MuellerDaniel/SensGlove/SensGlove_noVideo/arduino/LSM303_collectALL/README.txt

Code for data acquisition and sending via BLE of 4 sensor units
