MuellerDaniel/SensGlove/SensGlove_noVideo/arduino/LSMmagMPUquat/README.txt

Trying to cancel the surrounding magnetic field dynamically with the additional MPU sensor
