MuellerDaniel/SensGlove/SensGlove_noVideo/arduino/MagAHRS_MUX_LSM303_Ser/README.txt

Trying to estimate the orientation of the sensor unit solely based on the LSM sensor
