MuellerDaniel/SensGlove/thesis/texfiles/systemDesign.tex

\lhead[\chaptername~\thechapter]{\rightmark}

\rhead[\leftmark]{}

\lfoot[\thepage]{}

\cfoot{}

\rfoot[]{\thepage}

\chapter{System Design and Implementation} \label{cha:sysDesign}

\section{System Design} \label{cha:design}

Ma et al. \cite{ma2010magnetic} describe in their work an approach for hand pose estimation, using permanent magnets and sensors. Since this group is the only one using static magnets for hand state estimation, the design developed in this thesis relies partly on theirs. However, until now the group only presented results for reconstructing the motion of a single finger with six sensors. An image of their setup is shown in \ref{fig:MaSystem}.
\begin{figure}[h]
\centering

\caption[Magnetic system, developed by Ma et al.]
{The System for estimating the movement of one finger with 6 sensors, used by Ma et al. \cite{ma2010magnetic}}
\label{fig:MaSystem}
\end{figure}
The presented system is constructed to estimate the pose of four human fingers, neglecting the thumb (for details about the underlying hand model, see \ref{sec:handModel}). For this, four cylindrical permanent magnets are used. Their dimensional and magnetic characteristics are shown in \ref{tab:magDimensions}.
\begin{table}[h]
\centering
\begin{tabular}{c|c}
%	\hline
	Length & \SI{15}{\mm} \\ \hline
	Radius & \SI{2.5}{\mm} \\ \hline
	Material & Neodymium \\ \hline
	Remanence & 1.26-\SI{1.29}{\tesla} \\ \hline
	Type & axial magnetised \\ %\hline
\end{tabular}
\caption[Magnetic properties]{Magnetic and dimensional characteristics of the used cylindrical magnets.}
\label{tab:magDimensions}
\end{table}
Those components have to be mounted onto the fingertips. With a 3D printer ring like supports are designed, to ease the donning and doffing of the magnets and to ensure a secure positioning on the fingers. The bottom of the ring is left open, to make the components flexible for various finger diameters. The socket on top of the ring is constructed to statically hold and align the magnet. The magnetic field is measured with four \acp{IMU} (see \ref{cha:sensors}), placed inside a self designed bracket. This bracket is constructed to be worn on the back of the hand. It ensures, that the alignment and positioning of the sensors relative to each other is held static, which is important for the pose estimation (see \ref{sec:estimation}). Pictures of the individual parts and the designed system are shown in \ref{fig:designParts}. Since four magnets are used, the sensor array consists also of four measurement units. For an easy and reproducible first evaluation of the system, a wooden hand is used (see \ref{fig:sysWood}). This static setup ensures one to measure the positions and dimensions of the sensors, the joints and the bone lengths relatively accurate. To read out the sensor data, a RFduino microcontroller \cite{rfduino2015data} is used. This device is a clone of the Arduino environment \cite{arduino}, which simplifies the programming of the system. Since this part of the setup is only used to acquire the sensor data and perform basic signal processing tasks, the computational requirements are not very high. A plus of the RFduino device is, that a \ac{BLE} module is already built in. So the data can be send to a host PC, where the main processing and estimation steps are realized. A summary of the individual parts and their purpose is given in \ref{tab:systemParts}.
\begin{figure}[!h]
\centering
	\begin{tabular}{c c}
	\subfloat[Ring holders for magnets, worn on hand]
	{\label{fig:holderHand}}
	%\hfill
	&
	\subfloat[Sensor bracket and protoboard with RFduino.]
	{\label{fig:wearable}}\\
	%\hfill
	\subfloat[System attached to wooden hand.]
	{\label{fig:sysWood}}
	%\hfill
	&
	\subfloat[System attached to human hand.]
	{\label{fig:sysHuman}}
	\end{tabular}
\caption{Self designed system parts}
\label{fig:designParts}
\end{figure}
\begin{table}[h]
\centering
\begin{tabular}{l|l}
%\hline
\textbf{Component} & \textbf{Purpose} \\ \hline
4 Magnets & causing the magnetic field \\ \hline
4 \acp{IMU} & measuring the magnetic field \\ \hline
RFduino & data acquisition and forwarding \\ \hline
PC & sensor data interpretation and state estimation \\ %\hline
\end{tabular}
\caption[List of system parts]{Overview of the relevant system parts and their purpose}
\label{tab:systemParts}
\end{table}

\FloatBarrier

\section{Human Hand Model} \label{sec:handModel}

As already depicted in \ref{cha:relatedWork} and \ref{sec:anatomy}, the utilization of a proper kinematic model is a very important part, when it comes to  the interpretation and estimation of finger poses. In this section the kinematic model, used to reconstruct the finger positions is described. It relies on the presented observations from \ref{sec:anatomy}.

The underlying kinematic model tries to simplify the range of motion of the human hand, without loosing too much generality. Therefore the fingers are interpreted as ideal revolute joints. The complex movement of the thumb is totally neglected. The other four fingers naturally move mainly in one plane (by disregarding adduction-abduction), for the thumb however this does not hold. Trying to track the full five \ac{DOF} for this finger would make the model much more complex. Another point is, that the thumb moves mainly ``in front'' of the other fingers. This would cause remarkable influence on every sensor on the array, such that a distinction between the moving finger is more difficult. So for keeping the model and the pose estimation simple, the thumb will be neglected. As many other human hand models, the movement of the Metacarpal bones is neglected. Therefore the \ac{MCP} joints are assumed to be always at a static position. Since the presented approach focuses on finger pose estimation and the sensors are mounted on the back of the hand, the movement of the whole palm does not need to be taken into account. As already stated, the index, middle, ring and pinky finger show four \ac{DOF} each and can move in two planes by flexion-extension and adduction-abduction. For deriving a simpler hand model, the intra finger constraint for the joint angles of the \ac{DIP} and \ac{PIP} of one finger is used, being $ \theta_{DIP} = \frac{2}{3} \theta_{PIP} $. So in the end one finger has 3 \ac{DOF}. As a further step, this model can even be more simplified, by neglecting adduction-abduction and resulting in a system with 2 \ac{DOF} per finger. The range of movement of the joints is assumed to be as described in \cite{lin2000modeling}. This means for the flexion-extension angle for the \ac{MCP} being within $ \ang{0} \leq \theta_{MCP} \leq \ang{90} $ and the range of adduction/abduction $ \ang{-15} \leq \phi_{MCP} \leq \ang{+15} $. The flexion-extension range for the \ac{PIP} lies within $ \ang{0} \leq \theta_{PIP} \leq \ang{110} $\\
In the end every finger is modelled equally as a kinematic chain with 3 joints, having 3 \ac{DOF} in total. The position and orientation of the fingertip, and therefore of the magnet, is fully determined by the angles of the finger joints, using forward kinematics.\\
For a better visualization, the kinematic chain and the relevant parts are sketched in \ref{fig:handMod} for a single finger. The Cartesian coordinate system, used in this drawing is adapted to the sensor alignment. This system convention is used throughout the whole thesis.
\begin{figure}[!htb]
\centering
\subfloat[The lengths of the bones and the corresponding joint names are visualized. The positions of the magnet, the sensor and the direction vector $ \vec{r} $ is further drawn.]
{\input{pictures/handModelJoin.tex}}
\hfill
\subfloat[The joint angles, as they are described in the text. The direction vector $ \vec{h} $ is pointing in the same direction as the magnetic dipole moment.]
{\input{pictures/handModelAng.tex}}

\caption[The introduced hand model.]
{The introduced representation of the human hand as a kinematic chain. For clarity, only a single finger is drawn. Figure (a) shows the location of the sensor, magnet and the joints. Also the direction vector $ \vec{r} $ is drawn. In figure (b), the joint angles are visualized and the direction $ \vec{h} $ of the magnet is drawn. The Cartesian coordinate system is aligned according to the sensor frame. This coordinate system defines the orientation, used throughout the whole thesis. The \ac{MCP} joint lies on the y-Axis.}
\label{fig:handMod}
\FloatBarrier
\end{figure}
For the calculation of the magnetic flux density according to the models, introduced in \ref{sec:magneticFound}, the distance vector from sensor to magnet and the orientation of the latter one is needed. Those two components can be derived using forward kinematics and the positions of the sensors and the joints.\\
The orientation vector $ \vec{h} $ is derived in the following way:
\begin{equation}\label{eq:orienH}
\begin{aligned}
h_{x} =& \cos(-\theta_{\mathrm{MCP}}-\theta_{\mathrm{PIP}}-\theta_{\mathrm{DIP}})\\[3pt]
h_{y} =& \cos(-\theta_{\mathrm{MCP}}-\theta_{\mathrm{PIP}}-\theta_{\mathrm{DIP}})\sin(\phi)\\[3pt]
h_{z} =& \sin(-\theta_{\mathrm{MCP}}-\theta_{\mathrm{PIP}}-\theta_{\mathrm{DIP}})\cos(\phi)
\end{aligned}
\end{equation}

The position vector $ \vec{r} $ of the magnet is determined by
\begin{equation}\label{eq:posX}
\begin{aligned}
r_{x} =\,&  l_{Prox}\sin(\frac{\pi}{2}-\theta_{\mathrm{MCP}}) +\\
& l_{Mid}\sin(\frac{\pi}{2}-(\theta_{\mathrm{MCP}}+\theta_{\mathrm{PIP}})) +\\
& l_{Dist}\sin(\frac{\pi}{2}-(\theta_{\mathrm{MCP}}+\theta_{\mathrm{PIP}}+\theta_{\mathrm{DIP}})) + (P_{\mathrm{MCP}_{x}} - P_{Sensor_{x}}) \\[4pt]
r_{y} =\,&  l_{Prox}\cos(\frac{\pi}{2}-\theta_{\mathrm{MCP}}) +\\
& l_{Mid}\cos(\frac{\pi}{2}-(\theta_{\mathrm{MCP}}+\theta_{\mathrm{PIP}})) +\\
& l_{Dist}\cos(\frac{\pi}{2}-(\theta_{\mathrm{MCP}}+\theta_{\mathrm{PIP}}+\theta_{\mathrm{DIP}}))\sin(\phi) + (P_{\mathrm{MCP}_{y}} - P_{Sensor_{y}}) \\[4pt]
r_{z} =&  -l_{Prox}\cos(\frac{\pi}{2}-\theta_{\mathrm{MCP}}) +\\
& l_{Mid}\cos(\frac{\pi}{2}-(\theta_{\mathrm{MCP}}+\theta_{\mathrm{PIP}})) +\\
& l_{Dist}\cos(\frac{\pi}{2}-(\theta_{\mathrm{MCP}}+\theta_{\mathrm{PIP}}+\theta_{\mathrm{DIP}}))\cos(\phi) +(P_{\mathrm{MCP}_{z}} - P_{Sensor_{z}})
\end{aligned}
\end{equation}
with $ l_{Prox}, l_{Inter}, l_{Dist} $ being the bone lengths of the proximal, intermediate and distal phalanges. $ P_{MCP} $ the position of the \ac{MCP} joint and $ P_{Sensor} $ the position of the sensor. Those hand dimension parameters are very important, since they define the expectable distance vector $ \vec{r} $ and have therefore an influence for calculating the magnetic flux density. Remember, that $ \vec{r} $ contributes nonlinearly to the magnetic models and therefore to the expected flux density. The hand dimension parameters should be determined very exact, to get a right representation of the proband, wearing the system. However, they can only be measured up to a certain grade of accuracy, since the bones and joints lie underneath the skin. An x-ray could provide exact anatomic values, but this would seem to break the range of effort. Therefore in the end a calliper is used for identifying the anatomic bone lengths and the sensor and joint positions of the hand. As mentioned, this has to be done very accurate to get a detailed representation of the fingers. If the model should be further simplified, the lateral movement of adduction-abduction could be neglected. One just has to set the $ \phi $ value to 0. From that it directly follows, that the orientation and position vectors have only contributions on the $ x $- and $ z $-axis. The $ y $-component stays 0.

Summarizing the derived hand model, one can define the state space of one finger pose to be completely described by 3 angular values (for the version neglecting adduction-abduction, the state space reduces to 2), being
\begin{equation*}
\begin{aligned}
x &= \begin{bmatrix}
				\theta_{\mathrm{MCP}}\\
				\theta_{\mathrm{PIP}}\\
				\phi_{\mathrm{MCP}}
\end{bmatrix}
\end{aligned}
\end{equation*}
This state vector is further also refereed as the finger state vector. Thus all four fingers together have a state space of size 12. The presented model shows a basic approach to model the index, middle, ring and pinky finger of the human hand as ideal revolute joints. The constraints and simplifications introduced are comparable to other groups \cite{lin2000modeling}. The biggest simplification however is the disregard of the thumb movement.

\FloatBarrier

\section{Sensor Design and Data Acquisition} \label{cha:sensors}

For measuring the magnetic field, four LSM303D sensors from ST are used \cite{STlsm2012}. This device comprises a 3 axis accelerometer and a 3 axis magnetometer in one module. It is chosen, because its magnetic full-scale range is selectable. It can be determined to $ \pm 0.2$, $ \pm 0.4 $, $ \pm 0.8 $ or $ \pm 1.2\si{\milli\tesla} $. The magnetic values are stored in 2 Bytes in 2's complement. The sensitivity per \ac{LSB} is specified like shown in \ref{tab:magSensitivity}.
\begin{table}[h]
\centering
\begin{tabular}{c|l}
%\hline
\textbf{Measurement Range [\SI{}{\milli\tesla}]} & \textbf{Sensitivity [\SI{}{\micro\tesla \per LSB}]} \\ \hline
$ \pm 0.2 $ & 0.080 \\ \hline
$ \pm 0.4 $ & 0.160 \\ \hline
$ \pm 0.8 $ & 0.320 \\ \hline
$ \pm 1.2 $ & 0.479 \\ %\hline
\end{tabular}
\caption[Magnetic sensitivity]{Magnetic sensitivity for the corresponding measurement range, according to the datasheet of the LSM303D sensor unit \cite{STlsm2012}.}
\label{tab:magSensitivity}
\end{table}
The data rate can be set to a maximium of \SI{100}{\Hz}. The communication is established via a standard I2C bus, which means that a clock frequency of \SI{100}{\kilo \Hz} is used. In the end a breakout version of this device, available from Pololu \cite{pol2016} is used. It is sold as a full 9 \ac{DOF} IMU, carrying the LSM303D and L3GD20H gyroscope. However, since the gyroscope and the accelerometer are not further used, they won't be explained here in detail. A picture of the breakout board is shown in \ref{fig:breakout}. The communication is realised with an RFduino microcontroller. This device can be programmed via the Arduino environment, which simplifies the process. It comes with a built in \ac{BLE} module. This is used to send the data to a host PC, where the state estimation process is programmed. Since the same sensor is used four times on a single I2C bus, a small work around is established, to enable an individual communication to each one of the four sensors. The clock signal is splitted via a multiplexer and only redirected to the device, from which the data is desired. This ensures, that each sensor can be read out individually. Combining the data lines of the sensors and multiplexing the clock signal to each device individually leads to a single data information on the bus. As multiplexer, a breakout of the CD74HC4067 from Texas Instruments is used \cite{TImux2003}.
\begin{figure}
\centering

\caption[Breakout board of sensor unit]
{The utilized MinIMU-9 v3 breakout board from Pololu \cite{pol2016}}
\label{fig:breakout}
\end{figure}

\FloatBarrier

\section{Calibration and Preprocessing of Sensor Data} \label{sec:caliPrepro}

\subsection{Calibration for Hard and Soft-Iron Coefficients} \label{subsec:hardSoft}

Magnetic sensors in general suffer from two main distortion effects, being the hard and soft-iron coefficients. Those parameters are caused by manufacturing processes, ferromagnetic materials on the \ac{PCB} and the immediate environment of the sensor \cite{ozyagcilar2012calibrating}. If the device is moved in a field, free of artificial magnetic distortion, it should only measure the influence due to the earth's magnetic field. An ideal device would measure a constant value for the field strength, no matter in which way it is oriented. In other words, holding the device, such that the full earth field has only influence on the $ z $-axis, should provide the same result on the other axes, when rotating it to the corresponding one. So in the end by measuring the earth magnetic field at various positions and plotting it, should result in a perfect sphere, centered at the origin. Due to the hard iron distortions the sphere is not perfectly located at the center. This effect is produced by materials, exhibiting a constant additive field, like wires or small ferromagnetic components, placed onto the \ac{PCB} \cite{konv2009}. Soft iron effects however, cause that the shape of the sphere is deformed to an ellipsoid. They are induced by materials, influencing the pervasion of magnetic field lines and causing different gains on the axes. An example would be metallic materials such as iron or nickel. So in the end the shape of the expected sphere is more like an ellipsoid, shifted from the origin. A visualization can be seen in \ref{fig:hardSoft}.\\
\begin{figure}
\centering

\caption[Calibrated and uncalibrated sensor data]
{The plot shows the obtained sensor values for the earth magnetic field, by moving the sensor in space. The ellipsoid on the right side shows the influence of hard and soft-iron distortion coefficient. The red dots represent the uncalibrated measurements. The sphere around the blue dots on the left displays the calibrated, perfect sensor values \cite{ozyagcilar2012calibrating}.}
\label{fig:hardSoft}
\end{figure}
The static hard-iron effects can be modelled as an offset $ H $, shifting the magnetic values. The soft-iron effects are represented by a $ 3\times3 $ matrix $ W $, transforming the sphere into an ellipsoid. So in order to describe the measurement of a sensor in absence of artificial magnets, one could utilize the following model for the observable distorted magnetic flux density of the earth:
\begin{equation} \label{eq:hardSoftModel}
\mathrm{B}_{earth} = W^{-1} (\mathrm{B}_{meas} - H)
\end{equation}
To determine and overcome these two distortion factors, several methods exist. For a naive approach, the offset parameters $ H $ can be determined like the following. One takes the average between the measured maximum and minimum along one axis. \ref{eq:simpleOffset} shows this exemplary for the $ x $-axis.
\begin{equation} \label{eq:simpleOffset}
\mathrm{off}_{x} = \frac{x_{max} + abs(x_{min})}{2}
\end{equation}
The six soft-iron parameters can be specified, by performing an ellipsoid fit. However, by using a more naive approach, one could perform a trivial compensation of those. The influence of the soft-iron distortion can be modelled as a one dimensional vector, increasing or decreasing the overall measured field along one axis. For this, the average amounts of the obtained magnetic field, representing the  ``radius'' of each axis are determined. Those three values are averaged, to return the overall radius $ rad_{avg} $. \ref{eq:simpleScale} show how to derive this scaling factor for the $ x $-axis.\\
\begin{equation} \label{eq:simpleScale}
\begin{aligned}
rad_{x} &= \frac{x_{max} - x_{min}}{2}\\
rad_{avg} &= \frac{rad_{x} + rad_{y} + rad_{z}}{3}\\
scale_{x} &= \frac{rad_{avg}}{rad_{x}}
\end{aligned}
\end{equation}
Kok et al. \cite{kok2012calibration} follow a more elaborated approach, by applying an elliptical fit in combination with measurements of inertial sensors. This approach also cares for the alignment of the magnetometer sensor axes  with the ones of the gyroscope and accelerometer. Since only the magnetic sensor is used for the further experiments, this can be neglected. The Application Note 4246 by Freescale \cite{ozyagcilar2012calibrating} presents a good and interesting calibration procedure. They reduce the determination of the three hard- and the nine soft-iron factors to four parameters. This is utilized, by assuming that the hard-iron offset dominates the soft-iron effects and one is trying to minimize the error between the measured field $ \mathrm{B}_{meas} $ and the real, surrounding field $ \mathrm{B}_{earth} $. For this, they take a whole series of measurements into account, and not just the minimum and maximum, like for the naive approach in \ref{eq:simpleOffset}. As a result, one gets a vector with the three offset values $ H $ and the flux density of $ \mathrm{B}_{earth} $. 

In the end, independent on how the sensors get calibrated, this routine has to be performed for each sensor to get the individual parameters. Due to the performed calibration procedure, the measurement range of the sensor is slightly varied. As an additional step, the sensors have to be scaled to the same measurement range. 

%\subsection{Fitting the Sensor Data to the Model Equations} \label{subsec:modelFit}
%\todo{Write it a bit different!\\}
%Another preprocessing step concerning the measurements, is an additional adaptation of the observed sensor values to the model equations. After the calibration phase, it can happen, that on the one hand the sensor readings are calibrated and show all the same measurement range, but on the other hand, those values have to be set in relation to the actual model equations, to represent the de-facto magnetic flux density. In other words, the calibration of the sensors is improved through this step. The difference between the model and the observable sensor values comes also from the scaling to a common value for the earth magnetic field. No normed sensor was at hand to determine the real earth magnetic field at the calibration position at the lab, therefore just one value was chosen, to fit all sensors to. Further on the presented calibration procedures are not totally fault-free. The scaling factors are expected to be small. For this step, a rigid, non metallic construction would be ideal. However this was not available. In return an almost accurate fitting procedure is evaluated.
%
%The calibrated sensors are placed inside the rack and attached onto a small box. A magnet with known characteristics is moved on a predefined path with fixed orientation in front of them. The set up and the movement should result into a three dimensional influence for all sensors. By holding and moving the magnet, the distance vector $ \vec{r} $ and the orientation is known. So the values for the magnetic field can be estimated for each sensor. Those serve as a ground truth for the scaling of the sensor data. In \ref{fig:caliFlat} a picture of the set up is shown. Since this procedure is performed on a normal table, with self determined position and orientation parameters and done \grqq by-hand \grqq, this process is fault prone. However it should still be possible to verify the calibration procedure and push the sensor data towards the predictions of the model equations.
%
%\todo{Describe it more!!! Say that the hand parameters cannot be determined good enough blablabla\\}
%Another calibration method would be the introduction of an initialization gesture on the hand. Beforehand the dimensions on the hand and the sensor and finger positions have to be measured. The gesture consists of bending all four \ac{MCP} joints simultaneously around \SI{90}{\degree}. To make this process reproducible, the gesture should be performed along a rectangular piece of cardboard (Pictures are provided at \todo{find/make pictures!} \ref{fig:caliHand}). Again this movement can easily be simulated by the model equations and the measurements can be fitted to them. For this approach, the exact determination of the hand dimensions is critical, since they play a fundamental role in the calculation of the position vector $ \vec{r} $ for the magnetic field models (see \ref{eq:posX}). Those values comprise the lengths of each bone, the sensor and joint positions. A fit to a wrong set of localizations and dimensions would lead to wrong predicted magnetic flux densities and could degrade the results of the pose estimation. Since it is not possible to determine those parameters exactly by hand, and since they vary slightly by movement, those scaling factors are expected to fluctuate within various measurement sets. However this method represents an application driven fitting procedure and will probably lead to better results for the pose estimation, what is the overall aim of the system. Since the scaling values slightly change with the movement and placement of the sensor rack on the hand and by the provided hand parameters, those values have to be defined each time.
%\begin{figure}[h]
%\centering
%\includegraphics[width=0.6\textwidth]{pictures/caliFlat1.JPG}
%\caption{Setup for easy calibration on table. The magnet is moved on a predefined path along the arrows. \todo{insert arrows and coordinate frame! Add a picture with straigth and 90 orientation of hand}}
%% for this look at http://tex.stackexchange.com/questions/198492/how-can-i-annotate-a-figure-with-lines-and-circled-numbers
%% or just google for "latex anotate figure"
%\label{fig:caliFlat}
%\end{figure}

\FloatBarrier

\subsection{Cancellation of the Surrounding Earth Magnetic Field} \label{subsec:earthEli}

The magnetic models, introduced in \ref{sec:magneticFound} describe the influence of the magnets at a certain position and orientation, relative to the sensor. Another observation proven in that chapter is that multiple magnetic fields sum up. On earth we focus a static surrounding magnetic field, going from the south pole to the north pole. Depending on the position at the planet, this value ranges from 25 - \SI{65}{\micro \tesla}. This field cannot easily be shut down and automatically contributes to the sensor measurements. However, for a proper interpretation of the surrounding field, solely determined by the permanent magnets, the earth field has to be eliminated. For a system with static geological sensor position and orientation, this would be trivial. One would just measure the field without any artificial magnets around and subtract this from every ongoing measurement. Obviously, the geological position and orientation of the human hand during normal tasks is naturally not static.\\
By knowing the orientation of the system and the corresponding earth magnetic field, it should be possible, to eliminate this offset. The following cancellation process is utilized, to get the earth magnetic field, relative to the sensor position:\\
\begin{enumerate}
\item Hold the hand with the sensors attached in a stable and calm position
\item The magnets for the fingertips are absent
\item Measure the orientation $ R_{I} $ of the sensors and the corresponding surrounding earth magnetic field $ \mathrm{B}_{earth} $
\item After this calibration phase, one tracks the orientation of the hand $ R_{h} $
\item Calculate the relative orientation $ R_{d} = R_{I} - R_{h} $
\item Convert $ R_{d} $ into a rotation matrix $ rot_{d} $ and apply this to $ \mathrm{B}_{earth} $
\item Subtract the rotated earth magnetic field from your actual measurement, s.t. \\ $ \mathrm{B} = \mathrm{B}_{meas} - rot_{d} \cdot \mathrm{B}_{earth} $
\end{enumerate}
As stated in \ref{cha:sensors} the used sensor breakout comes with a full 9 \ac{DOF} \ac{IMU}. With such a system the orientation can be estimated. The Madgwick filter \cite{madgwick2010efficient} is a widely used method for deriving the absolute orientation of a body in space, by using gyroscope, accelerometer and magnetometer data. However, this estimation uses the earth magnetic field, to compensate sensor drifts and to align its orientation, relative to it. So by introducing artificial magnets, which are stronger than the earth magnetic field, the Madgwick filter could break down and therefore the calculated orientation can drift. In \ref{subsec:resEarthEli} the evaluation of this approach is shown. 

\section{Magnetic Field Interpretation Towards Finger Pose Reconstruction} \label{sec:magmodel}

For the following section it is important to note, that the Cartesian coordinate system, introduced in \ref{sec:handModel} and visualized in \ref{fig:handMod} is applied. It represents the orientation of the sensor frame. The following two sections show how to calculate the three dimensional magnetic field value $ \mathrm{B}(x) $ for the finger state vector $ x $. As mentioned in \ref{sec:handModel}, the position of the sensors $ P_{sensor} $, the lengths of the phalanges and the static positions of the \ac{MCP} joints $ P_{MCP} $ have to measured very exactly, to get a proper value for the expectable magnetic flux density for a certain finger pose. 

For describing a magnetic flux density with the dipole model (\ref{eq:dipole}), introduced in \ref{sec:magneticFound}, one has to define the vectors $ \vec{r} $ and $ \vec{h} $ accordingly. The derivation of those two for a certain finger state $ x $, according to the kinematic chain is described in \ref{sec:handModel} (see \ref{eq:orienH} and \ref{eq:posX}). For describing the magnetic flux density of a certain finger state with the cylindrical bar magnet model, some further adjustments have to be done. Since the model uses cylindrical coordinates ($ z, \rho, \varphi $), the Cartesian ($ x, y, z $) of the sensor and magnet positions have to be transformed. One also has to note, that the values, calculated by this model assume, that sensor and magnet are aligned equally and refer to the same coordinate frame. Since the magnet is rotating around the $ y $- (by flexion-extension) and $ z $-axis (by adduction-abduction) and the sensor keeps its static orientation on the back of the hand, the alignment of the two components relative to each other changes. To overcome this, the Cartesian values of the distance vector $ \vec{r} $ have to be rotated about the orientation of the magnet. The following formulas describe the required rotation and transformation adjustments:
\begin{equation}
\begin{aligned}
\vec{r}_{rot} &= rot_{y}(\theta_{\mathrm{MCP}} + \theta_{\mathrm{PIP}} + \theta_{\mathrm{DIP}}) \cdot rot_{z}(\phi) \cdot \vec{r}\\
	&= rot_{y}(\theta_{\mathrm{MCP}} + \frac{5}{3} \theta_{\mathrm{PIP}}) \cdot rot_{z}(\phi) \cdot \vec{r}\\[3pt]
z &= \vec{r}_{rot}[0]\\
\rho &= \sqrt{\vec{r}_{rot}[1]^{2} + \vec{r}_{rot}[2]^2}\\
\varphi &= \arctan(\vec{r}_{rot}[1], \vec{r}_{rot}[2])
\end{aligned}
\end{equation}
Those values can now be applied to \ref{eq:cylB_rho} and \ref{eq:cylB_z} to obtain the cylindrical magnetic flux density. In order to transform those components back to Cartesian again, the following calculations have to be done
\begin{equation}
\begin{aligned}
\mathrm{B}_{x_{rot}} &= \mathrm{B}_{z}\\
\mathrm{B}_{y_{rot}} &= \mathrm{B}_{\rho}sin(\varphi)\\
\mathrm{B}_{z_{rot}} &= \mathrm{B}_{\rho}cos(\varphi)\\[3pt]
\mathrm{B} &= (rot_{y}(\theta_{\mathrm{MCP}} + \frac{5}{3} \theta_{\mathrm{PIP}}) \cdot rot_{z}(\phi))^{-1} \cdot \mathrm{B}_{rot}
\end{aligned}
\end{equation}
As already depicted in \ref{sec:magneticFound}, the exact solution of a \ac{CEL} is not trivial to calculate. Bulirsch et al. \cite{bulirsch1965numerical} describe some approaches in their work to approximate the result. They extend ideas of Landen and Gauss for the solution. The used calculation algorithm can be found in \cite{derby2010cylindrical}. Since it is a numerical approximation it uses a loop, to terminate at a certain accuracy level. This induces, that the function can not be further treated as a natural equation, when it comes to further differentiation.

\section{Hand State Estimation} \label{sec:estimation}

Assumed is a system with $ K $ magnets and $ N $ sensors. So the objective is to track $ K $ fingers, by taking the measurements from $ N $ sensor units into account. The beforehand models for deriving the magnetic flux density are referred equally as $ \mathrm{B}_{n}(x_{k}) $ representing the field at sensor $ n $, excited by the state vector $ x_{k} $ of finger $ k $. Since magnetic fields sum up, for $ K > 1 $, this is a cumulative sum over all the presented magnets, being
\begin{equation}
\mathrm{B}_{n} = \sum_{k=1}^{K} \mathrm{B}_n(x_{k})
\end{equation}
for sensor $ n $. Since the state $ x_{k} $ consists of 3 values, the complete system state vector has a shape of $ (3 \cdot K) \times 1 $ and is denoted by
\begin{equation}
\begin{aligned}
\mathrm{X}_K &= \begin{bmatrix} x_{1} & x_{2} & \cdots & x_{K}  \end{bmatrix}^{T}\\
 &= \begin{bmatrix} \theta_{\mathrm{MCP}_{1}} & \theta_{\mathrm{PIP}_{1}} & \phi_{\mathrm{MCP}_{1}} & \theta_{\mathrm{MCP}_{2}} & \cdots \end{bmatrix}^{T}
\end{aligned}
\end{equation}
the overall calculated magnetic flux densities corresponding to the complete system state $ \mathrm{X}_{K} $ by the $ N $ sensor units is 
\begin{equation}
\begin{aligned}
\mathrm{M} &\equiv \begin{bmatrix} {\mathrm{B}}_{1} & {\mathrm{B}}_{2} & \cdots & {\mathrm{B}}_{N} \end{bmatrix}^{T}\\
		&= \begin{bmatrix}
			\sum_{k=1}^{K} \mathrm{B}_1(x_{k})\\
			\sum_{k=1}^{K} \mathrm{B}_2(x_{k})\\
			\vdots \\
		    \sum_{k=1}^{K} \mathrm{B}_N(x_{k})\\
		\end{bmatrix} \\
	    &= \mathrm{M}(\mathrm{X}_K)
\end{aligned}
\end{equation}
The actual obtained measurement of sensor $ n $ is denoted by $ \tilde{\mathrm{B}}_{n} $, the measurement array of all sensors $ N $ has a shape of $ (3 \cdot N) \times 1 $ and is represented by
\begin{equation}
\begin{aligned}
& \tilde{\mathrm{M}} \equiv \begin{bmatrix} \tilde{\mathrm{B}_{1}} & \tilde{\mathrm{B}_{2}} & \cdots & \tilde{\mathrm{B}_{N}} \end{bmatrix}^{T}\\[5pt]
& \text{with: }  \tilde{\mathrm{B}}_{n} = \begin{bmatrix} \tilde{\mathrm{B}}_{n}(x) & \tilde{\mathrm{B}}_{n}(y) & \tilde{\mathrm{B}}_{n}(z) \end{bmatrix}
\end{aligned}
\end{equation}
In order to derive an estimate of the system state $ \mathrm{X}_K $, one can formulate an optimization problem. The objective function $ f(\mathrm{X}_K) $ for the minimization between the actual sensor measurements and the state representation of the model is described by:
\begin{equation}
f(\mathrm{X}_K) = \frac{1}{2}|| \tilde{\mathrm{M}} - \mathrm{M}(\mathrm{X}_K) ||^{2}_{2}
\end{equation}
It is formulated as a least squares problem and therefore tries to minimize a scalar, by taking the L2 norm. The corresponding optimization problem is defined by:
\begin{equation} \label{eq:minimization}
%\begin{aligned}
%& \underset{\mathrm{X}_K}{\text{minimize}}  
%& & f(\mathrm{X}_K) \\
%& \text{subject to} 
%& & 0  & \leq & \; {x}_1(\theta_{MCP}) & \leq & \; 1/2 \cdot \pi, \\
%& & & 0  & \leq & \; {x}_1(\theta_{PIP}) & \leq & \; 110/180 \cdot \pi, \\
%& & & -30/180 \cdot \pi & \leq & \; {x}_1(\phi_{MCP}) & \leq & \; 30/180 \cdot \pi, \\
%& & & 0  & \leq & \; {x}_2(\theta_{MCP}) & \leq & \; 1/2 \cdot \pi, \\
%& & & & &  \vdots \\
%& & & -30/180 \cdot \pi & \leq & \; {x}_K(\phi_{MCP}) & \leq & \; 30/180 \cdot \pi
%\end{aligned}
\begin{aligned}
\underset{\mathrm{X}_K}{\text{minimize}} & & f(\mathrm{X}_K) \\
\text{subject to} & & 0 & \leq {x}_1(\theta_{\mathrm{MCP}}) & \leq & 1/2 \cdot \pi, \\
				  & & 0 & \leq {x}_1(\theta_{\mathrm{PIP}}) & \leq & 110/180 \cdot \pi, \\
				  & & -30/180 \cdot \pi & \leq {x}_1(\phi_{MCP}) & \leq & 30/180 \cdot \pi, \\
				  & & 0 & \leq {x}_2(\theta_{\mathrm{MCP}}) & \leq & 1/2 \cdot \pi, \\
				  & & & \vdots \\
				  & & -30/180 \cdot \pi & \leq {x}_K(\phi_{\mathrm{MCP}}) & \leq & 30/180 \cdot \pi
\end{aligned}
\end{equation}
The inequality constraints represent the natural range of motion for each finger. The determinedness of the system is dependent on the number of sensor measurements taken into account. The solvability and the uniquness of the result for this minimization is dependent on the determinedness of the system. To gather unique solutions, the system has to be fully determined ($ N = K $). Since one is trying to estimate the pose of four magnets, by also using four sensors, this condition is fulfilled. For minimizing such a function, one has to remember the mathematical form of the introduced magnetic models. The dipole model includes nonlinearities, the cylindrical model in contrary is solved by a numerical approximation, which in return means that differentiation or further mathematical operations can not be applied. Since the programming language \emph{Python} \cite{python} is used to solve this problem, it is referred to methods provided by the \emph{SciPy} \cite{scipy} package. The included \emph{minimize} method comes with several user definable options, to provide the solver with additional information. In \ref{subsec:resSim} the used optimization methods are explained and the performance and quantity of the results are compared. Anyway, to speed up the computational time for solving the equations and the optimization problem, the functions are implemented in Cython \cite{cython}. This interface allows to write C-like Python code and to work with predefined variables. 

\section{Visualization} \label{sec:visual}

Another part of the system is the visualization of the estimated states. On the one hand, the values could be displayed with a graph. This way is very good, to get an accurate insight in the outcome of the estimation phase and for comparing it to ground truth data. However, this approach is not very intuitive and for untrained people, like patients of a clinical study not very helpful. For this, an application with the Blender Game Engine \cite{blender} is implemented, which displays a 3D human hand. A 3D visual hand model is utilized. It already comes as a rigged component, which means that the bone structure is already given. This eases the further manipulation and setting of the corresponding finger angles. The bending of a joint can be modelled by rotating the corresponding points of the model. Blender provides a Python programming interface, for modifying and animating 3D models. The underlying Python script, changes the orientation of bones and concentrates on the very basics for representing the estimated states, by setting the corresponding finger angles. For communicating with the state estimation module, a simple text file is used. The real time state estimation writes its values each time at the very beginning of the file. This ensures to keep additional disk space on the executing system small, since only $ 3 \times K $ float values are written each step. The Blender Game is executed in a loop, constantly reading the first line of this file. To ensure transmission security, one has to note that the estimation phase should only be allowed to write complete lines, describing the whole actual state. Some screenshots of the application are provided in \ref{fig:blendGame}

\begin{figure}[h]
\centering
\subfloat[Fingers in stretched position]
{\label{fig:gameStretch}}
\hfill
\subfloat[Fingers in crooked position]
{\label{fig:gameCrooked}}
\caption{Screenshots of the visual representation with Blender}
\label{fig:blendGame}
\end{figure}

\FloatBarrier
