MuellerDaniel/SensGlove/praes/preasi-s.odp

## Magnetic Human Hand Motion Reconstruction

Master thesis

Daniel Müller

Embedded Systems Engineering

22.03.2016

## Systems for Hand Motion Reconstruction Vision based

- High accuracy possible, often used as ground truth
- Usually big and static systems
- Price and number of cameras rises with demanded accuracy [1, 2]

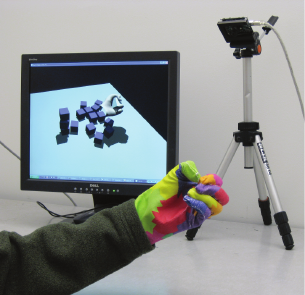
[picture p1: figure]
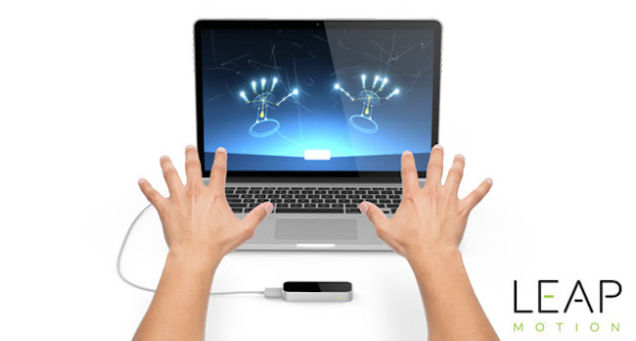
[picture p2: figure]
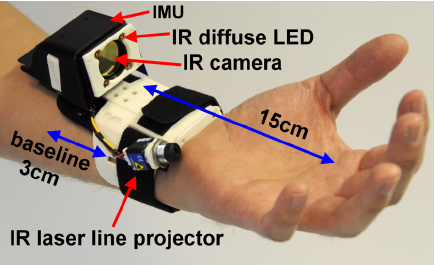
[picture p3: figure]

Notes: - Try to get a feeling for the existing approaches - Vison: - Very accurate → Ground truth - Static, big/bulky setup - Glove based: - IMU: many sensors needed, each sensor representes the orientation of the corresponding bone - Bend sensors - Bridge: another, not yet well explored approach: Magnets!

## Systems for Hand Motion Reconstruction Data gloves

- Mobile system
- IMUs or bend sensors used
- Accuracy is dependent on number of utilized sensor units [3]
- Placement of sensors is crucial
- Average error to vision based system around 7.1° [4]

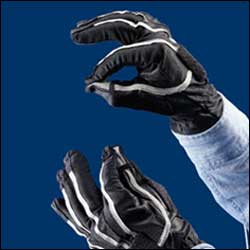
[picture p4: figure]
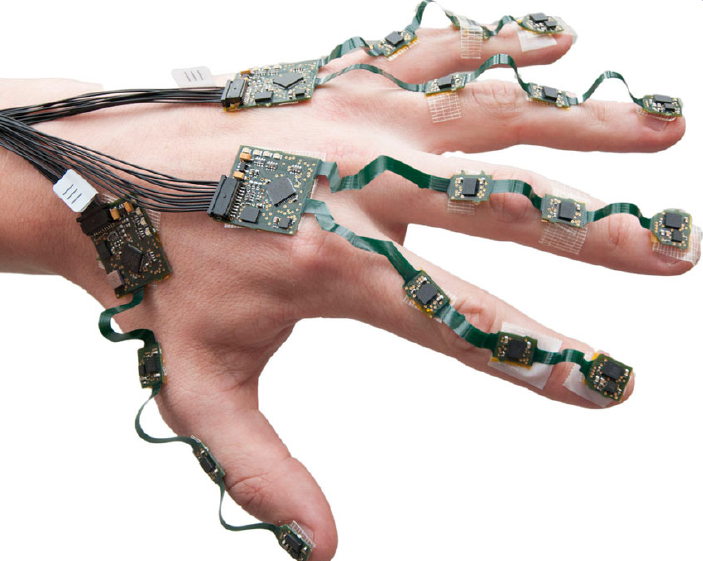
[picture p5: figure]
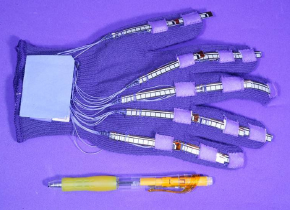
[picture p6: figure]

Notes: - Try to get a feeling for the existing approaches - Vison: - Very accurate → Ground truth - Static, big/bulky setup - Glove based: - IMU: many sensors needed, each sensor representes the orientation of the corresponding bone - Bend sensors - Bridge: another, not yet well explored approach: Magnets!

## Systems for Hand Motion Reconstruction Magnetic approach

- Passive magnetic system using magnets on fingertips [6]
  → Few publications on this
  → Promising approach to build a system which is:
    - Wearable
    - Cheap
    - Easy to use

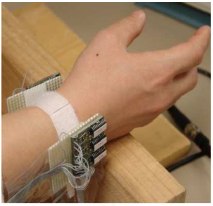
[picture p7: figure]

Notes: - Try to get a feeling for the existing approaches - Vison: - Very accurate → Ground truth - Static, big/bulky setup - Glove based: - IMU: many sensors needed, each sensor representes the orientation of the corresponding bone - Bend sensors - Bridge: another, not yet well explored approach: Magnets!

## Passive Magnetic Hand Motion Reconstruction

- Finger postures are determined by joint angles
- Minimizing a nonlinear objective function for estimating K fingers with N magnets

With : sensor measurements

: magnetic flux density for system state

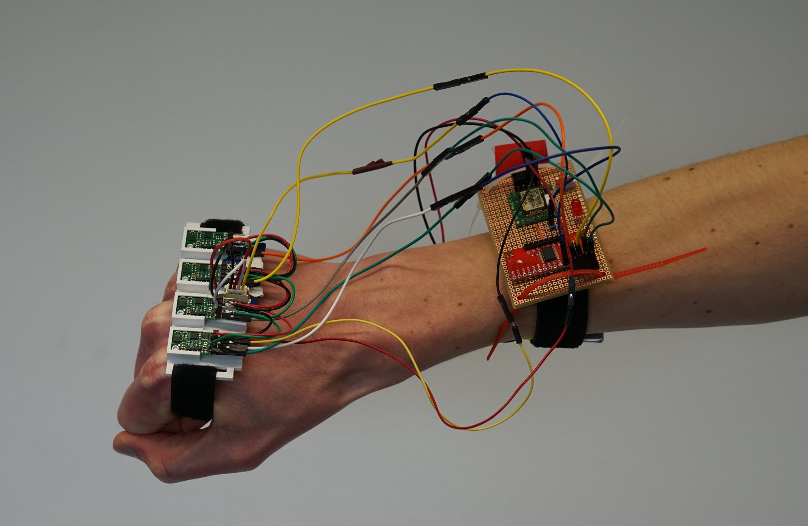
[picture p8: figure]
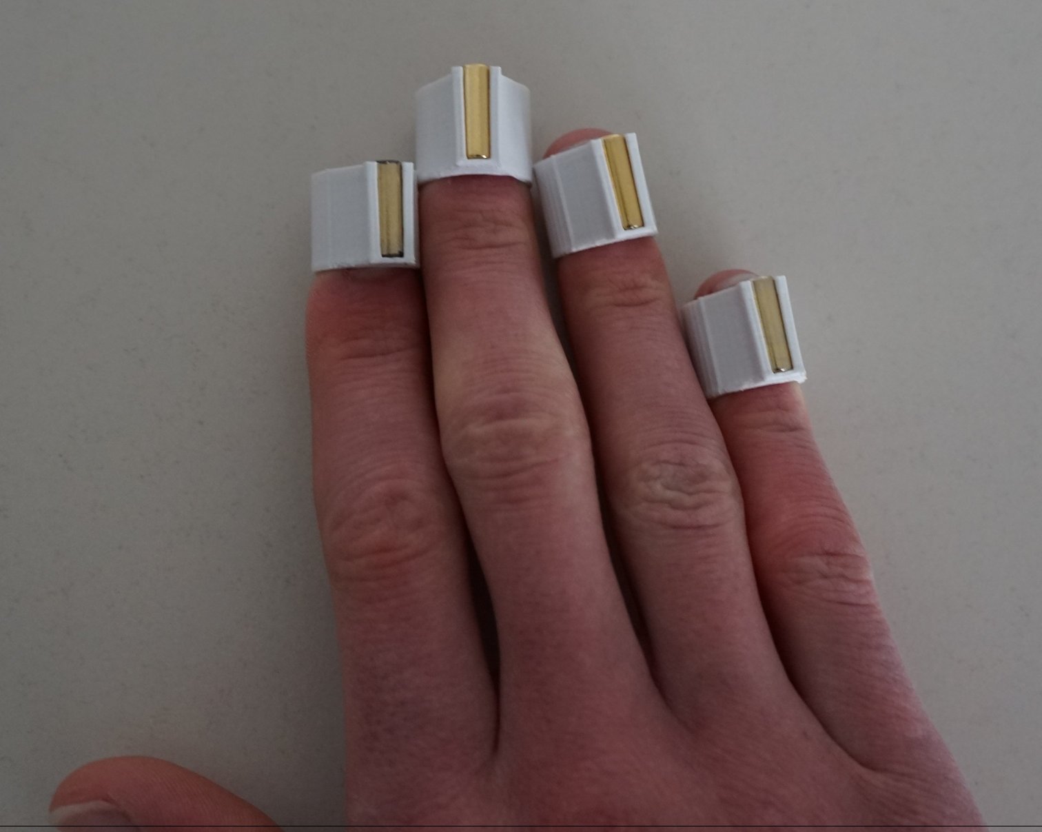
[picture p9: figure]

Notes: Explain approach briefly Magnets on fingertips, sensors on back of hand Picture of my system Try to minimize error between model representation and measurements (Sketch it visualy...) Make statement about system size / state size (dependent on how many measurements/fingers you use) Accompanied challenges (just name them?) Communication OK Sensor calibration OK Earth Cancellation NOT OK

## Modeling the Human Hand

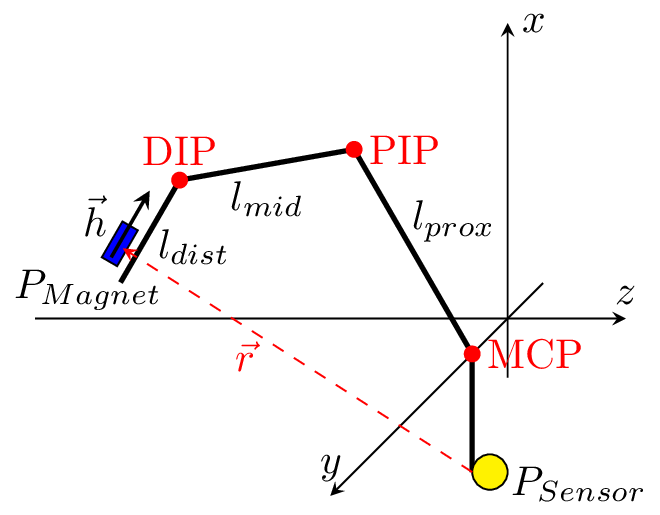
[picture p10: figure]
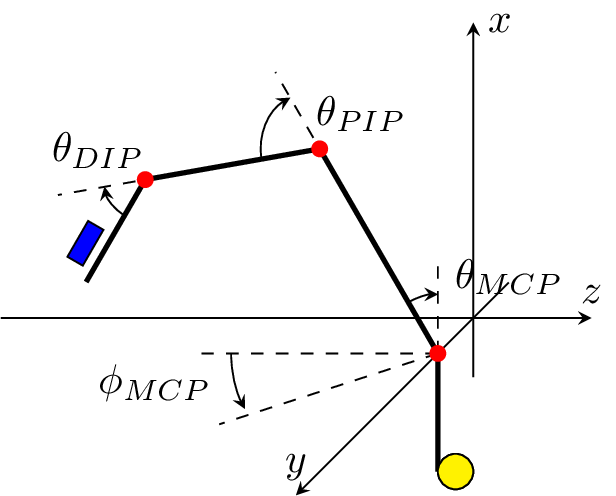
[picture p11: figure]

- Position and orientation of magnet relative to sensor unit is given by the joint angles of the kinematic chain
    → Exact determination of hand dimensions is important!
- Anatomics constrain range of motion and set and into relation [7, 8]
    → (single) Finger state vector
    → State vector size for estimating K fingers

Notes: - Make clear, that a finger posture is represented by the 3 angle values

## Modeling the static magnets

- Calculation of magnetic flux density by cylindrical model (numerical) [9]
- M is a cumulative sum over the K magnets for each of the N sensors
- Size of M:
- Nonlinearities introduced by position/orientation determination and magnetic models
- To get a fully determined system and unique solutions:

Notes: Mention magnetic foundations briefly From S to N, ... Dipole model assuming bar magnet is a dipole with small distance between S and N shape of magnet in magnetic moment Cylindrical model exact way approximate elliptical integral Transformation between Cartesian and Cyl. coordinates → you can plug in the positions and orientations calculated with hand model for each finger posture

## Evaluation of the System

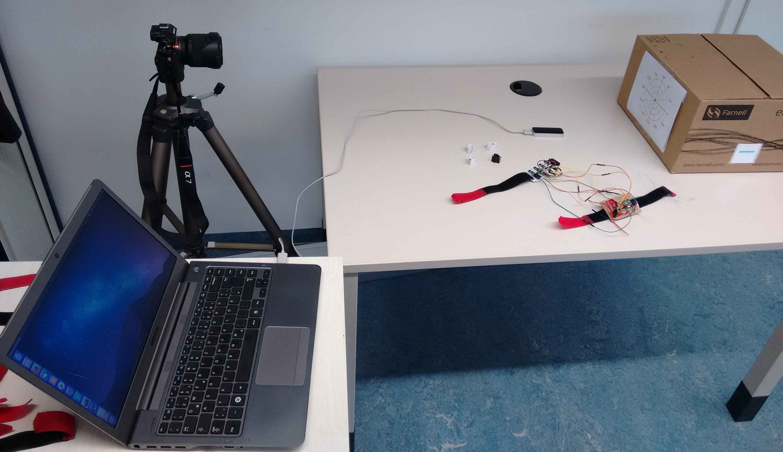
[picture p12: figure]

- Comparison to vision based system (Leap Motion)
- Post processing of recorded magnetic data for comparing different minimization formulations

Notes: Picture of setup Recording procedure, Leap comparison, offline - estimation

## Results Preliminary – Scaling the measurements

- High difference between model prediction and measurements
  → Induced by hand measured anatomic parameters
- For estimating 1 finger with 1 sensor already 9 values have to be determined
    → Estimation and tuning by trial-and-error not applicable
    → Linear scaling of measurements to model prediction leads to reasonable results

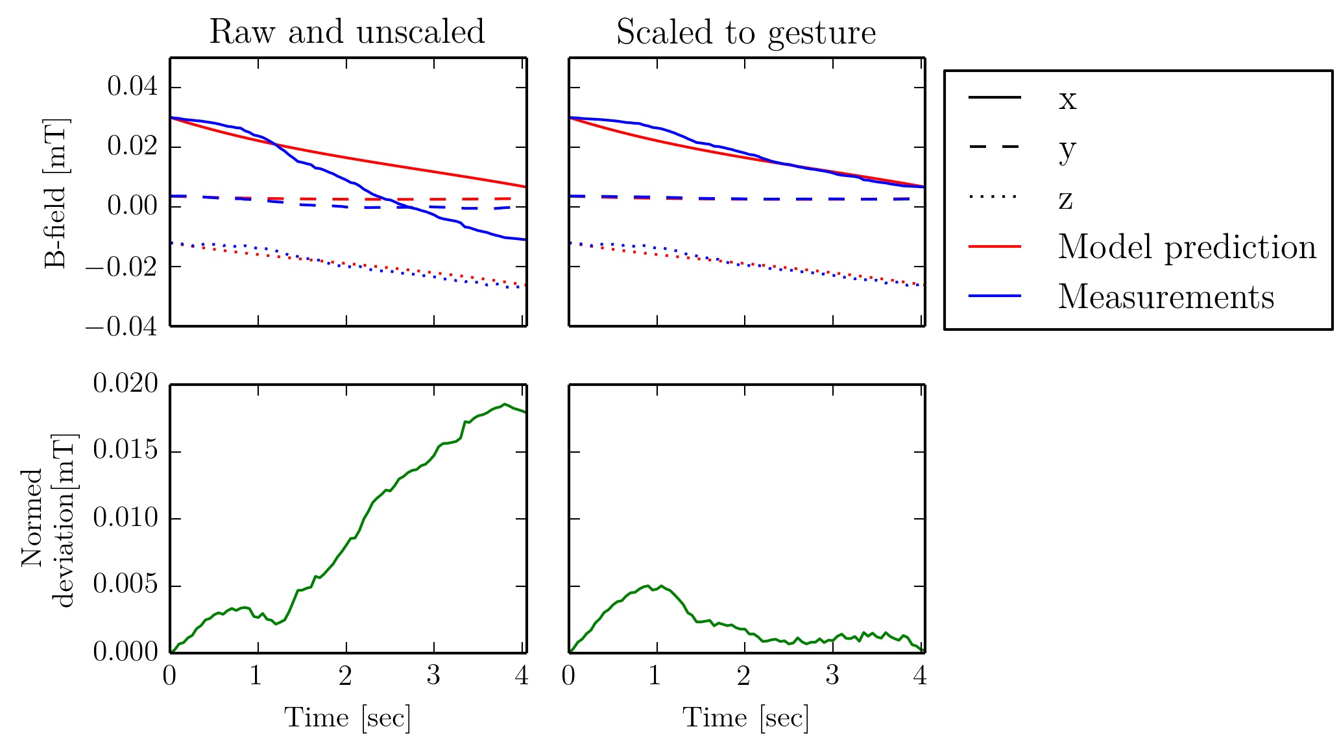
[picture p13: figure]

- Max deviation unscaled:
- Max deviation scaled:

Notes: Picture of setup Recording procedure, Leap comparison, offline - estimation

## Results Preliminary – Characteristics of Leap Motion

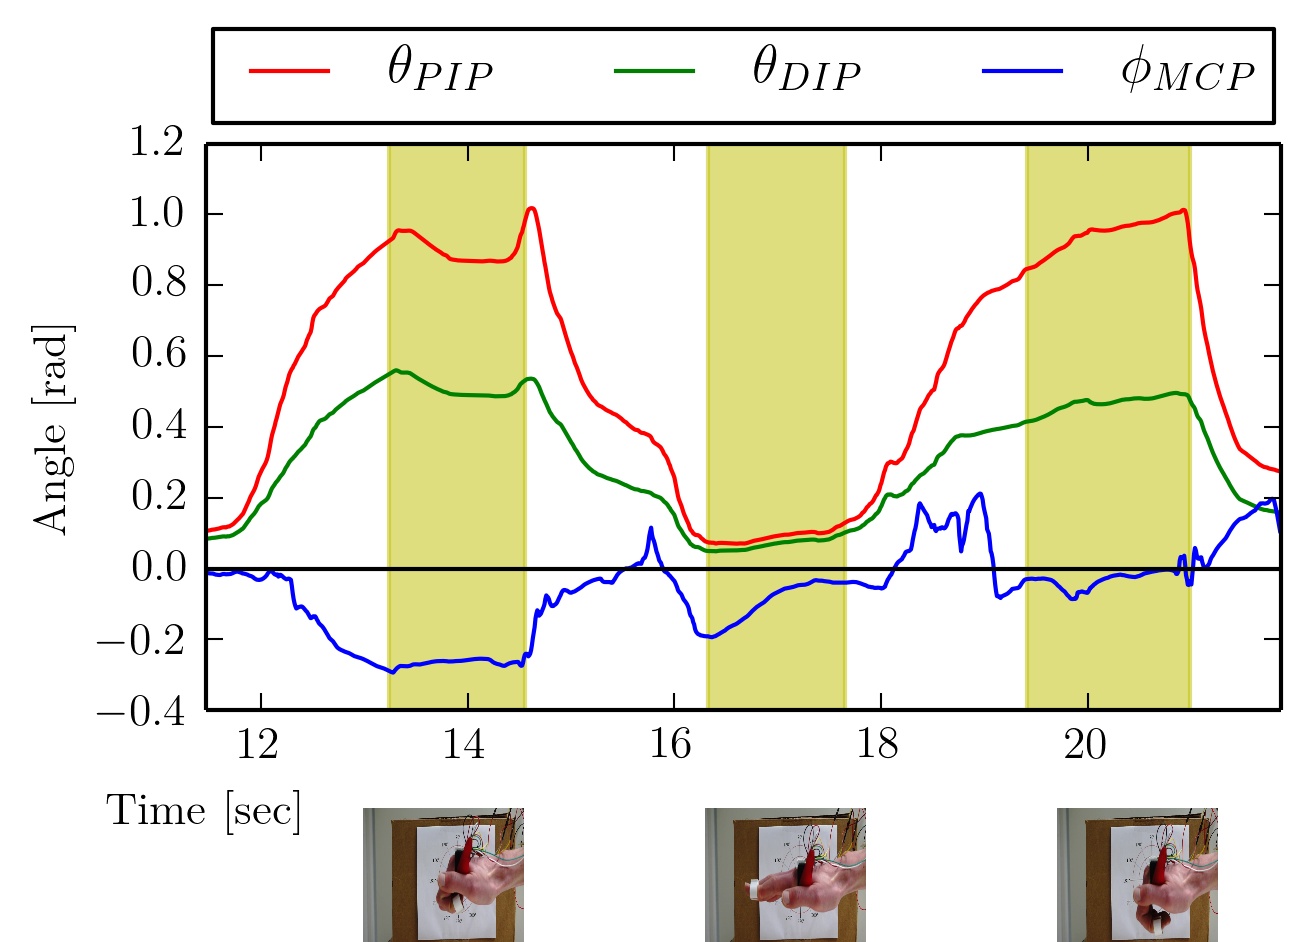
[picture p14: figure]

- Often false interpretation of lateral movement, which did not occur
  → Possibly introduced by direction estimation of Leap
  → Lateral movement of Leap has to be handled with care
- Minimum
- Maximum

Notes: Picture of setup Recording procedure, Leap comparison, offline - estimation

## Results Estimating four fingers

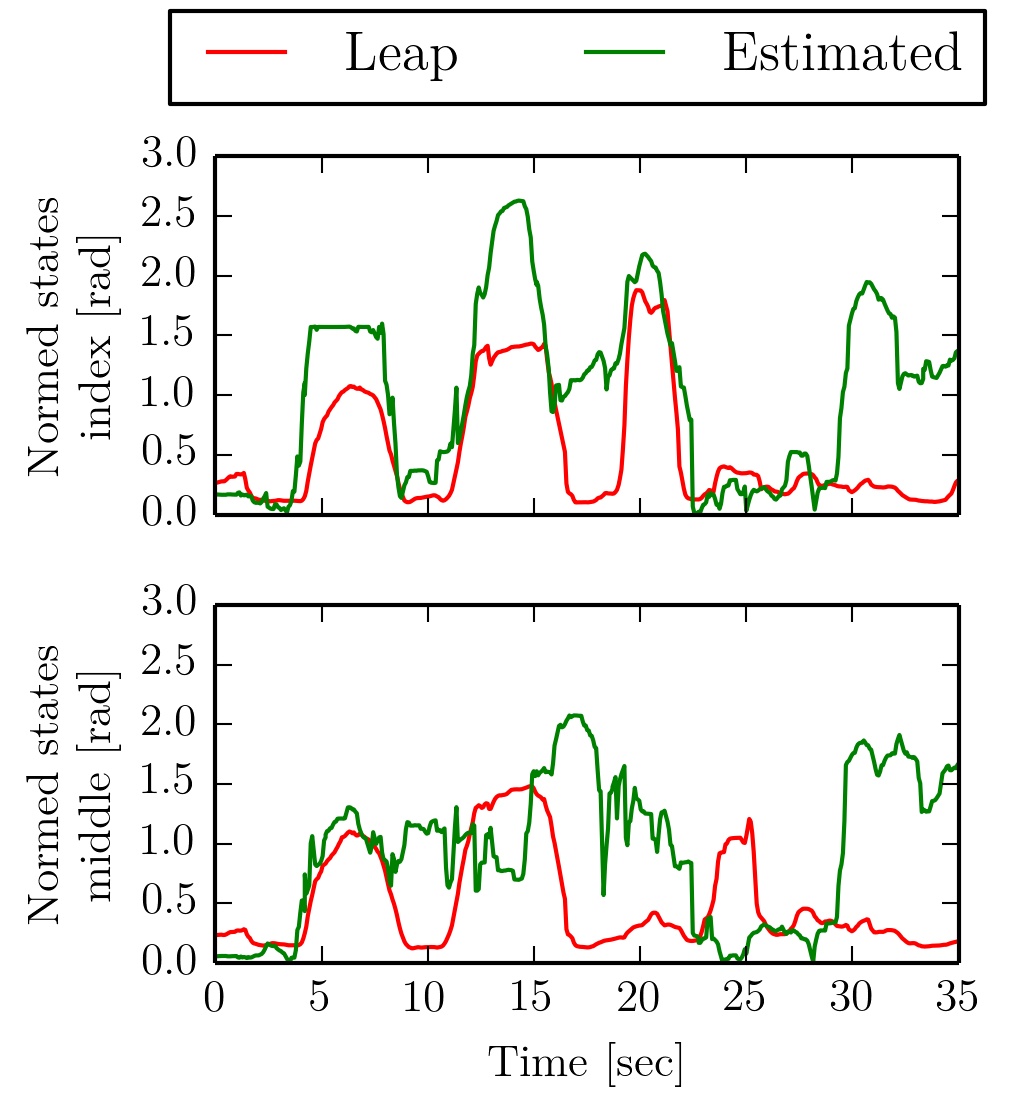
[picture p15: figure]

- Individual movements not detectable by magnetic system with this configuration due to:
  → False measured hand dimensions
- Estimation takes 0.837s per measurement set
  → No real time behaviour

Notes: Individual movements not detectable Experiments with perfect data showed, that it should be possible and that the system has to be overdetermined So better results expected by using more sensors

## Results Estimating one finger – best set

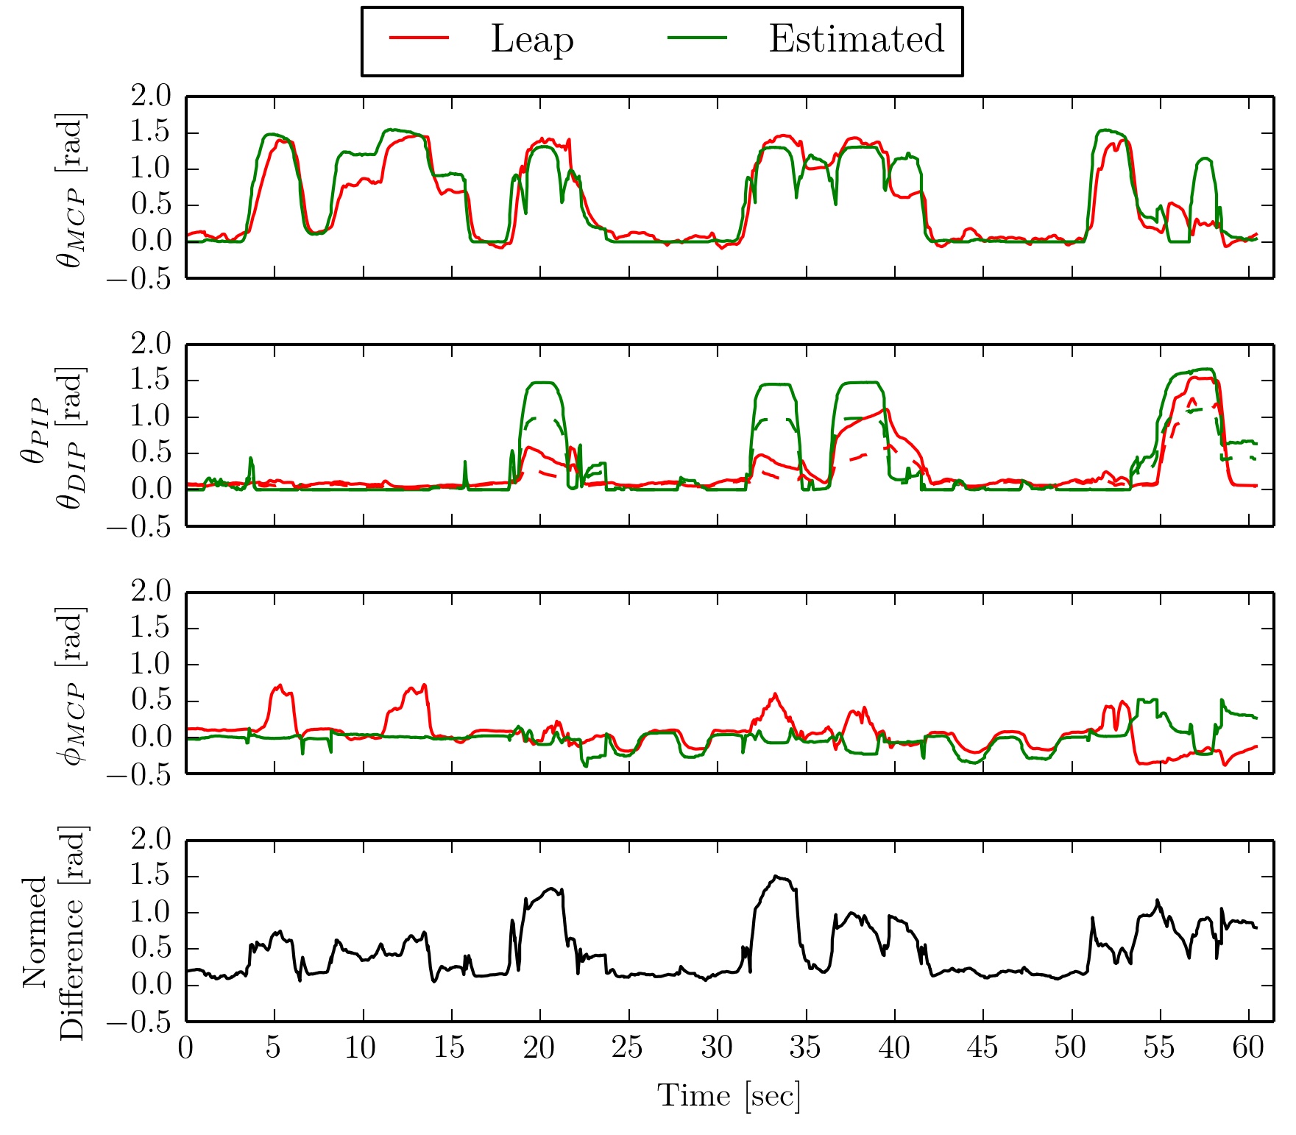
[picture p16: figure]

- Flexion-extension of MCP joint:
  →
- Adduction-abduction of MCP joint:
  →
- Bending to fist:
  →
  →

Notes: Plot set 4 (= best set from thesis) Explain all the capabilities and limits of the system Intention of movement is trackable Ad-Ab is trackable Limits due to: Accurance of hand dimensions → Fitting gesture is not perfect but it is a repeatable movement Influence of earth field Acquisition frequency (too low) Also limits of Leap

## Results Estimating one finger – bending to fist

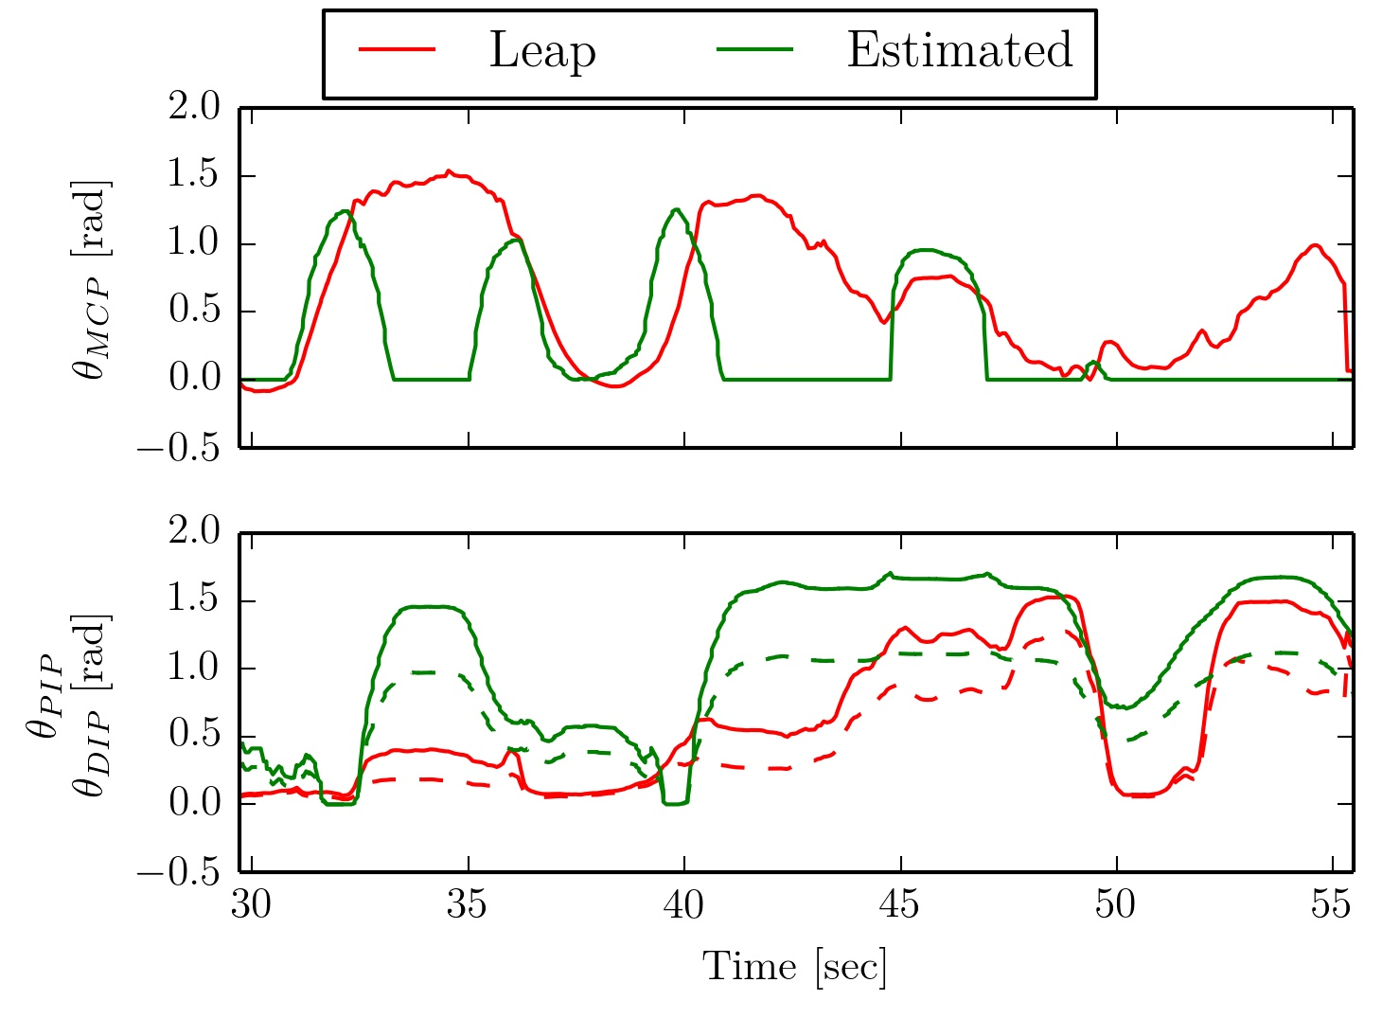
[picture p17: figure]

- “0-cases” for values occur because no solution is found by the minimizer
- This is introduced by:
  - Bad accuracy of hand dimensions
  - Fitting gesture scales linearly for stretched finger only

Notes: Plot set 4 (= best set from thesis) Explain all the capabilities and limits of the system Intention of movement is trackable Ad-Ab is trackable Limits due to: Accurance of hand dimensions → Fitting gesture is not perfect but it is a repeatable movement Influence of earth field Acquisition frequency (too low) Also limits of Leap

## Results Estimating one finger – Observations and Limitations

- Motion trackable for single flexion-extension of and lateral movement of MCP joint
- Results while bending to fist lead to bad values for
- Critical influence factors:
  - Accuracy of hand dimensions
    → Can not totally be compensated by fitting gesture
  - Constant position of hand
  - System frequency → Motion speed
- Objective function formulation:
  - Cylindrical model
  - System has to be overdetermined

Notes: Plot set 4 (= best set from thesis) Explain all the capabilities and limits of the system Intention of movement is trackable Ad-Ab is trackable Limits due to: Accurance of hand dimensions → Fitting gesture is not perfect but it is a repeatable movement Influence of earth field Acquisition frequency (too low) Also limits of Leap

## Demo

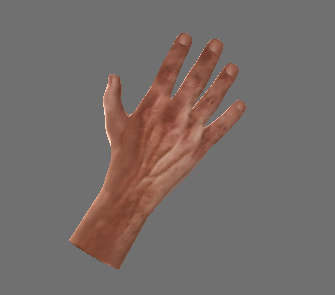
[picture p18: figure]
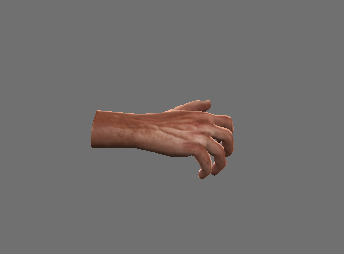
[picture p19: figure]

## Conclusion and Future Work

- Reconstruction of a single finger is possible, dependent on several influence factors:
  - Error prone determination of hand dimensions
    → Find a more exact measuring method
  - Influence of earth magnetic field
    → Find a method to cancel the surrounding field dynamically
  - Data acquisition rate of sensor system
    → Employ faster sensors and microcontroller
  → Lowest mean difference to Leap Motion over all 3 finger states for a whole set:
- Basic HCI could be one field of application for the presented system
  - Navigating cursor in two directions
  - Detecting gestures

## Bibliography

[1] Northern Digital: Optrak Certus Brochure

[2] Vicon Motion Systems LTD: Vicon Vantage Brochure

[3] Synertial Labs: Synertial, Glove Systems overview

[4] Zecca, Massimiliano et al.: On the development of the bioinstrumentation system WB-1R for the evaluation of human-robot interaction. In: Advanced intelligent mechatronics, 2007 IEEE/ASME

[5] Huang, Jiawei et al.: IM3D: magnetic motion tracking system for dexterous 3D interactions.

In: ACM SIGGRAPH 2014 Emerging Technologies ACM

[6] Ma, Yanru et al.: Magnetic hand motion tracking system for human-machine interaction.

In: Electronics letters 46 (2010)

[7] Bullock, Ian M. et al.: Assesing assumptions in kinematic hand models: a review.

In: Biomedical Robotics and Biomechatronics (BioRob)

[8] Lin, John et al.: Modeling the constraints of human hand motion.

In: Human Motion, 2000. Proceedings. Workshop on IEEE

[9] Derby, Norman et al.: Cylindrical magnets and ideal solenoids.

In: Amercan Journal of Physics 78 (2010)

## Kinematic Hand Model

## Cylindircal Magnetic Model

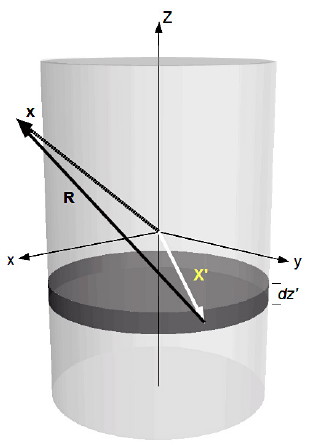
[picture p20: figure]
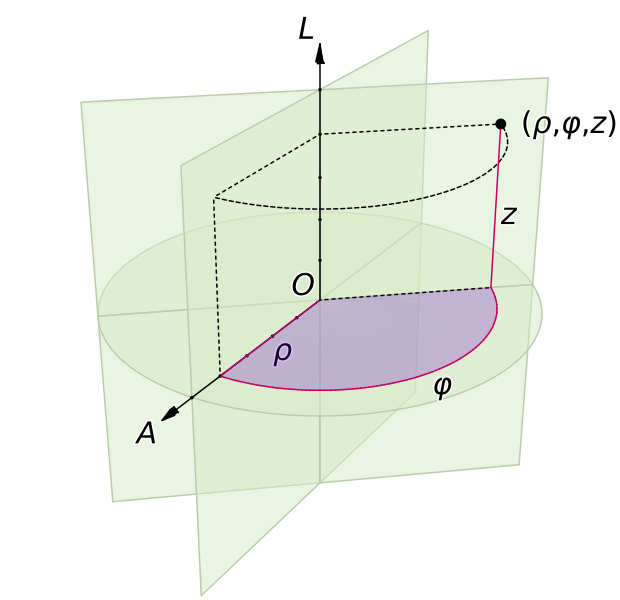
[picture p21: figure]

## Dynamic Cancellation of Earth Magnetic Field

1. Hold the hand with the sensors attached in a stable and calm position
2. The magnets for the fingertips are absent
3. Measure the orientation of the sensors and the corresponding surrounding earth magnetic field
4. After this calibration phase, track the orientation of the hand
5. Calculate the relative orientation
6. Convert into a rotation matrix and apply this to
7. Subtract the rotated earth magnetic field from your actual measurement:
