MuellerDaniel/SensGlove/SensGlove_noVideo/documents/presentation.pdf

# Magnetic Human Hand Motion

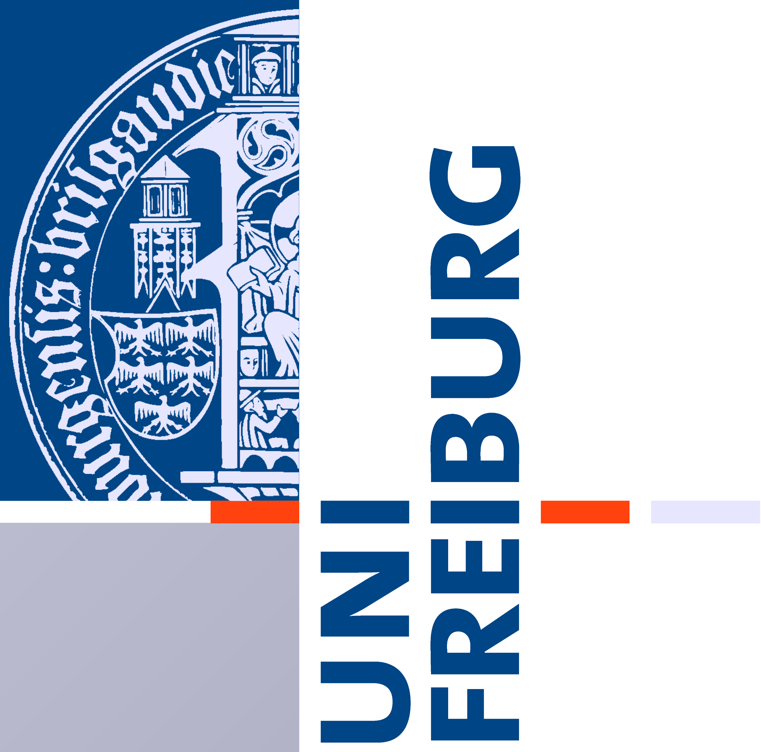
[picture p24: figure]

# Reconstruction

### Master thesis

22.03.2016

# Daniel Müller

### Embedded Systems Engineering

Magnetic Human Hand Motion Reconstruction

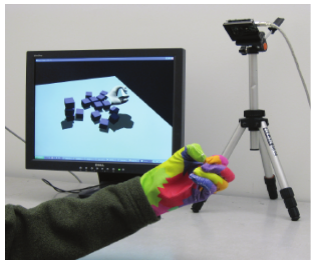
[picture p25: figure]
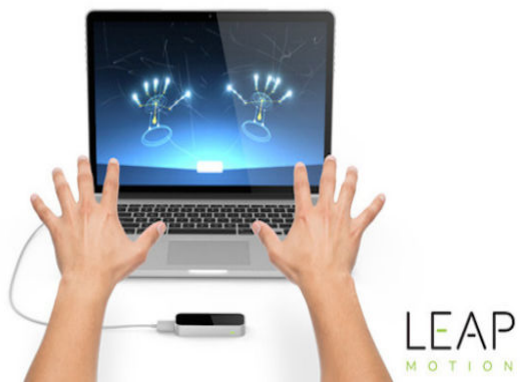
[picture p26: figure]
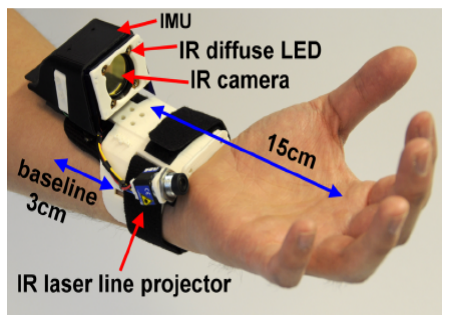
[picture p27: figure]

Daniel Müller | Embedded Systems Group | 2

# Systems for Hand Motion Reconstruction

### Vision based

- High accuracy possible, often used as ground truth
- Usually big and static systems
- Price and number of cameras rises with demanded accuracy [1, 2]

# Systems for Hand Motion Reconstruction

### Data gloves

- Mobile system
- IMUs or bend sensors used
- Accuracy is dependent on number of utilized sensor units [3]
- Placement of sensors is crucial
- Average error to vision based system around 7.1° [4]

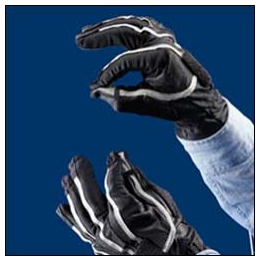
[picture p28: figure]
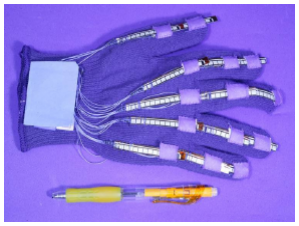
[picture p29: figure]
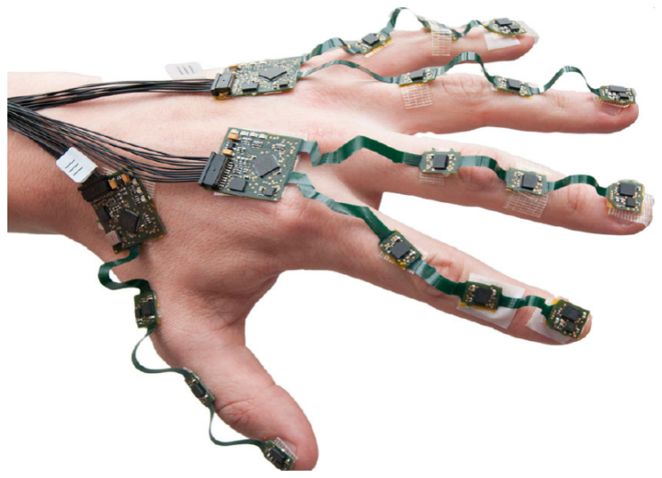
[picture p30: figure]

# Systems for Hand Motion Reconstruction

### Magnetic approach

- Passive magnetic system using magnets on fingertips [6] → Few publications on this

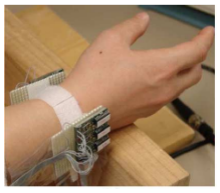
[picture p31: figure]

# Systems for Hand Motion Reconstruction

### Magnetic approach

- Passive magnetic system using magnets on fingertips [6] → Few publications on this
→ Promising approach to build a system which is:
- Wearable
- Cheap
- Easy to use

# Passive Magnetic Hand Motion Reconstruction

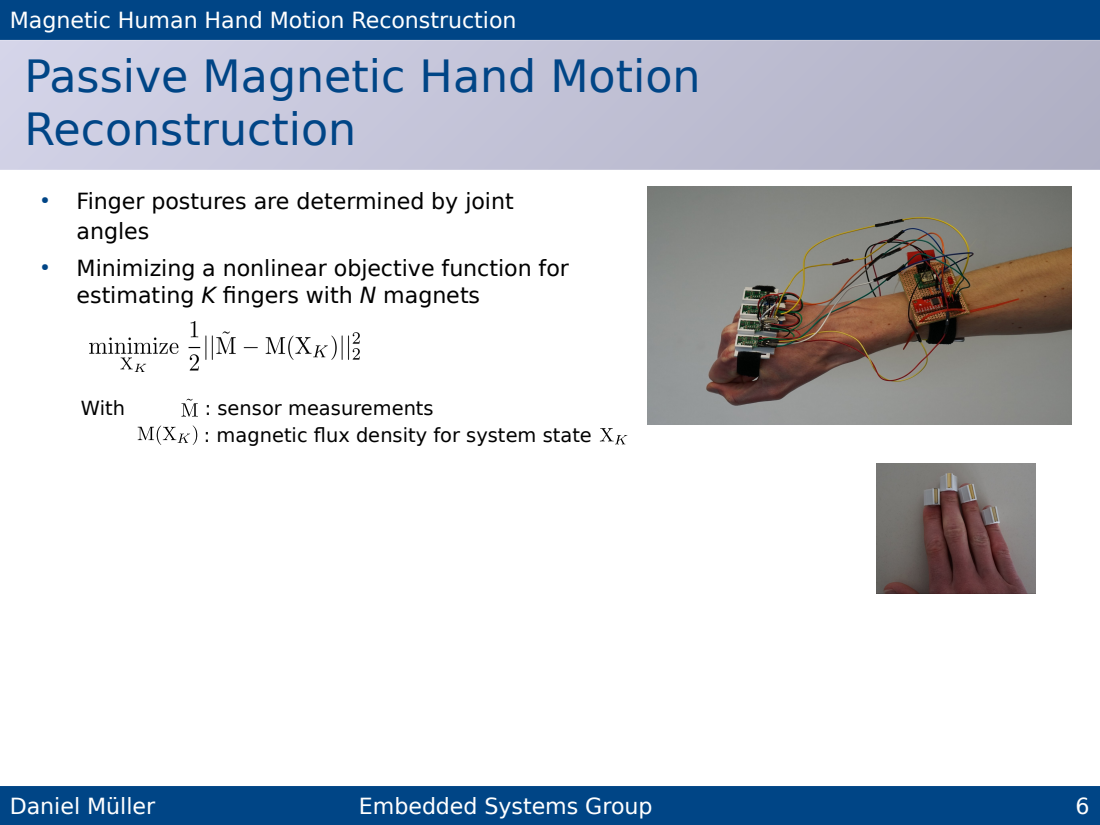
[picture p32: page 6]
With; : sensor measurements

● Finger postures are determined by joint
angles
● Minimizing a nonlinear objective function for
estimating K fingers with N magnets

: magnetic flux density for system state

# Modeling the Human Hand

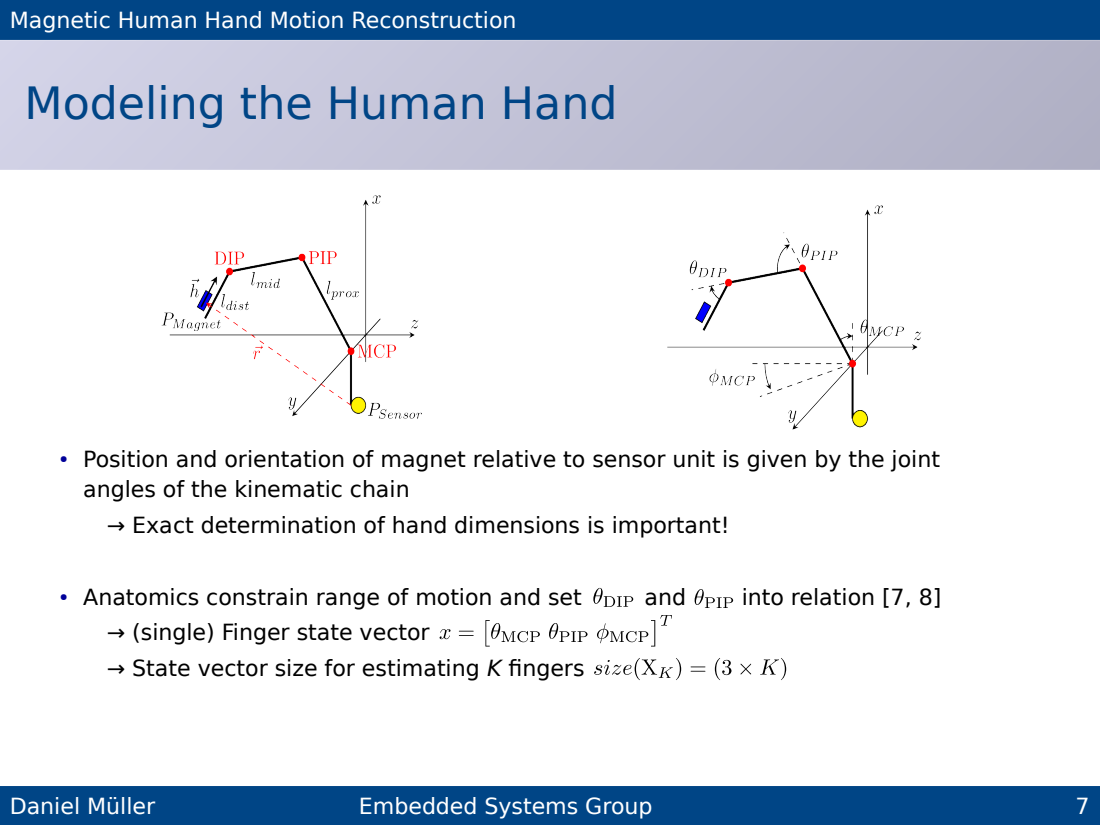
[picture p33: page 7]
Anatomics constrain range of motion and set; and; into relation [7, 8]

● Position and orientation of magnet relative to sensor unit is given by the joint
angles of the kinematic chain
→ Exact determination of hand dimensions is important!

→ (single) Finger state vector
→ State vector size for estimating K fingers

# Modeling the static magnets

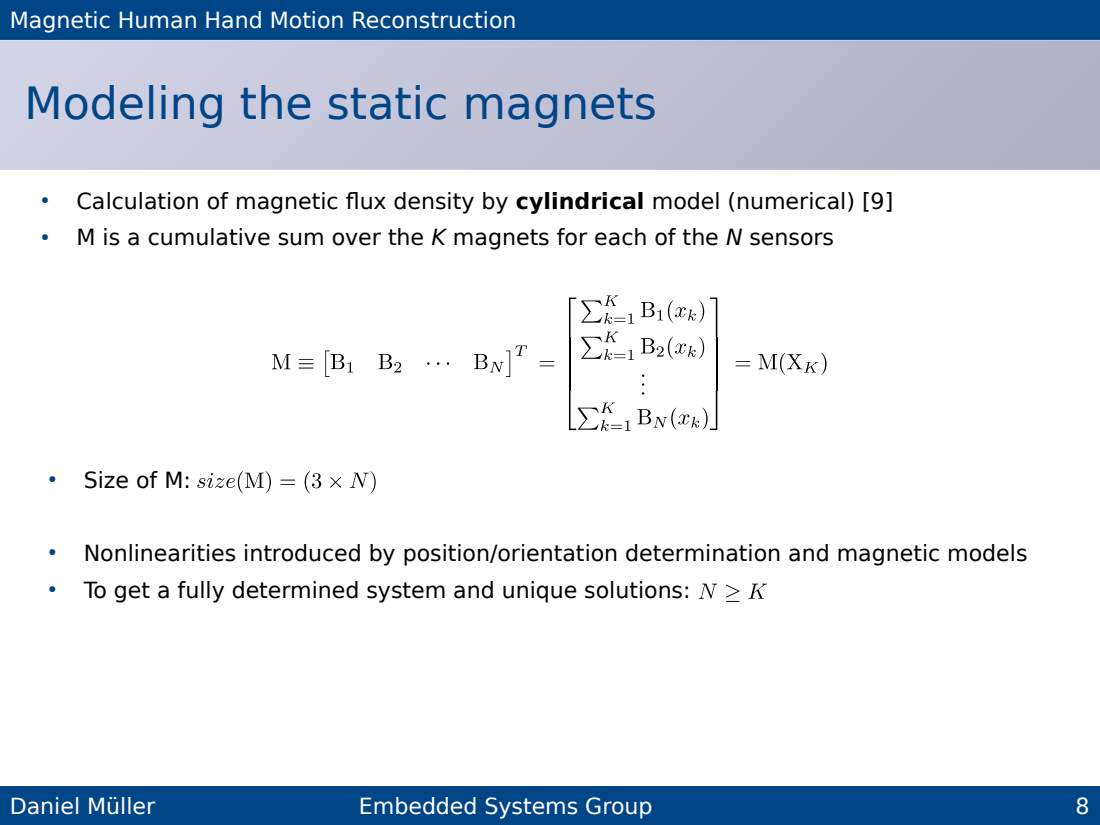
[picture p34: page 8]
● Size of M:

● Calculation of magnetic flux density by cylindrical model (numerical) [9]
● M is a cumulative sum over the K magnets for each of the N sensors

● Nonlinearities introduced by position/orientation determination and magnetic models
● To get a fully determined system and unique solutions:

# Evaluation of the System

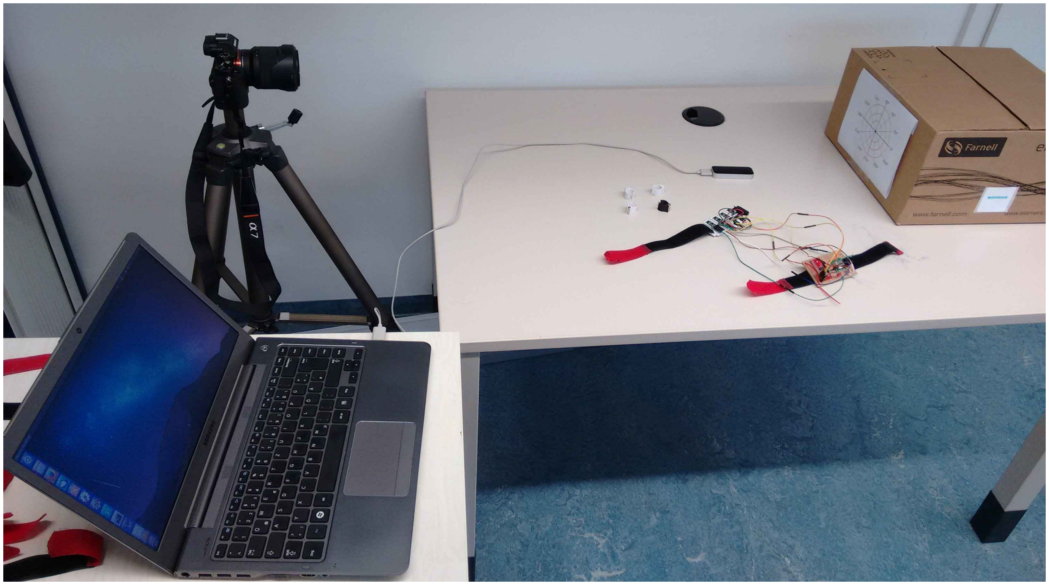
[picture p35: figure]

- Comparison to vision based system (Leap Motion)
- Post processing of recorded magnetic data for comparing different minimization formulations

# Results

### Preliminary – Scaling the measurements

- High difference between model prediction and measurements
→ Induced by hand measured anatomic parameters
- For estimating 1 finger with 1 sensor already 9 values have to be determined → Estimation and tuning by trial-and-error not applicable
→ Linear scaling of measurements to model prediction leads to reasonable results

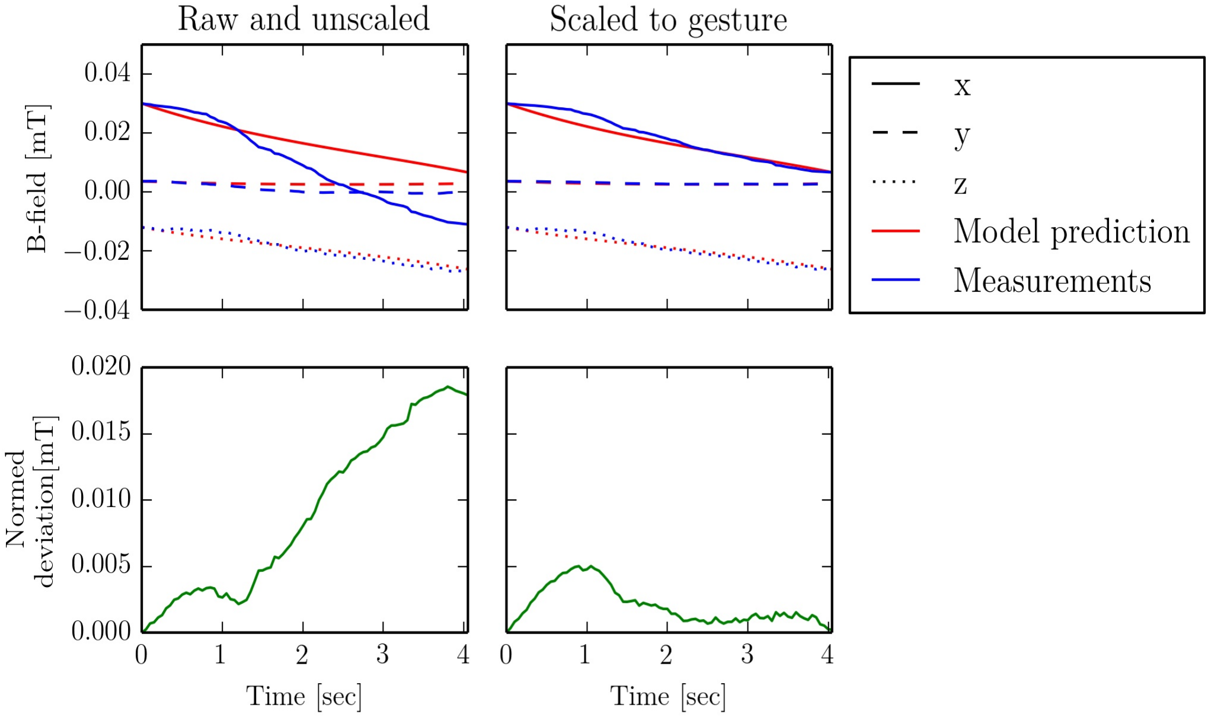
[picture p36: figure]

- Max deviation unscaled:
- Max deviation scaled:

# Results

### Preliminary – Characteristics of Leap Motion

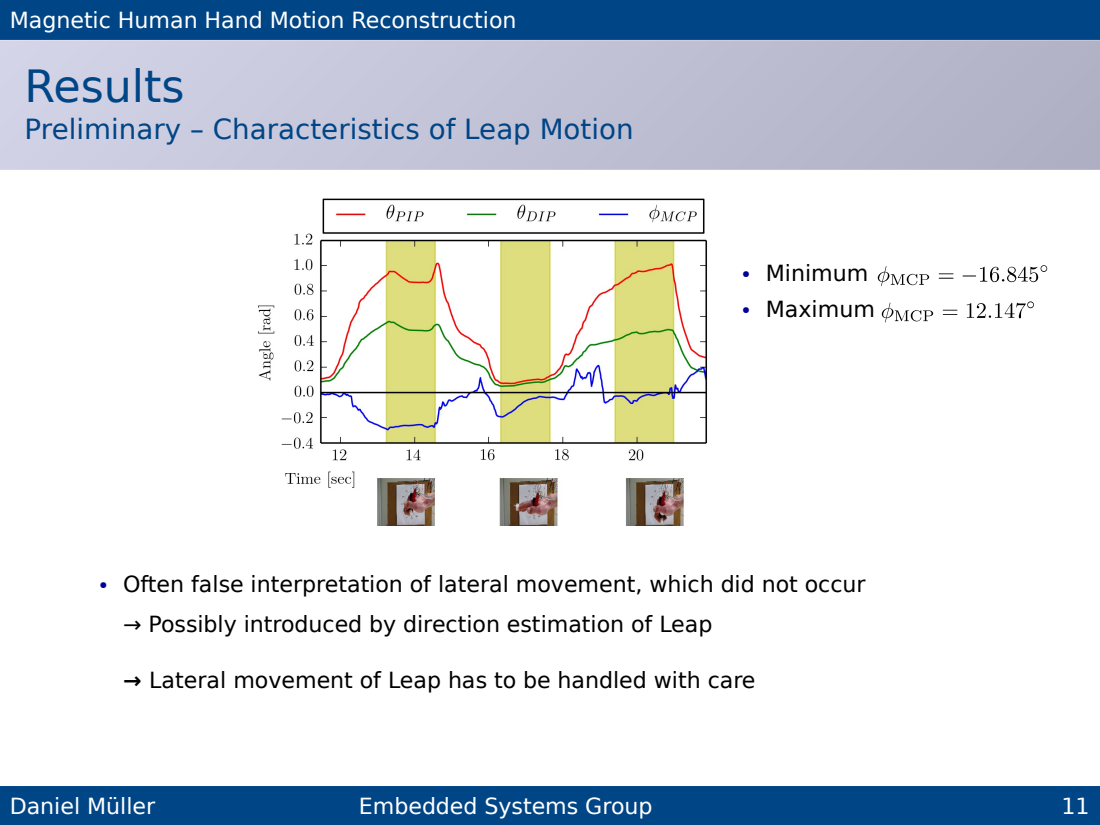
[picture p37: page 11]
● Minimum ● Maximum

● Often false interpretation of lateral movement, which did not occur
→ Possibly introduced by direction estimation of Leap

→ Lateral movement of Leap has to be handled with care

# Results

### Estimating four fingers

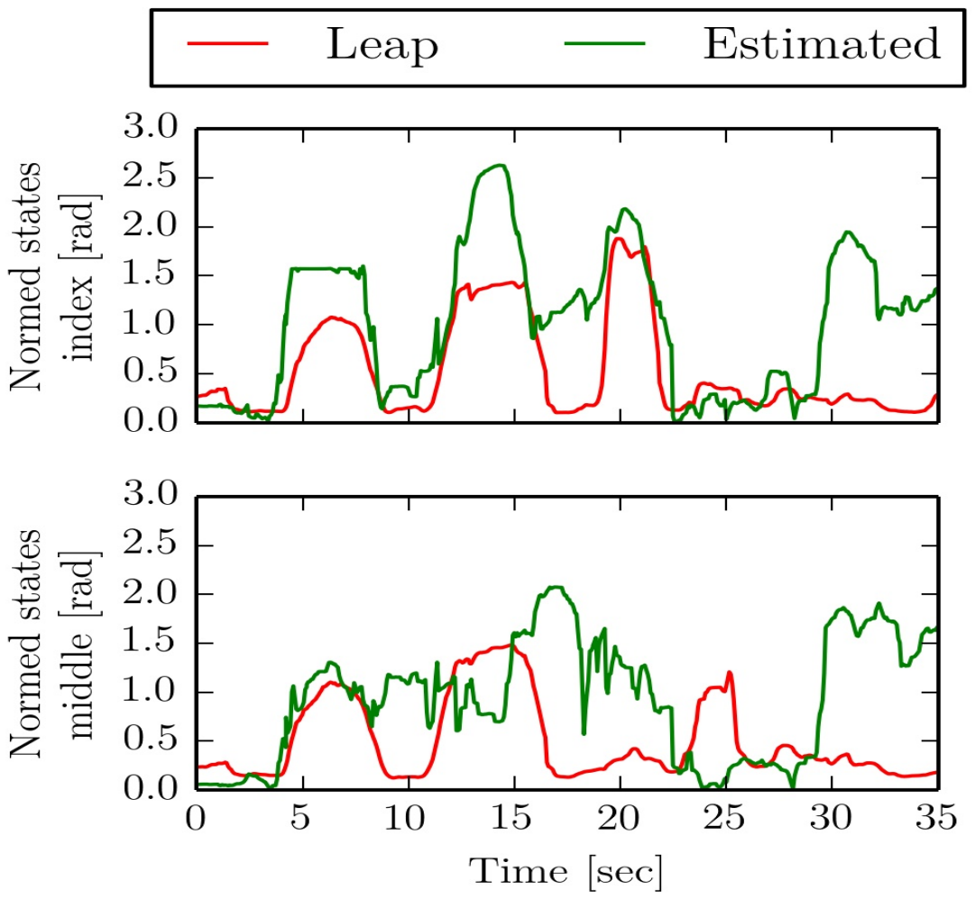
[picture p38: figure]

- Individual movements not detectable by magnetic system with this configuration due to:
→ False measured hand dimensions
- Estimation takes 0.837s per measurement set
→ No real time behaviour

# Results

### Estimating one finger – best set

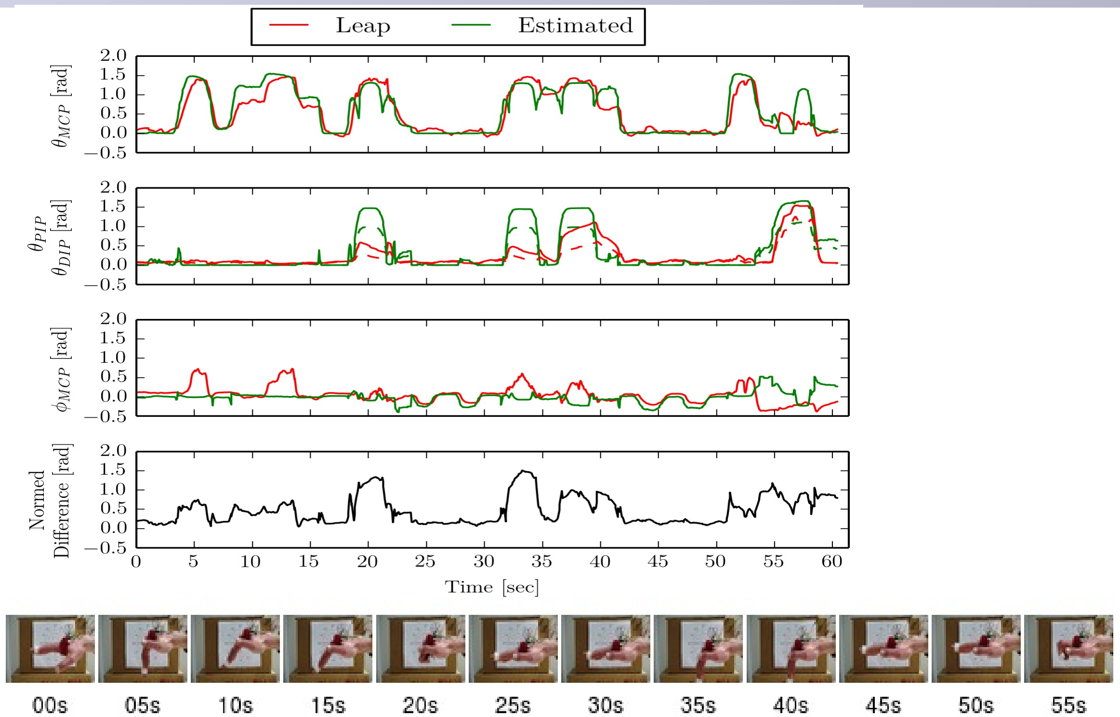
[picture p39: figure]

# Results

### Estimating one finger – best set

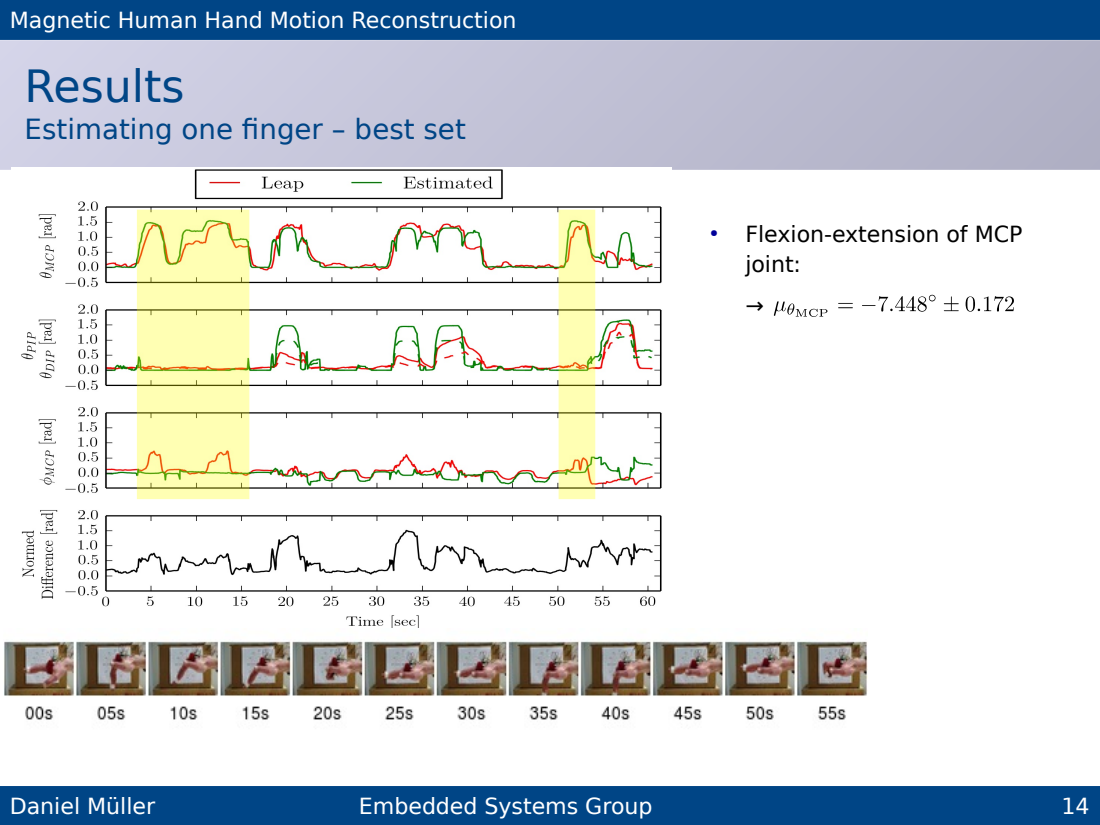
[picture p40: page 14]

● Flexion-extension of MCP
joint:

# Results

### Estimating one finger – best set

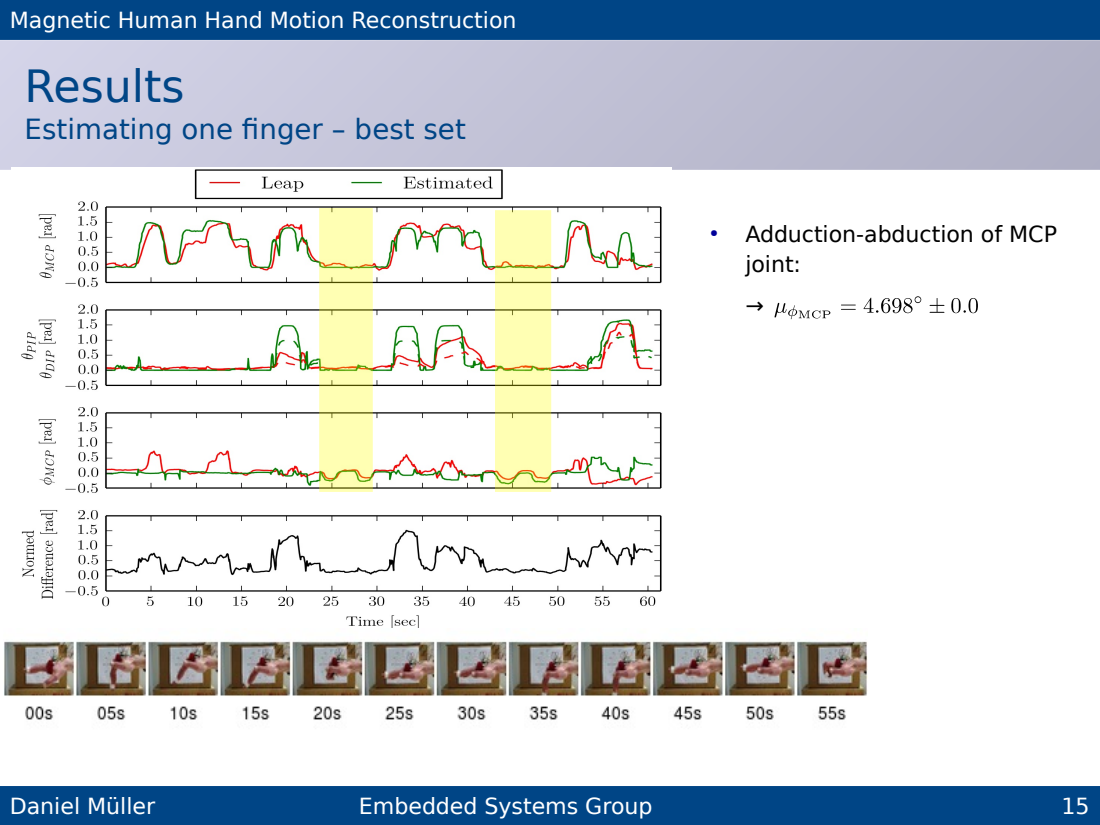
[picture p41: page 15]

● Adduction-abduction of MCP
joint:

# Results

### Estimating one finger – best set

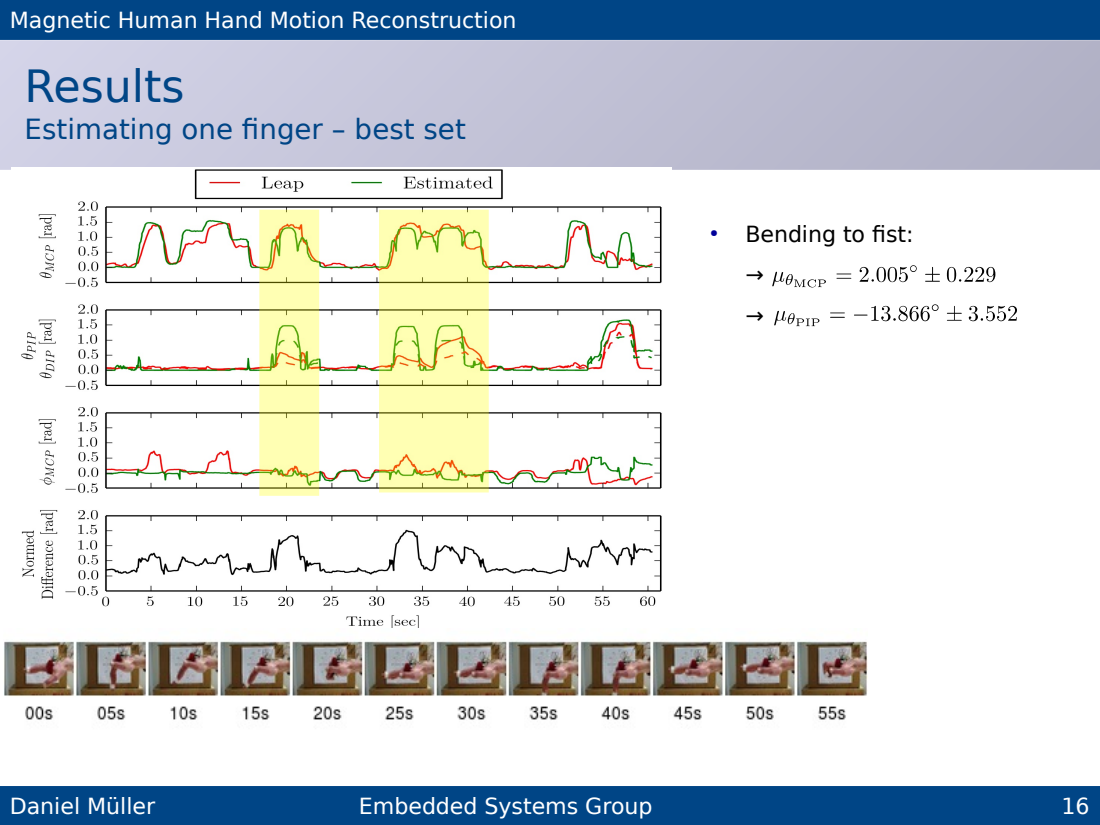
[picture p42: page 16]
● Bending to fist:

# Results

### Estimating one finger – bending to fist

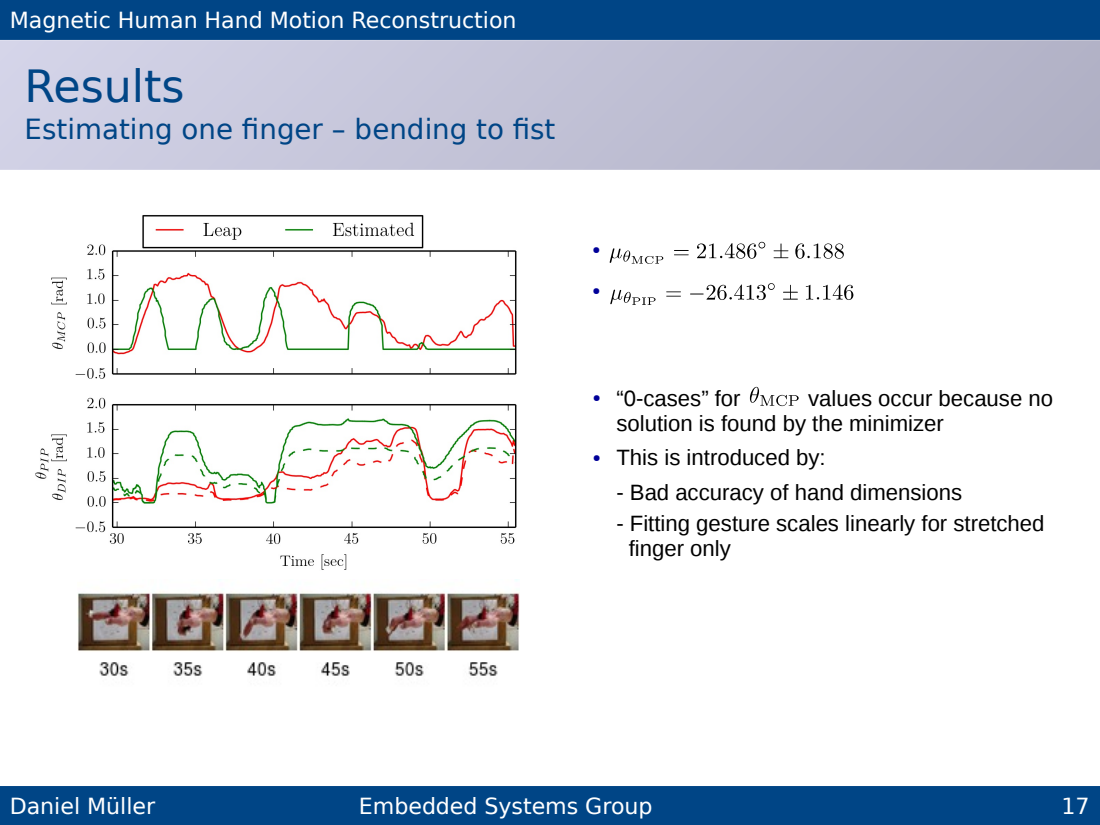
[picture p43: page 17]
“0-cases” for; values occur because no

solution is found by the minimizer
● This is introduced by:
- Bad accuracy of hand dimensions
- Fitting gesture scales linearly for stretched
finger only

# Results

### Estimating one finger – Observations and Limitations

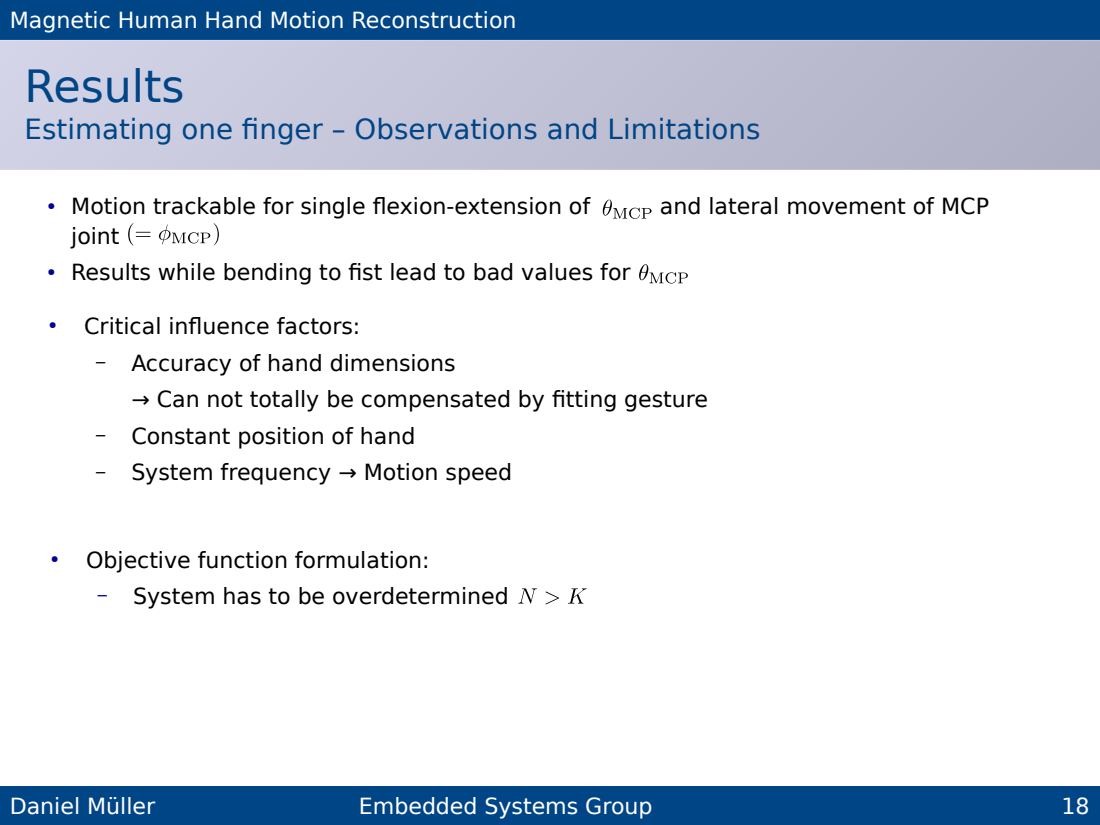
[picture p44: page 18]
System has to be overdetermined; Accuracy of hand dimensions; Constant position of hand; System frequency → Motion speed; Motion trackable for single flexion-extension of; and lateral movement of MCP

joint
● Results while bending to fist lead to bad values for

● Critical influence factors:
→ Can not totally be compensated by fitting gesture

● Objective function formulation:

# Demo


# Conclusion and Future Work

- Reconstruction of a single finger is possible, dependent on several influence factors:
- Error prone determination of hand dimensions
→ Find a more exact measuring method
- Influence of earth magnetic field
→ Find a method to cancel the surrounding field dynamically
- Data acquisition rate of sensor system
→ Employ faster sensors and microcontroller
→ Lowest mean difference to Leap Motion over all 4 joint angles for a whole set:
- Basic HCI could be one field of application for the presented system
- Navigating cursor in two directions
- Detecting gestures

# Bibliography

[1] Northern Digital: Optrak Certus Brochure
[2] Vicon Motion Systems LTD: Vicon Vantage Brochure
[3] Synertial Labs: Synertial, Glove Systems overview
[4] Zecca, Massimiliano et al.: On the development of the bioinstrumentation system WB-1R for the evaluation of human-robot interaction. In: Advanced intelligent mechatronics, 2007 IEEE/ASME
[5] Huang, Jiawei et al.: IM3D: magnetic motion tracking system for dexterous 3D interactions.
In: ACM SIGGRAPH 2014 Emerging Technologies ACM
[6] Ma, Yanru et al.: Magnetic hand motion tracking system for human-machine interaction.
In: Electronics letters 46 (2010)
[7] Bullock, Ian M. et al.: Assesing assumptions in kinematic hand models: a review.
In: Biomedical Robotics and Biomechatronics (BioRob)
[8] Lin, John et al.: Modeling the constraints of human hand motion.
In: Human Motion, 2000. Proceedings. Workshop on IEEE
[9] Derby, Norman et al.: Cylindrical magnets and ideal solenoids. In: Amercan Journal of Physics 78 (2010)

# Kinematic Hand Model

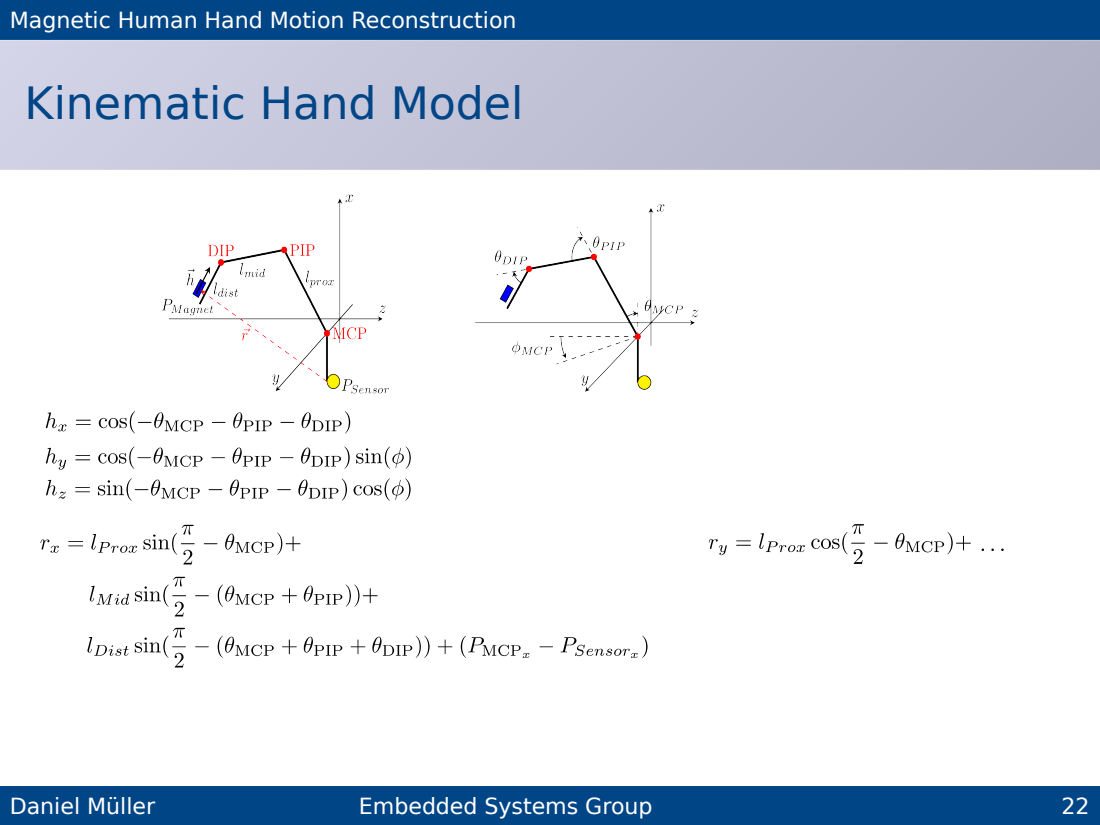
[picture p45: page 22]

# Cylindircal Magnetic Model

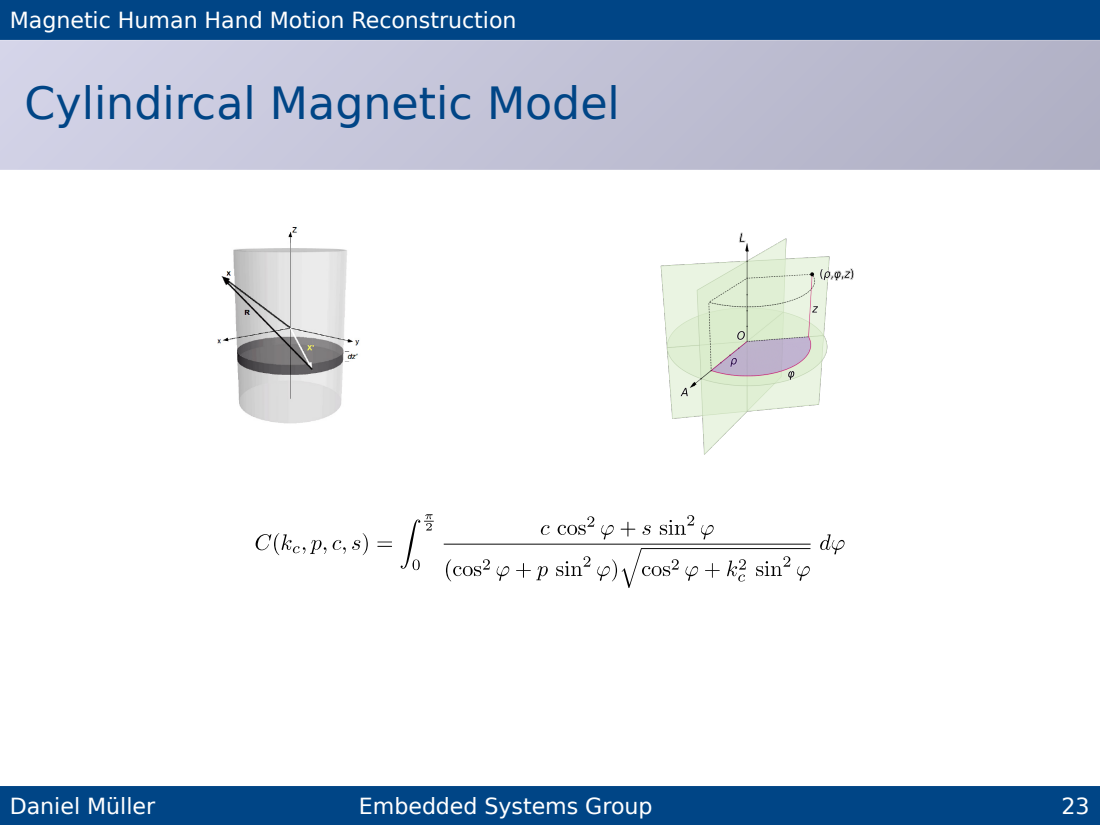
[picture p46: page 23]

# Dynamic Cancellation of Earth Magnetic Field

1.Hold the hand with the sensors attached in a stable and calm position
2.The magnets for the fingertips are absent
3.Measure the orientation of the sensors and the corresponding surrounding earth magnetic field
4.After this calibration phase, track the orientation of the hand
5.Calculate the relative orientation
6.Convert | into a rotation matrix | and apply this to
7.Subtract the rotated earth magnetic field from your actual measurement:
