MuellerDaniel/SensGlove/thesis/sensGloveThesis.tex

%% LyX 2.0.2 created this file.  For more info, see http://www.lyx.org/.
%% Do not edit unless you really know what you are doing.
\documentclass[12pt,a4paper,english,intoc,bibliography=totoc,index=totoc,BCOR10mm,captions=tableheading,titlepage,hidelinks,fleqn]{scrbook}
%\documentclass[12pt,a4paper,english,titlepage,fleqn]{scrbook}
\usepackage{lmodern}
\renewcommand{\sfdefault}{lmss}
\renewcommand{\ttdefault}{lmtt}

\usepackage[T1]{fontenc}
\usepackage[latin9]{inputenc}
\usepackage{fancyhdr}
\usepackage{listings}
\pagestyle{fancy}
\setcounter{secnumdepth}{3}
\setlength{\parskip}{\medskipamount}
\setlength{\parindent}{0pt}
\usepackage[english]{babel}
\usepackage{amsmath}
\usepackage{amssymb}
\usepackage{graphicx}
\usepackage{subfig}
\usepackage{nomencl}
\usepackage{rotating} 
\usepackage[nohyperlinks, printonlyused]{acronym}
%\usepackage[numbers]{alphanat}
%\usepackage{hyperref}

%\usepackage[square,sort,comma]{natbib}
%\usepackage{biblatex}
%\hypersetup{hidelinks=true,
%			pdfborder={0,0,0},
%			colorlinks=false}

%\usepackage{lipsum}
\usepackage{textcomp}
\usepackage{gensymb}
\usepackage[binary-units]{siunitx}
\usepackage{acronym}
\usepackage{subfiles}
\usepackage{tikzsymbols,xcolor}
\usetikzlibrary{arrows,shapes,positioning,calc}
\usepackage{booktabs}
\usepackage{multirow}
\usepackage{caption}
\captionsetup[table]{skip=10pt}
\usepackage{placeins}
\usepackage[hidelinks,colorlinks=false]{hyperref}

% the following is useful when we have the old nomencl.sty package
\providecommand{\printnomenclature}{\printglossary}
\providecommand{\makenomenclature}{\makeglossary}
\makenomenclature

%\usepackage[unicode=true,
% bookmarks=true,bookmarksnumbered=true,bookmarksopen=true,bookmarksopenlevel=1,
% breaklinks=false,pdfborder={0 0 0},backref=false,colorlinks=false]
% {hyperref}
%\hypersetup{pdftitle={Magnetic Human Hand Motion Reconstrution},
% pdfauthor={Daniel Müller},
% pdfsubject={Arbeit zur Erlangung des Masters der Technischen Fakultät der Albert-Ludwigs-Universität Freiburg im Breisgau},
% pdfkeywords={Masterarbeit},
% pdfpagelayout=OneColumn, pdfnewwindow=true, pdfstartview=XYZ, plainpages=false}

\makeatletter

%%%%%%%%%%%%%%%%%%%%%%%%%%%%%% LyX specific LaTeX commands.
\pdfpageheight\paperheight
\pdfpagewidth\paperwidth

\@ifundefined{date}{}{\date{}}
%%%%%%%%%%%%%%%%%%%%%%%%%%%%%% User specified LaTeX commands.
% Linkfläche für Querverweise vergrößern und automatisch benennen
\AtBeginDocument{\renewcommand{\ref}[1]{\mbox{\autoref{#1}}}}
\newlength{\abc}
\settowidth{\abc}{\space}
\AtBeginDocument{%
%\addto\extrasngerman{
 %\renewcommand{\equationautorefname}{\hspace{-\abc}}
 %\renewcommand{\sectionautorefname}{Kap.\negthinspace}
 %\renewcommand{\subsectionautorefname}{Kap.\negthinspace}
 %\renewcommand{\subsubsectionautorefname}{Kap.\negthinspace}
 %\renewcommand{\figureautorefname}{Abb.\negthinspace}
 %\renewcommand{\tableautorefname}{Tab.\negthinspace}
%}
}

% für den Fall, dass jemand die Bezeichnung "Gleichung" haben will
%\renewcommand{\eqref}[1]{equation~(\negthinspace\autoref{#1})}

% Setzt den Link für Sprünge zu Gleitabbildungen
% auf den Anfang des Gelitobjekts und nicht aufs Ende
%\usepackage[figure]{hypcap}

% Die Seiten des Inhaltsverzeichnisses werden römisch numeriert,
% ein PDF-Lesezeichen für das Inhaltsverzeichnis wird hinzugefügt
\let\myTOC\tableofcontents
\renewcommand\tableofcontents{%
  \frontmatter
  \pdfbookmark[1]{\contentsname}{}
  \myTOC
  %\mainmatter
 }

% make caption labels bold
\setkomafont{captionlabel}{\bfseries}
\setcapindent{1em}

%\usepackage{xcolor}
\newcommand{\note}[1]{\textcolor{red}{#1}}

%sections with pagebreak
\newcommand{\mysection}[1]{\newpage\section{#1}}

% erlaubt LaTeX-Berechnungen
\usepackage{calc}

% fancy page header/footer settings
\renewcommand{\chaptermark}[1]{\markboth{#1}{#1}}
\renewcommand{\sectionmark}[1]{\markright{\thesection\ #1}}

% Vergrößert den Teil der Seite, in dem Gleitobjekte
% unten angeordnet werden dürfen
\renewcommand{\bottomfraction}{0.5}

% Vermeidet, dass Gleitobjekte vor ihrem Abschnitt gedruckt werden
\let\mySection\section\renewcommand{\section}{\suppressfloats[t]\mySection}

% deutscher Name für die Nomenklatur 
\renewcommand{\nomname}{Nomenklatur}

\newcommand\todo[1]{\textcolor{red}{#1}}
\newcommand*{\rom}[1]{\expandafter\@slowromancap\romannumeral #1@}

\makeatother

\setcounter{tocdepth}{4}
\setcounter{secnumdepth}{4}

\begin{document}
%\hypersetup{pageanchor=false}

%\DeclareSIUnit\gauss{G}

\subject{Masterarbeit}

\title{Magnetic Human Hand Motion Reconstruction}

\author{Daniel Müller}

\date{07.03.2016}

\publishers{%\includegraphics{images/Uni_Logo-Grundversion_E1_A4_CMYK.pdf}\vspace{\baselineskip}\\
Albert-Ludwigs-Universität Freiburg im Breisgau\\
Technische Fakultät\\
Embedded Systems Engineering\vspace{-3cm}
}

\uppertitleback{Eingereichte Masterarbeit gemäß den Bestimmungen der Prüfungsordnung
der Albert-Ludwigs-Universität Freiburg für den Studiengang Master
of Science (M.\,Sc.) Embedded Systems Engineering vom 3.\,6.\,2014.}

\lowertitleback{\textbf{Bearbeitungszeitraum}\smallskip{}
\\
07.\,09.\,2015 -- 07.\,03.\,2016 \bigskip{}
\\
\textbf{Gutachter}\smallskip{}
\\
Prof.~Dr.~Kristof Van Laerhoven \smallskip{}
\\
Prof.~Dr.~Christoph Scholl\bigskip{}
\\
\textbf{Betreuer}\smallskip{}
\\
Prof.~Dr.~Kristof Van Laerhoven \smallskip{}
\\
Dipl.\,Inf.~Philipp M. Scholl}

%\dedication{Widmung, Zitat, kluger Spruch oder Ähnliches (ist natürlich optional)}

\maketitle
\cleardoublepage{}

\pagestyle{empty}

\section*{Erklärung}

Hiermit erkläre ich, dass ich diese Abschlussarbeit selbständig verfasst
habe, keine anderen als die angegebenen Quellen/Hilfsmittel verwendet
habe und alle Stellen, die wörtlich oder sinngemäß aus veröffentlichten
Schriften entnommen wurden, als solche kenntlich gemacht habe. Darüber
hinaus erkläre ich, dass diese Abschlussarbeit nicht, auch nicht auszugsweise,
bereits für eine andere Prüfung angefertigt wurde.
\\[30ex]
\noindent\begin{tabular}{ll}
\makebox[2.5in]{\hrulefill} & \makebox[2.5in]{\hrulefill}\\
Ort, Datum & Daniel Müller
\end{tabular}

\cleardoublepage{}

\lhead{\rightmark}

\rhead[\leftmark]{}

\lfoot[\thepage]{}

\cfoot{}

\rfoot[]{\thepage}

\pagestyle{plain}

\include{texfiles/summary}

\include{texfiles/summary_ger}

\cleardoublepage{}

\tableofcontents{}

\cleardoublepage{}

\listoffigures
\addcontentsline{toc}{chapter}{List of Figures} 

\newpage

\section*{Acronyms}
\begin{acronym}
\acro{BFGS}{Broyden-Fletcher-Goldfarb-Shanno}
\acro{BLE}{Bluetooth Low Energy}
\acro{CEL}{complete elliptical integral}
\acro{CGS}{Centimetre-Gram-Second}
\acro{CMC}{Carpometacarpal}
\acro{CT}{Computed Tomography}
\acro{DIP}{Distal interphalangeal}
\acro{DOF}{Degree of Freedom}
\acro{EKF}{Extended Kalman Filter}		% needed???
\acro{EMG}{Electromyography}
\acro{FEM}{Finite Element Method}
\acro{FFT}{Fast Fourier Transform}
\acro{GATT}{Generic Attribute Profile}
\acro{HCI}{Human Computer Interface}
\acro{IMU}{Inertial Measurement Unit}
\acro{IR}{Infra Red}
\acro{LSB}{Least Significant Bit}
\acro{MCP}{Metacarpophalangeal} 
\acro{PCB}{Printed Circuit Board}
\acro{PIP}{proximal Interphalangeal}
\acro{ROI}{Region of Interest}
\acro{ROM}{Range of Movement}
\acro{SDK}{Software Development Kit}
\acro{SLSQP}{Sequential Least SQuares Programming}
\acro{TM}{Trapeziometacarpal}
\end{acronym}

\cleardoublepage{}

%\listoftables
%\addcontentsline{toc}{chapter}{List of Tables} 

\cleardoublepage{}

\mainmatter

\cleardoublepage{}

\pagestyle{fancy}

\lhead[\chaptername~\thechapter]{\rightmark}

\include{texfiles/introduction}

\include{texfiles/relatedWork}

\include{texfiles/foundations}

\include{texfiles/systemDesign}

\include{texfiles/results}

% REMIND: only for compilation speed up!
% when you are finished, comment this line out. The file is included by results.tex!
%\include{texfiles/estimationRes}

\include{texfiles/conclusion}

%the other chapters go here...

\cleardoublepage{}

%\lhead[]{Acknowledgment}
%\rhead[Acknowledgment]{}
%\include{texfiles/acknowledgment}

%\appendix
%\include{texfiles/appendix}

\cleardoublepage{}

\lhead[]{\rightmark}

\rhead[\leftmark]{}

\bibliographystyle{alphadin}
%\bibliography{biblio/Plasma}
\bibliography{biblio/bibFiles}

\cleardoublepage{}

\lhead[]{Nomenklatur}

\rhead[Nomenklatur]{}

\printnomenclature[2.5cm]{}
\end{document}
