MuellerDaniel/SensGlove/thesis/texfiles/tableSets.csv

 | dip\_11 | cyl\_11 | dip\_12 | cyl\_12 | dip\_14 | cyl\_14 |  | Set_mean
Set 1 | $0.940 \pm 0.05$ | $0.873 \pm 0.077$ | $0.641 \pm 0.014$ | $0.581 \pm 0.02$ | $0.620 \pm 0.023$ | $0.623 \pm 0.029$ | 0.433
Set 2 | $0.706 \pm 0.023$ | $0.766 \pm 0.045$ | $0.644 \pm 0.008$ | $0.587 \pm 0.012$ | $0.629 \pm 0.011$ | $0.626 \pm 0.013$ | 0.365
Set 3 | $0.741 \pm 0.021$ | $0.809 \pm 0.053$ | $0.646 \pm 0.01$ | $0.654 \pm 0.011$ | $0.668 \pm 0.01$ | $0.669 \pm 0.011$ | 0.380
Set 4 | $0.786 \pm 0.079$ | $0.726 \pm 0.112$ | $0.752 \pm 0.083$ | $0.467 \pm 0.017$ | $0.643 \pm 0.552$ | $0.552 \pm 0.027$ | 0.423
Set 5 | $0.855 \pm 0.042$ | $0.806 \pm 0.046$ | $0.889 \pm 0.047$ | $0.807 \pm 0.049$ | $0.698 \pm 0.023$ | $0.668 \pm 0.027$ | 0.448
Set 6 | $0.622 \pm 0.019$ | $0.641 \pm 0.046$ | $0.547 \pm 0.01$ | $0.495 \pm 0.011$ | $0.547 \pm 0.009$ | $0.495 \pm 0.011$ | 0.314
Set 7 | $0.806 \pm 0.038$ | $0.668 \pm 0.038$ | $0.716 \pm 0.036$ | $0.675 \pm 0.044$ | $0.601 \pm 0.018$ | $0.567 \pm 0.026$ | 0.384
Set 8 | $0.848 \pm 0.031$ | $0.805 \pm 0.049$ | $0.754 \pm 0.045$ | $0.727 \pm 0.048$ | $0.711 \pm 0.051$ | $0.67 \pm 0.052$ | 0.422
Set 9 | $0.741 \pm 0.025$ | $0.675 \pm 0.02$ | $0.702 \pm 0.032$ | $0.617 \pm 0.022$ | $0.606 \pm 0.024$ | $0.628 \pm 0.02$ | 0.366
Set 10 | $0.885 \pm 0.071$ | $0.865 \pm 0.073$ | $0.865 \pm 0.065$ | $0.684 \pm 0.043$ | $0.619 \pm 0.01$ | $0.581 \pm 0.01$ | 0.471
Set 11 | $0.817 \pm 0.039$ | $0.736 \pm 0.051$ | $0.756 \pm 0.025$ | $0.71 \pm 0.033$ | $0.611 \pm 0.004$ | $0.603 \pm 0.004$ | 0.404
Set 12 | $0.866 \pm 0.034$ | $0.702 \pm 0.016$ | $0.76 \pm 0.024$ | $0.739 \pm 0.027$ | $0.676 \pm 0.022$ | $0.691 \pm 0.037$ | 0.400
Set 13 | $0.822 \pm 0.013$ | $0.756 \pm 0.018$ | $0.803 \pm 0.019$ | $0.723 \pm 0.018$ | $0.713 \pm 0.013$ | $0.68 \pm 0.018$ | 0.405
Set 14 | $0.864 \pm 0.026$ | $0.797 \pm 0.031$ | $0.774 \pm 0.028$ | $0.764 \pm 0.032$ | $0.552 \pm 0.008$ | $0.525 \pm 0.01$ | 0.420
Set 15 | $0.840 \pm 0.021$ | $0.844 \pm 0.025$ | $0.728 \pm 0.011$ | $0.756 \pm 0.013$ | $0.691 \pm 0.012$ | $0.672 \pm 0.012$ | 0.412
