MuellerDaniel/SensGlove/python/150630_motion.png

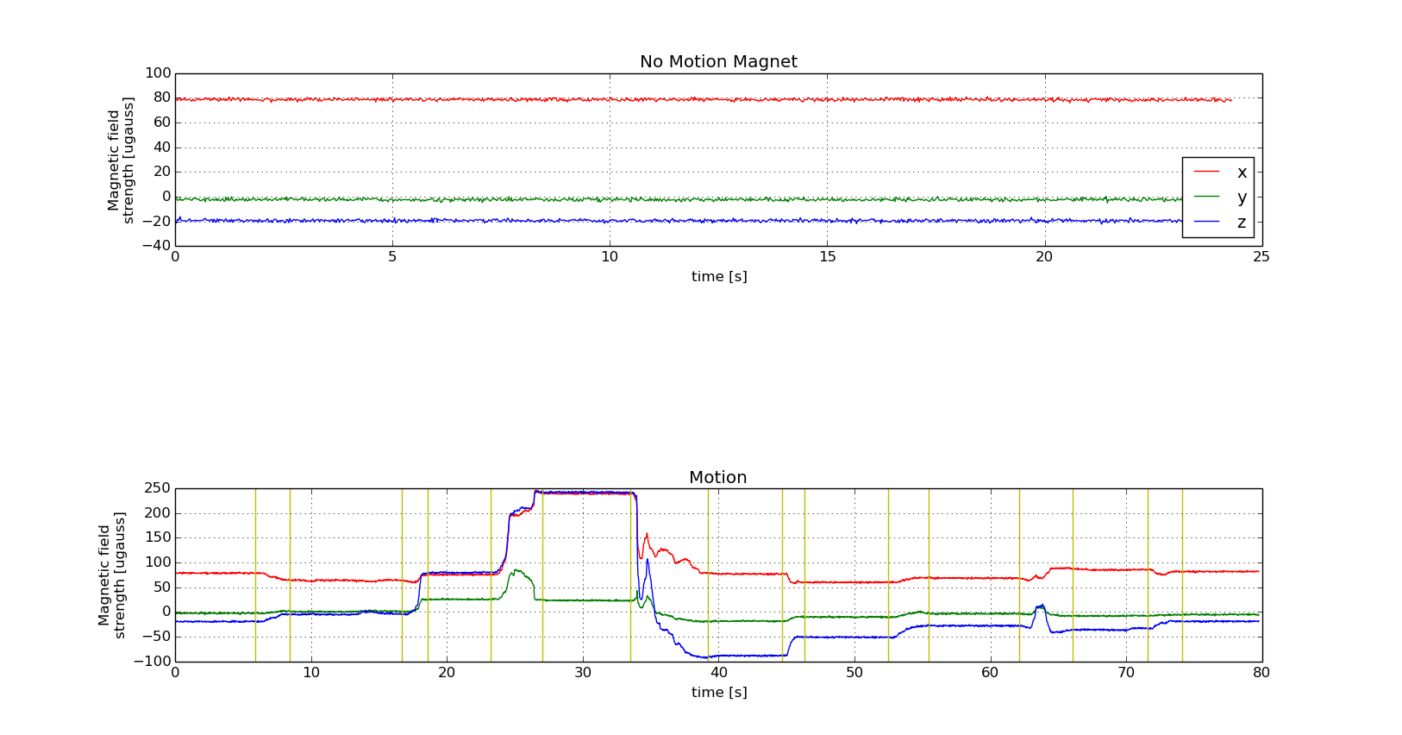
python/150630_motion.png
