MuellerDaniel/SensGlove/python/150701_StraightvsBent.png

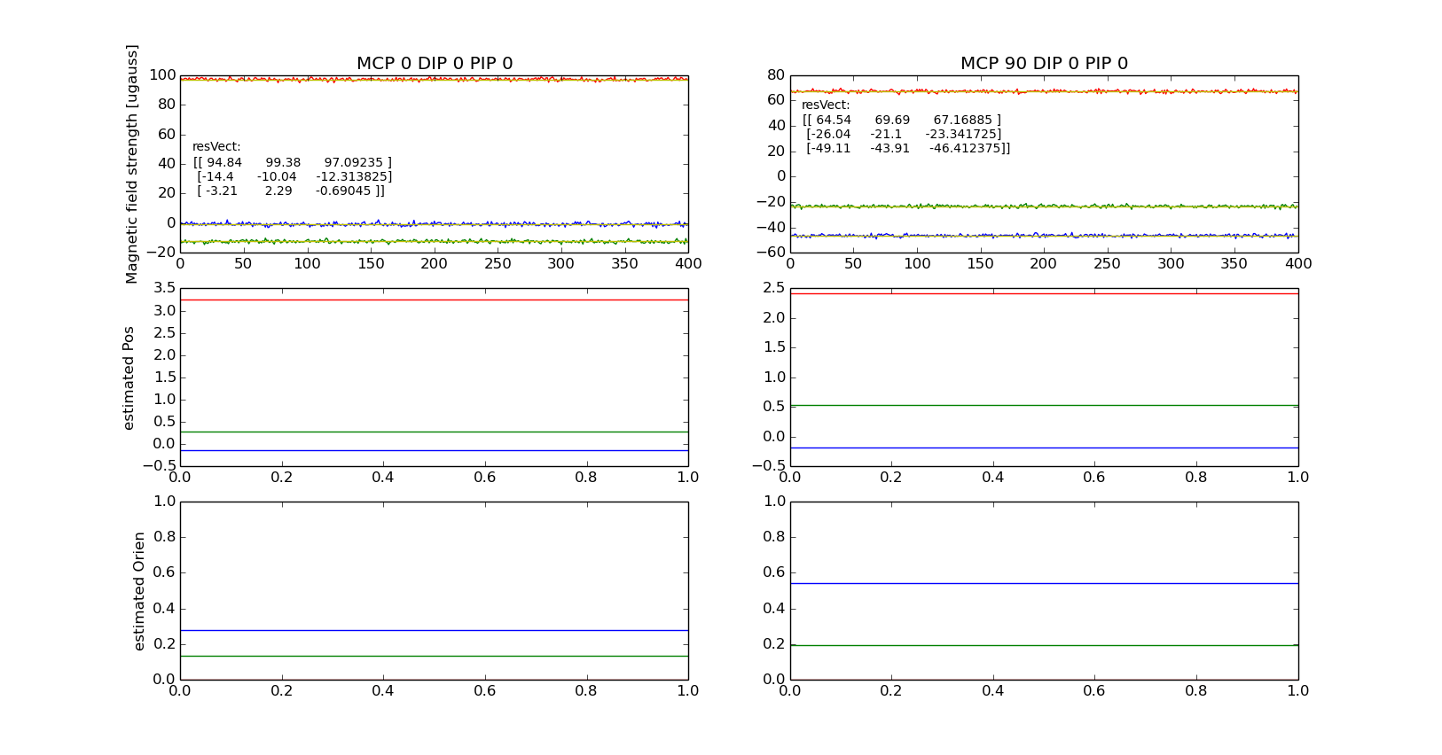
python/150701_StraightvsBent.png
