MuellerDaniel/SensGlove/python/150707_estPosMove.png

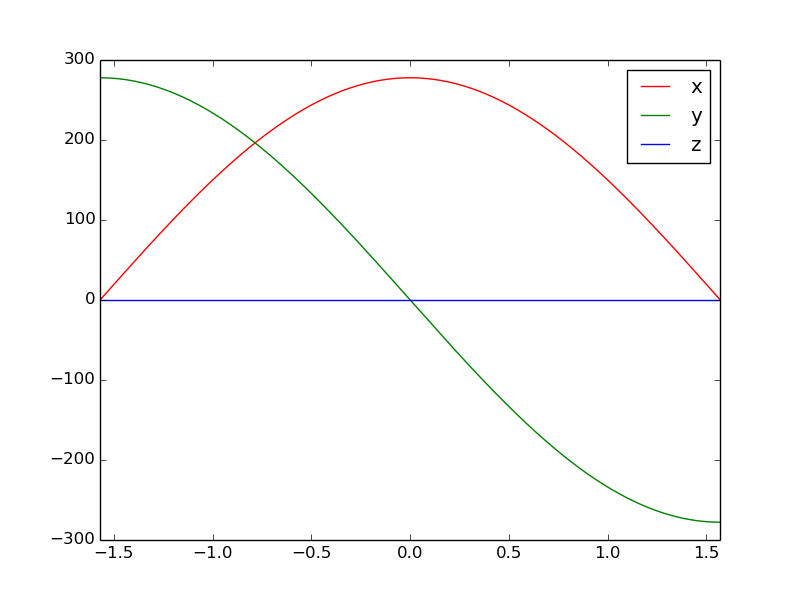
python/150707_estPosMove.png
