MuellerDaniel/SensGlove/python/150707_measHovsVert.png

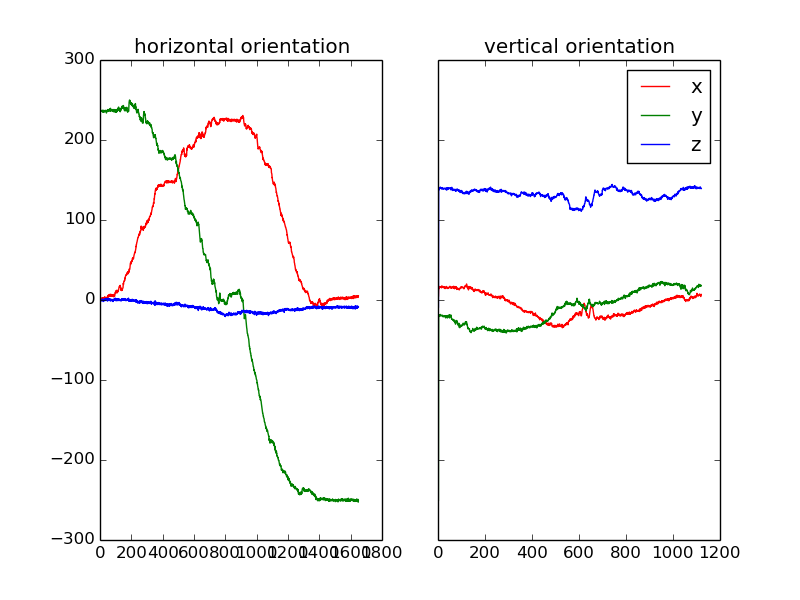
python/150707_measHovsVert.png
