MuellerDaniel/SensGlove/python/150707_modelVSmeas.png

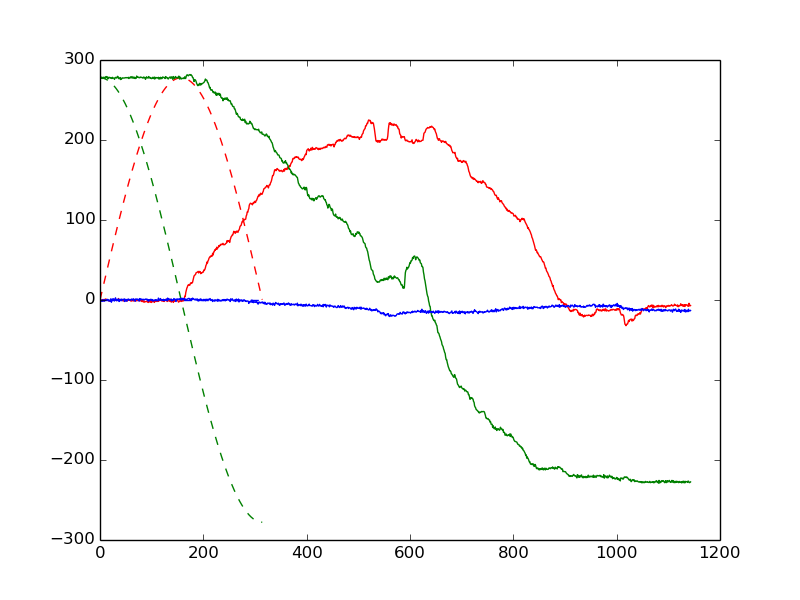
python/150707_modelVSmeas.png
