MuellerDaniel/SensGlove/python/150805_estimatedPos3D.png

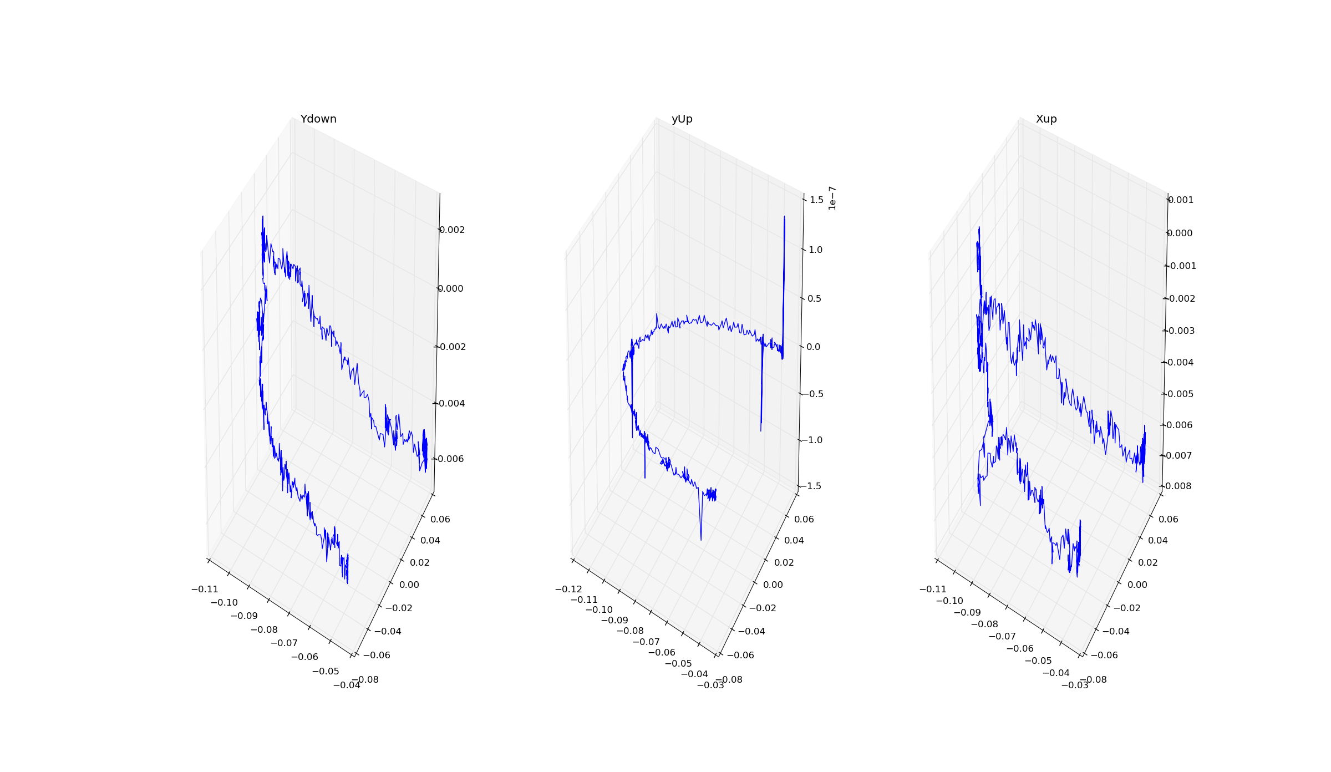
python/150805_estimatedPos3D.png
