MuellerDaniel/SensGlove/python/151030_cyVSPy.png

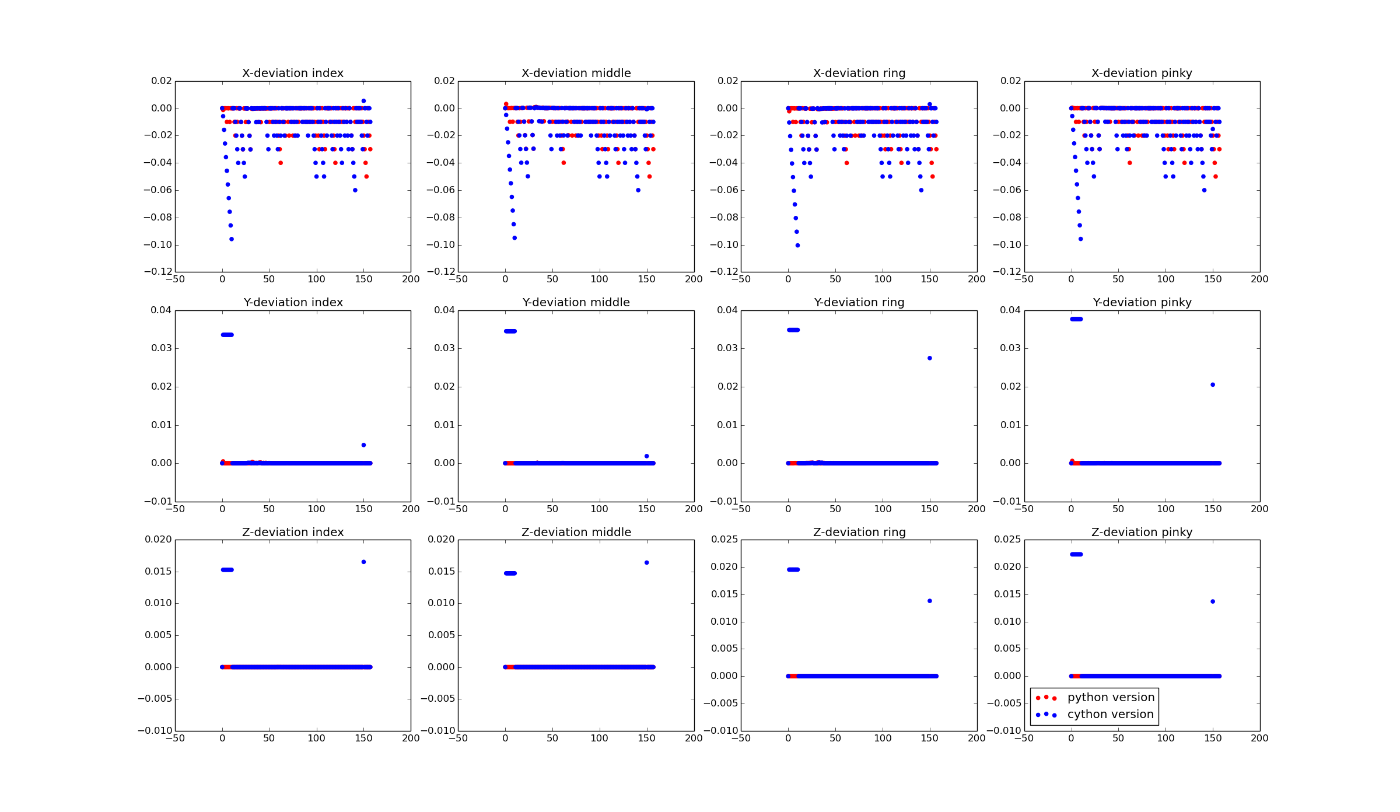
python/151030_cyVSPy.png
