MuellerDaniel/SensGlove/python/estimations1.png

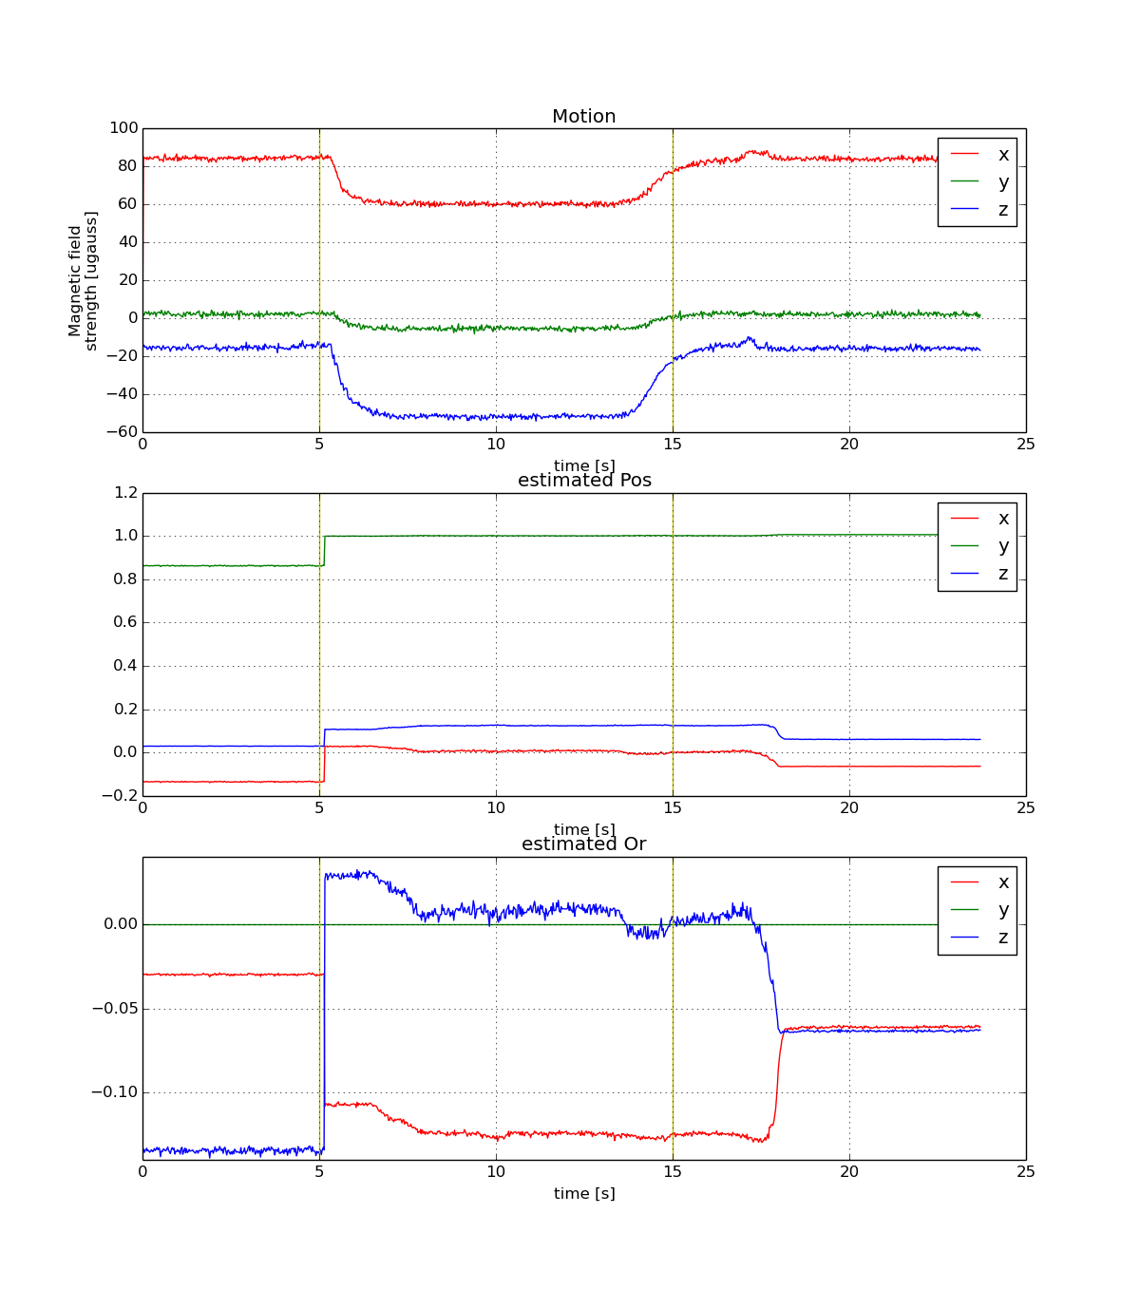
python/estimations1.png
