MuellerDaniel/SensGlove/python/estimations1MagTurned.png

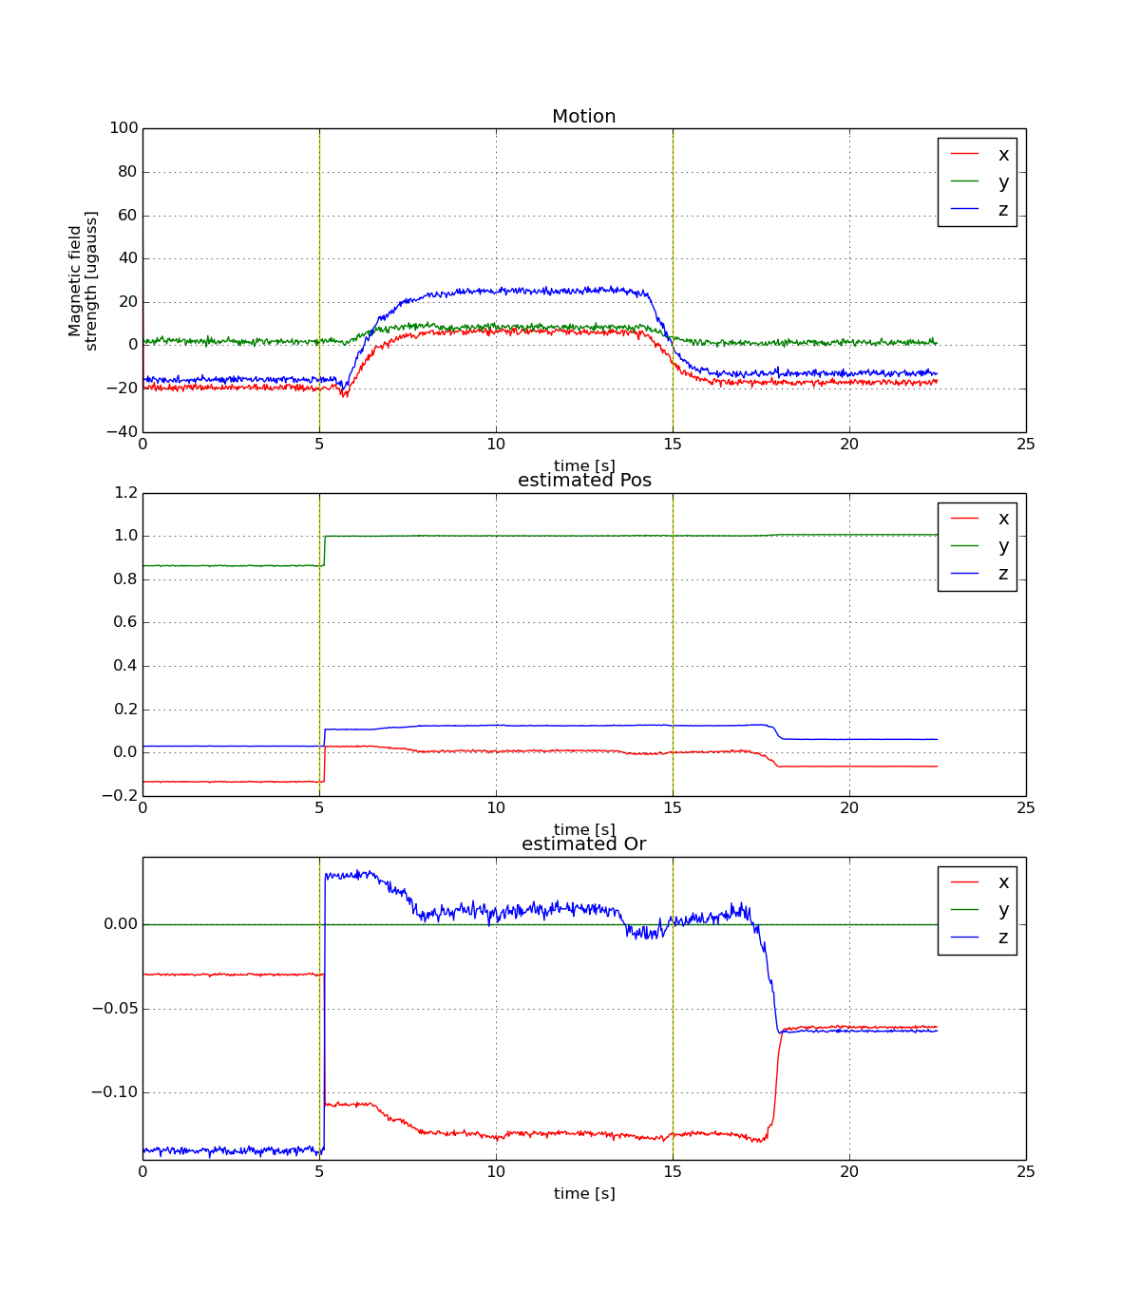
python/estimations1MagTurned.png
