MuellerDaniel/SensGlove/(list of files, cad)

Other CAD files:
openScad/ring2.scad
SensGlove_noVideo/openScad/ring2.scad
SensGlove_noVideo/blender/riggedAni/Rigged Hand.blend
