MuellerDaniel/SensGlove/thesis/texfiles/results.tex

\lhead[\chaptername~\thechapter]{\rightmark}

\rhead[\leftmark]{}

\lfoot[\thepage]{}

\cfoot{}

\rfoot[]{\thepage}

\chapter{Results} \label{cha:results}

\section{Sensor Behaviour} \label{sec:dataRes}

The utilized LSM303D sensors show some general measurement characteristics. If they are exposed to a magnetic field, higher than the configured measurement range, a clipping of the returned value can be observed. In \ref{fig:clipping} this effect can be seen for the values along the magnetic $ x $-axis. The magnet is moved along this axis towards the sensor. One time with the magnetic north pole facing the sensor, the other time with the south pole. As expected, the measured field increases/decreases, by shrinking the distance $ \Delta d $ between sensor and magnet. Looking at \ref{fig:negClip}, approximately at a distance of \SI{4.5}{\cm} between sensor and magnet, the measured field reaches the current lower range. The sensor first stays a while on this value, before it clips to positive. By turning the magnet around \SI{180}{\degree} and therefore measuring an increasing magnetic field by the sensor, a similar behaviour can be observed. This time the clipping obviously occurs from positive to negative and happens at a gap of \SI{4}{\cm} (see \ref{fig:posClip}). Furthermore, this time the returned value clips directly and does not stay on a maximum value. To overcome this effect, one has to set the magnetic full scale range to an appropriate value. However, by setting for every user the maximum range of $ \pm \SI{1.2}{\milli \tesla} $, the precision of the measurements decreases. The approximately reachable maximum full scale range for one user can easily be determined. By simulating the range of possible flexion-extension, which would be performing a fist, and looking at the predicted outcome of the  model, one gets an image for the expectable result of the magnetic field. From that the measurement range can be determined. However, due to the influence of surrounding magnetic fields, this value is only a guideline for the de facto measured field. Based on this context, the magnetic full scale range of the sensors for the ongoing measurements and experiments is set to $ \pm \SI{0.4}{\milli \tesla} $.

\begin{figure}[!htb]
\subfloat[Moving the negative pole towards the sensor]
{ \label{fig:negClip}}
\hfill
\subfloat[Moving the positive pole towards the sensor]
{ \label{fig:posClip}}
\caption[Clipping behaviour of sensor]
{The magnet is moved towards the measurement unit, to record the clipping behaviour of the sensors. The distance from sensor to magnet is represented by $ \Delta d $ in \si{\cm}. For the left figure, the overriding of the sensor begins at around \SI{4.5}{\cm}, for the right, this effect starts at \SI{4}{\cm}. The sensor range is adjusted to be $ \pm \SI{0.4}{\milli \tesla} $, which can be observed by the dataplots.}
\label{fig:clipping}
%python script: 160214_clippingDetection.py
\end{figure}
For evaluating the timing behaviour of the system, the code on the RFduino is debugged. As described in \ref{cha:sensors}, the sensor data rate could be set to a maximum value of \SI{100}{\Hz}, such that one could retrieve new magnetometer values each \SI{10}{\milli \second}. The switching and forwarding of the clock signal via the utilized multiplexer takes only \SI{21}{\nano\second} into account. This value composes a ``break-before-make'' pause of \SI{6}{\nano \second}, to prevent crosstalk between the channels and a propagation delay of \SI{15}{\nano \second}. In order to verify those values and to identify the overall time for acquiring, sending and receiving the measurement data, the respective code sections were timed. It is observed that the overall sampling frequency of the sensors can only be set to \SI{50}{\Hz}. The read out of the registers and the scaling for the hard- and soft-iron distortion values shows an insignificant influence on the timing. Furthermore it makes no difference whether only one sensor unit is read out, or all four, since they all show the same data rate and have measurements available after \SI{20}{\milli \second}.\\
The sending via BLE is implemented by the RFduino environment. The maximum transferable packet size is 20 bytes \cite{rfduino2015data}. The three float values of one sensor, plus an additional float for indicating the device number have a size of 16 bytes. The RFduino has implemented a queue of 20 bytes, to store the data till it is sent. The sending frequency depends on the distance between the host PC (which represents the client) and the RFduino module (which is the server). It is specified to range from \SI[per-mode=symbol]{32}{\kilo \bit \per \second} to \SI[per-mode=symbol]{24}{\kilo \bit \per \second}. In order to ensure that no data packet is overwritten, before it is sent, one has to check the size of the queue each time before writing to it. The client registers via the \ac{GATT} protocol for listening to the notifications of the microcontroller. For the ongoing interpretation of the sensor values, only measurements from all four units are interesting, since in this way the most information about the actual system state can be represented. Therefore, for identifying the overall data rate, the time for receiving four individual data packets from the server is measured. It is observed that the receiving rate is not constant. For a sensor rate of \SI{50}{\Hz} approximately every \SI{50}{\ms} four new packets are received. This leads to a frequency of \SI{20}{\Hz} for the whole system. This high deviation from the actual possible sensor data rate is caused by the low sending frequency of the RFduino. Since the sensors are triggered with a frequency more than twice as high as the values can be received, their quality decreases. Therefore the data rate of the sensors is reduced to \SI{25}{\Hz}, in order to try to acquire more representative measurements. By doing this, the system frequency decreases to \SI{12.5}{\Hz}. However, this leads only to slightly more representative measurements, since the frequency for receiving the obtained data packets is still twice as high as the sensor data rate. Those results were observed, by measuring the acquisition time of 200 packets (each representing the measurements of four sensor units). The stated system frequencies represent the mean over the 200 observed timestamps. \ref{fig:sensTime} represents the distribution of the measured duration for both sensor frequencies.
%\todo{Source of error for timing: The sending via BLE is time critical!... The RFduino safes the data into a queue. When you just put more and more data into this queue, while it is not sent (or without taking care whether the queue is full), you will overwrite entries! With checking the \grqq fullness \grqq of the queue with a while-loop (look at code!) you wait, till you are allowed to push the data to the queue. This ensures, that you don't overwrite entries. However your system is stuck during that time and since the sensor datarate with 50Hz is faster than the sending, data packets are lost! So you should try to adapt the sensor data rate to the sending rate. Taking one measurement out of 5(case with $ f_{sens} \gg f_{ble} $) is less good, than taking one out of 2(case for $ f_{sens} \geq f_{ble} $ ). This could lead to an overall slower acquisition of packets (since you have to wait longer for you sensors), but the values from the sensor are more representative!}
\begin{figure}[!htb]
\centering

\caption[Timing behaviour of sensor system]
{200 sensor packets were timed. Each comprises the data from four individual sensor units. One time the data rate is set to \SI{50}{\Hz}, the other time to \SI{25}{\Hz}. The mean value for $ f_{Sensor}=25\si{Hz} $ is higher than, for $ f_{Sensor}=50\si{Hz} $. However, the variance of the acquisition time is smaller for this and therefore the outcome is more consistent. Moreover the sensor values from a data rate of \SI{25}{\Hz} represent the actual obtained measurements slightly better, than the higher data rate. In the ongoing evaluation, the results for both data rates are taken into account and compared against each other.}
\label{fig:sensTime}
% python script: 160212_timing.py
\end{figure}

\FloatBarrier
\section{Quality of Calibration Procedures} \label{sec:cali}

\subsection{Calibration for Hard and Soft-Iron Effects}\label{subsec:resHardSoft}

Two methods are compared and classified for determining the hard- and soft-iron factors. One is the naive approach, declaring the distortion values by using the maximum and minimum of the obtained measurements for an axis. It is an often cited and trivial method for compensating the distortion factors. On the other hand, the version from Freescale \cite{ozyagcilar2012calibrating} which takes a whole series of measurements into account and only compensates for the hard-iron effects is implemented. 1000 measurements were collected, by rotating the sensor slowly around all possible axes. The environment is a normal lab, without any protections against additional, artificial magnetic fields. After all, the main observable influence on the measurements should still be caused by the earth magnetic field.

In \ref{fig:hs2d} the measurements of each axis combination are plotted in 2D for a clearer identification. The raw values are represented by the red dots, the calibrated by the green and cyan ones. The outline of the corresponding ideal sphere is visualized by the blue circle. It can easily be observed, that the hard iron effects dominate the soft iron factors. The scaling factors for the soft iron values, obtained by the naive approach also reflect this. They lie in the range of $ 1 \pm 0.03 $. Another fact is, that both calibration methods lead almost the same results. In order to compare the quality of the two calibration methods, the distance of each calibrated measurement value to the perfect sphere with radius $ \mathrm{B}_{earth} $ is calculated. The deviation is plotted as a histogram in \ref{fig:devi}. The obtained mean for the Freescale approach is calculated to be $ \mu_{Freescale} = -0.02\si{\milli \tesla} $, for the calibrated values, using the naive method to be $ \mu_{naive} = -0.8\si{\milli \tesla} $. So in the end the values adjusted by the Freescale approach represent slightly more the shape of a perfect centered sphere. One reason for this is, that for the used sensors the hard iron distortion effects dominate over the soft iron ones. Furthermore, since the whole measurement series is taken into account, the behaviour of the sensor is represented much better. The naive approach is very sensitive for noisy signals, since only the peak values characterize the calibration factors. One has to note, that those observations hold only for the used sensor units. For another \ac{PCB} environment or device, the obtained values could be different and the soft iron factors could show a higher influence. For this, the naive approach would probably lead to better results than the Freescale. So in the end the calibration has to be verified and adjusted for the specific sensor and application.\\
The presented procedure was evaluated with several sensors, each showing similar and constant results. As already mentioned in \ref{subsec:hardSoft} this calibration procedure has to be performed for each sensor and the observed values should additionally be scaled to a common value for $ \mathrm{B}_{earth} $.
\begin{figure}[!htb]
\centering
	\subfloat[Obtained measurements along the $ x $ vs. the $ y $ axis]
	{\label{fig:xy}}
%	\hfill
	\subfloat[Obtained measurements along the $ y $ vs. the $ z $ axis]
	{\label{fig:yz}}
	\hfill
	\subfloat[Obtained measurements along the $ x $ vs. the $ z $ axis]
	{\label{fig:xz}}
\caption[2D representation of the raw calibration measurements]{
The measurements where recorded by rotating the sensor around each axis in an environment without artificial magnetic sources. 1000 measurements were collected. The obtained raw values are represented by the red dots. The results of the calibration procedures are plotted by the respective color. The perfect centered sphere is represented by the blue circle with $ r=\mathrm{B}_{earth} $. Already the unscaled values show only a very low influence of soft iron distortion. It is also observed, that the calibrated results do not differ much.}
\label{fig:hs2d}
% python script: checkCalibration.py
\end{figure}
\begin{figure}[!htb]
\centering

\caption[Deviation of the calibrated measurements to the perfect centered sphere]
{The procentual deviation of the two calibration methods to the corresponding perfect centered sphere is visualized. It can be obtained, that the Freescale approach leads to slightly more accurate results, since the mean and variance of the scaled measurements are smaller than for the naive approach.}
\label{fig:devi}
% python script: checkCalibration.py
\end{figure}
%\todo{make statement about the range!}

%In \todo{3d} the calibrated and the uncalibrated data points are plotted, with a sphere around them. One thing that is clearly visible here is the shift, caused by the hard iron effects. In \todo{2d} this offset is also observable. Recognizable by those two plots is also the fact, that the influence of the soft-iron distortion is very small. The data points lie already on an almost perfect sphere. This is also represented in those scale values, calculated by the Winer approach. They lie in the range of $ 1 \pm 0.03 $. That both calibration methods serve almost the same results can already be seen by the fact that the blue and green datapoints are overlapping each other. In order to compare the two calibration methods, the distance of each calibrated value to the perfect sphere with radius $ \mathrm{B}_earth $ is calculated. The outcome is shown in \todo{deviation}. In the end, the mean value of the deviation for the Freescale approach is smaller than those, calibrated by the Winer method (for this particular example: $ \mu_{Freescale} = -0.0842\si{\micro \tesla}, \mu_{Winer} = 6.5525\si{\micro \tesla} $). Because the hard-iron offsets dominate the soft-iron effects, the Freescale method is more accurate than the Winer approach, since it takes all the observed measurements into account and not just the minimum and maximum values. Therefore for the utilized sensor units, which show small soft-iron deviation, the Freescale approach is preferred. The provided procedure was evaluated several times, each time showing similar and constant results. As already mentioned in \ref{subsec:hardSoft} this calibration procedure has to be performed for each sensor and the observed values all have to be scaled to a common value for $ \mathrm{B}_{earth} $.

%\subsection{Determining the Fitting Parameters for the Model} \label{subsec:resModelFit}
%
%\todo{Rewrite!}
%For determining the scaling factors to the model, the sensor rack is placed onto a cardboard box with a height of \SI{2}{\cm}. The magnet is statically aligned in the same direction as the sensor $ x $-axis and is moved along the y-axis on a flat surface. The distance in $ x $-direction is held static. The origin of the coordinate frame is determined to be the position of the upper most sensor unit. The magnet is moved at a distance of $ x=5\si{\cm} $ and $ x=7\si{\cm} $ from $ y=-6\si{\cm} $ (which is the $ y $-height of the under most sensor) to $ y=0\si{cm} $ (which is the $ y $-heigth of the upper most sensor). For defining the scaling factors, the B-field, which should be observed by the sensor is calculated. The range of the actually measured values is then fitted to the simulated ones for each axis. As a initial step, the surrounding magnetic field has to be determined and cancelled statically. The scaling factors for the two different $ x $-positions should lie around 1 and be the same. However this is not the case. The obtained factors are listed in \ref{tab:scaleValues}. As expected, the values are near to one. The mean over all factors is $ 1 \pm 0.15 $. The influence of the two scaling factors on the de facto obtained measurements and the calculated values is visualized in \ref{fig:flatFit} for $ x=7\si{cm} $.
%\begin{table}[h]
%\centering
%\begin{tabular}{c c c c}
%\toprule
%distance in &  &  &  \\ 
%$ x $-direction [cm] & $ x $ & $ y $ &  $ z $ \\ \midrule
%5 & 1.21 & 1.26 & 1.13 \\
%7 & 1.09 & 1.18 & 1.04 \\ \bottomrule
%\end{tabular}
%\caption{The calculated scaling factors, for fitting the range of the sensor values to the one, predicted by the model. One can see, that the scaling factors are very small. This is reasonable, since the sensors are calibrated. However due to human interaction, not perfectly calibrated sensor values and the offset of the earth magnetic field, the scaling factors are not equal to 1. The mean over all 6 factors is 1.15, the standard deviation is 0. Further on it is observed that the factors for two different distances in $ x $-direction also lead to distinctive scaling values. The overall difference between the norm of those scaling vectors is 0.17.}
%\label{tab:scaleValues}
%\end{table}
%\begin{figure}[!htb]
%\includegraphics{pictures/plots/flatFit.png}
%\caption{Comparison between the scaling factors, observed from $ x=5\si{\cm} $ and $ x=7\si{\cm} $. The simulated data is for a distance of $ x=7\si{\cm} $. The $ y $-position to the corresponding time step is plotted in cyan. Please note, that the measured values cannot be compared directly to the results of the simulation. The simulation assumes a constant movement of the magnet. This however cannot be performed perfectly, since it is done by hand. Due to this fact, also the distance in $ x $ direction can slightly change. The plot reflects the differences between the two different scaling factors and the raw values for each sensor axis. In this way it can be observed, that the results show the most variation along the magnetic $ x $-axis. This is only reasonable, since on this axis the magnetic flux density changes the most.}
%\label{fig:flatFit}
%% python script: 160201_flatSensFit.py
%\end{figure}
%Especially the plot shows, that this deviation between the results is not negligible. The highest difference between model and measured values is observable along the magnetic $ x $-axis. Since the biggest change happens for the utilized motion on this axis, also the biggest impact of the scaling factors can be obtained here. An exact difference value between the perfect B-field values from the model and the actually observed and scaled ones is not directly possible. The values of the model assume a movement with a constant velocity. Since the magnet motion is performed by hand, the measured field is not changing constantly. However for this reason, the magnet is held still at some dedicated $ y $-positions, to get an impression on the difference of the scaled measurements to the calculated field. This is represented by the flat sections in the graph. The deviation from the perfect values for those positions is calculated and normed, to get a representation of the difference to the overall magnetic field strength. \ref{tab:diffScaled} presents the results.
%\begin{table}[h!]
%\centering
%\begin{tabular}{c c c c}
%\toprule
%\multirow{2}{*}{y-Position [\si{cm}]} & scaled to  & scaled to  & \multirow{2}{*}{raw [\si{\micro \tesla}]} \\ 
% & $ x=5\si{cm} $ [\si{\micro \tesla}] & $ x=7\si{cm} $ [\si{\micro \tesla}]  & \\ \midrule
%-6    & 0.0  &  0.0  & 0.0 	\\ 
%-4    &	0.94 &  2.5  & 3.7 	\\ 
%-2    &	2.5  &  2.6  & 5.7 	\\ 
%0.0	  &	6.0  &  0.0  & 6.3 	\\ \bottomrule
%\end{tabular}
%\caption{The deviation of the scaled magnetic field to the simulated at the stopped positions. The observed values show, that an exact fitting, by scaling only for the maximum and minimum values for a certain movement does not lead identical and exact results.}
%\label{tab:diffScaled}
%% python script: 160201_flatSensFit.py
%\end{table}
%As a source for the observed disagreement, one could head that the whole procedure is performed by a human being. The position values are only determinable up to a certain amount of accuracy, as well as the start and end points of the performed movement. Further on the already stated errors, induced by the hard and soft iron calibration routine have also an impact, which is not determinable. Also the surrounding magnetic field, though it is measured and subtracted before the measurements started, cannot be eliminated totally and has an impact. Since this calibration procedure does not result in clear scaling values for the sensors, it is not further used in this work. 
%
%So in the end, for scaling the observed sensor values to the model, a predefined fitting gesture is used, as described in \ref{subsec:modelFit}. As stated, this approach does not only compensate the slight errors, induced by the calibration procedure, it mainly adjusts the observed magnetic field to the provided hand and sensor positions. As described Since those values are only definable by a certain grade of accuracy by hand and  

\FloatBarrier

\subsection{Elimination of Earth Magnetic Field} \label{subsec:resEarthEli}

Since a constant elimination of the earth magnetic field would be very important for a portable system, two methods of the approach, presented in \ref{subsec:earthEli} are tested. The difference between those two lies in the determination of the sensor orientation. The one estimates it by using an implementation of a Madgwick Filter, provided by \cite{mikeshub2012}. This algorithm can directly be executed with the information of a single sensor device. The accelerometer and the gyroscope are already on the breakout board. So for this method, no additional sensors have to be mounted onto the sensor bracket. The other approach uses an additional \ac{IMU}, which can output the orientation directly as quaternion. The MPU9250 from Invensense \cite{MPU2014} is used for this. This second method could lead to more exact orientation measurements, since the quaternion is calculated internally by the measurement unit itself. The orientation of the magnetometers relative to each other does not change, since they are placed inside the self designed bracket. Therefore it is sufficient, to determine the orientation of the sensor rack. For the implementation, follow the steps presented in \ref{subsec:earthEli}. As an intermediate step, the calculated relative orientation $ R_{d} $ of both methods was inspected and was proven to represent the truth.

As an early observation, the approach using the Madgwick filter is considered not to fulfil the needs. Since the readings of the magnetometer are used, for guaranteeing a stable and non-drifting estimation of the orientation, the artificial magnets interfere this algorithm. This was observed by a drift of the values over time, when introducing the artificial magnets. So the further verification was only performed with the MPU9250 sensor, with whom this drift behaviour was not observed. Nevertheless it is mentionable that the upcoming results for cancelling solely the earth magnetic field (in absence of artificial magnets) were similar for both methods (beside the mentioned sensor drift). A proper working system should constantly return a magnetic field of almost \SI{0}{\tesla}, when it is rotated in an environment without artificial magnets. In order to verify this, the sensors are slowly moved around each axis. By comparing the results with and without the subtraction of the initially observed magnetic field, one should get an impression on the quality of the method. In \ref{fig:earthCancelRes} the observed data of each axis is displayed.\\
\begin{figure}[!htb]
\centering
 
\caption[Quality of earth cancellation]
{The result for the cancellation of the earth magnetic field, relative to the sensor rotation is displayed. One change in orientation is performed. The plot is divided into three orientation areas. The initial orientation at the beginning and end and a rotated orientation in between. That the surrounding magnetic field can be cancelled is shown if the sensor is orientated as introductory. However, the large deviations from \SI{0}{\tesla} during the movement in between the two orientation areas show, that the implemented approach does somehow not work for every rotation. As comparison, the raw values without subtracting the rotated surrounding magnetic field are also plotted.}
\label{fig:earthCancelRes}
% python script: 160217_earthCancel.py
\end{figure}
The plot shows the measured magnetic field along all three axes for one sensor with and without subtracting the rotated initially observed field $ \mathrm{B}_{earth} $. It is visible, that unfortunately the elimination method does not work properly. At the beginning, the B-field with the cancellation is \SI{0}{\tesla}. However, by rotating the device, the observed field changes a lot. For the results along the x-axis, the offset can be compensated relatively good. But for the values observed along the y- and z-axis, this does not hold. By moving the sensor in its starting position again, it can be seen that the surrounding field is eliminated pretty well again. So the dynamic behaviour of the implemented approach is not good. This short example visualizes only a simple movement around one axis. Even for this, the surrounding magnetic field can not be eliminated. Small changes could be claimed upon calibration errors or small static magnetic sources in the environment, such as cell phones or metallic objects. But the observed deviation from \SI{0}{\tesla} is much higher than this. So in the end, the surrounding magnetic field can not be cancelled with the presented method. Further investigation has to be done for this. However, since this work focuses on the evaluation for pose estimation with magnets, the cancellation of the earth magnetic field is left by that. For the ongoing evaluation, it has to be noted, that the sensors and therefore the hand is always held static. The influence of the surrounding magnetic field can then be seen as an offset which is statically subtracted.

\FloatBarrier
\section{Evaluation of the Magnetic Field Models} \label{sec:modelDif}

In order to verify the two introduced models for describing the magnetic field of a cylindrical bar magnet with real measurements, a trivial movement is inspected. The sensor is placed at the origin and the magnet is moved along its $ x $-axis. The motion is performed from a distance of $ x=6\si{\cm} $ to $ x=13\si{\cm} $. The cylindrical model represents the ground truth for the utilized case of a bar magnet. This is valid, since in this simple case the influence along the axis of magnetization wants to be measured. Therefore the complex cylindrical formula is reduced to the common known \ref{eq:b_z}. The results are plotted in \ref{fig:modCompFlat}.
\begin{figure}[!htb]
\centering

\caption[Comparing the models and sensor measurements for flat movement]
{The magnetic field, for increasing the distance in $ x $-direction from sensor to magnet. The values are calculated by the both magnetic model equations. The plot in the middle shows the difference of the measurements and the dipole model to the exact values of the cylindrical model. One can observe, that the error of the dipole model decreases over the distance. The error of the measurements should not be overrated, since the movement is performed by hand and a constant change in the distance $ x $, as assumed by the models, is not perfectly performable. This can be seen by the lower plot, where the position to the corresponding observed magnetic field values is plotted. Furthermore the accuracy of the performed movement is also not perfect. The small deviations from to the predicted values show however, that both models represent the truth.}
\label{fig:modCompFlat}
% python script: 160221_modelComp.py
\end{figure}
Note, that the offset due to the surrounding magnetic field of the measurement data is removed beforehand. The plot shows pretty well that the two magnetic field models have the same behaviour and can represent the measurements quite good. The dipole model serves as a reasonable approximation. As the influence of the magnet goes further away, also the deviation from the cylindrical model decreases. The maximum error is \SI{0.008}{\milli \tesla}. For the measurements, the highest deviation is observed to be \SI{-0.045}{\milli \tesla}. Note that the sensor values suffer from a not perfectly consistent moving speed and accuracy restrictions. This can be seen, by regarding the positions to the corresponding observed magnetic field. The by hand moved magnet shows a bit of a ``delay'', compared to the cylindrical model. Therefore the observed differences from the simulated values should not be overrated.

\FloatBarrier
\section{Evaluation of the Human Hand Model} \label{sec:evalHand}

A similar verification is done for classifying the measurements directly on the hand. Exemplary the bending of the index finger about \SI{90}{\degree} around the \ac{MCP} joint is evaluated. For calculating the expected magnetic field at a single sensor unit for this movement, excited by wearing a single magnet on the fingertip, the hand parameters and positions have to be determined. Those are the bone lengths and the positions of the sensor and the joint. As already mentioned beforehand, those values are determined by hand with a calliper, what in turn introduces deviations from the actual real anatomic dimensions. So the predicted magnetic field calculated by the model equations is expected to show slightly different values as the actual sensor measurements. For the case of foreseeing the values, from a single sensor unit for one finger, the values to determine are the following: 3 bone lengths, one 3D position for the joint and one for the sensor, which makes in total 9 anatomic parameters. How good they can be measured and which influence they have on the predicted magnetic field is visualized in \ref{fig:measHand}a. It should be stated, that the actual behaviour over time should not be overestimated again, since the model assumes a constant motion velocity, which in turn cannot be achieved by a human. In the end, the difference between measured and predicted values should show a similar behaviour as for the trivial case presented in \ref{sec:modelDif}. Beneath the predicted and de facto measured magnetic flux densities, the normed difference over the three dimensions is displayed. This should give an overall measure for the deviation of the measurements and the model results.\\
\begin{figure}[!htb]
\centering

\caption[Influence of erroneous hand dimensions on model predictions]
{The difference between the model prediction of the magnetic flux densities and the actual measured sensor data can be seen in figure a. The values are calculated by using the hand measured anatomic parameters for the bone lengths, the joint and sensor positions. The high deviation from the measurements is not negligible. Passing the sensor values as is into the estimator for the finger state vectors would not lead to the representative angles. In figure b, the sensor values are naively scaled to the model prediction. With those measurements, adapted to the introduced fitting gesture, reasonable results for the state estimation are expected.}
\label{fig:measHand}
\end{figure}
One can see, that the predicted and the measured values show a similar behaviour. But in the end, there is a high difference between them, especially for the values along the $ x $ axis. The highest observable divergence for the presented measurements and the applied anatomic dimensions lies at \SI{0.019}{\milli \tesla}. This shows that the hand determined parameters do not resemble the proband's hand anatomy good enough. Passing those sensor values to the minimization algorithm for the hand pose estimation and using the hand measured anatomic positions, no good results are expected to be observed. The obtained magnetic field is not representable with the model equations, using the underlying hand dimensions. However by remeasuring and adjusting the 9 dimensional parameters by trial and error, a set of satisfying values can be found. For the introduced easy case, a more reasonable magnetic field gets predicted for example by shrinking the length of the proximal bone by \SI{3}{\cm}. A measurement error of such a size is in turn not possible. Therefore to achieve a reasonable error compensation, all 9 dimensional parameters should be changed only up to a size of around \SI{1}{\cm}, which seems a more reasonable measurement error. However, performing this by trial and error did not lead to reasonable results. Especially regarding the overall goal to estimate multiple sensors with several magnets and introducing therefore even more anatomic parameters. Also attempts to estimate those parameters did not lead to reasonable results. For the presented case for one magnet and one sensor, nine anatomic parameters have to be estimated, with only a set of 3 measured magnetic flux densities. Additionally, one does not know the exact finger angles to the actual measurement and therefore also those states have to be estimated. This brings in too much \ac{DOF} and in the end the anatomic parameters can only be determined up to the non-satisfying accuracy.\\ 
A naive possibility to achieve at least a satisfying relationship between the measurements and the model predictions would be to scale the obtained sensor values along each axis to the respective predicted values. Of course, by this method the nonlinear influence of each of the dimensional parameter is dropped. However, \ref{fig:measHand}b shows that the difference can be reduced very efficiently for the introduced gesture of bending the \ac{MCP} joint about \SI{90}{\degree}. The maximum error between the measured and the predicted values is now \SI{0.005}{\milli \tesla}. One could state, that this error is induced by the not constantly performed motion. Of course, the obtained scaling factors for each axis are only adapted to the performed gesture. However, it comprises the most expected movements, being the bending of flexion-extension. Another pose, to fit the measurements to, would be the bending of the fingers to a fist. By this calibration motion it is expected, to also compensate for the errors of the measured bone lengths. The suitability of the introduction of a fitting gesture, to naively scale the measured values to the error-prone anatomic parameters has to be evaluated with real measurement sets.

\FloatBarrier
\section{Expectable Magnetic Flux Densities}

% Overall feeling about expectable magnetic fields...
Nevertheless, by looking at the overall observed field for the individual measurement axes of the movement from beforehand, one could get an impression on the forthcoming observable magnetic flux densities. For a more natural picture of the observed magnetic field values along each axis, one could think of it as a vector in space, pointing from the magnetic south to the north pole.\\ 
The expected magnetic flux densities for the beforehand mentioned motion are plotted once more in Figure\ref{fig:indComp}. Since the gesture starts with a stretched finger, the biggest value for the magnetic flux density is measured on the $ x $-axis. By bending the \ac{MCP} joint around \SI{90}{\degree}, the influence on the $ x $-axis decreases and on the $ z $-axis increases. Remember, that the position of the magnet is moved towards the negative $ z $ direction, therefore also the observed values for this axis are negative. For the change of the magnetic flux density along the $ y $-axis, only small changes are expected for the sensor beneath the index finger. This is only reasonable, since no lateral movement is performed and the sensor is almost directly beneath the magnet. By comparing those statements for the sensor under the index finger with the ones under the pinky, one could see the influence of different sensor positions. The values, expected for the unit beneath the index finger show higher changes along the $ x $ and $ z $ axes, than for the one under the pinky. The magnet is nearer to this unit and therefore this behaviour is only reasonable. For the expected measurements along the $ y $-axis, the unit under the pinky finger shows higher changes, induced by the shift in this direction.
% earth comparing
Another observation, that can be made by this example is the range of the expected measurements. For these specific finger lengths and sensor positions, the observable values lie in a range of $ \pm 0.03\si{\milli \tesla} $. This is a small range, especially compared to the range of the surrounding magnetic field, observed in \ref{subsec:resHardSoft}. The influence of this disturbing field along a single axis is measured to lie around \SI{0.04}{\milli \tesla}, which is as high, as the artificially induced field.\\
\begin{figure}[!htb]
\centering
\subfloat[Bending only the \ac{MCP} of the index finger. The values for the sensors beneath the index and the pinky finger are displayed. Only one magnet on the index fingertip is utilized.]
{ \label{fig:indComp}} 
%\hfil
\subfloat[Simulating the maximum movement of adduction-abduction of the index finger. The measurements, observed by the sensor beneath the index finger are plotted. Only one magnet on the index fingertip is utilized.]
{ \label{fig:ad-abComp}}\\

\subfloat[][Bending the \ac{MCP}, \ac{PIP} and \ac{DIP} of the four fingers simultaneously about \SI{90}{\degree}. The measurements,\\observed by the sensor beneath the middle and the pinky finger are plotted. All four fingers are\\equipped with magnets.]
{ \label{fig:fistComp}}	
%\includegraphics{pictures/plots/fingSim.png}
\caption[Simulating the magnetic field for various finger movements]{The anticipated values for various sensor positions, predicted by the cylindrical model for wearing one magnet on the index finger (a, b) and four magnets (c). It is observable, that the predicted fields are distinguishable among the different sensors. Even the slight movement of adduction-abduction causes a remarkable influence.}
\label{fig:compMovement}
%script: 160221_anglePlot.py
\end{figure}
% ad-ab
In \ref{fig:ad-abComp} the influence of the maximum achievable adduction-abduction movement of the stretched index finger is visualized. Here, the main change of the magnetic flux density can be observed along the $ y $-axis of $ s_{Index} $. Since the movement happens only in the $ x-y $ plane of the sensor, this is just reasonable.\\
% fist
As another example, the movement of the fist by all four fingers, each equipped with magnets on the fingertips is plotted in \ref{fig:fistComp}. Note, that the values for the \ac{MCP}, \ac{PIP} and \ac{DIP} are increasing simultaneously for each finger at the same time. The values, observed by $ s_{Middle} $ and $ s_{Pinky} $ are plotted exemplary. As mentioned beforehand, the values, especially observed along the $ x $- and $ z $-axis first go into the negative direction and then increase to the positive. This is because the magnet first is moved ``away'' and then gets nearer to the sensor units again. Along the $ y $-axis, once more the influence of the sensor position is observable. The unit beneath the middle finger is influenced by magnets to the left (positive $ y $-direction) and to the right (negative $ y $-direction). The one beneath the pinky finger has only magnetic influences to the left of it. This is why the curve for the observable magnetic field along the $ y $-axis is in the end slightly increasing for $ s_{Middle} $ and decreasing for $ s_{Pinky} $. Another influence on this behaviour are the lengths of the bones, and therefore the overall distance, determined by the fingers. So for another constellation of hand parameters, the overall magnitude of the observed values could decrease or increase. Furthermore, one could note, that the overall observed magnetic flux density by four deployed magnets is around 10 times higher, than measuring only a single magnet.\\
By the introduced sensor rack, a constant localization of the measurement units relative to each other is given. Therefore the observable behaviour and influence of the individual magnets compared to each other can be seen as kind of a characteristic for the performed finger motion. So by comparing the differences between each observed sensor measurements, one could make a first statement about the finger poses. By introducing more sensor units at various positions, one would expect to get better results for the estimated pose, since each pose causes an individual magnetic field at each sensor. Last but not least, this is why the group of Ma et al. is using six sensors in total, to estimate the position of a single magnet. Since the goal of the underlying thesis is to utilize a flexible and wearable system, only four sensor units are used. The presented claim is proven throughout simulation and real measurements. The results are given in the following chapters of this work.

\FloatBarrier
\input{texfiles/estimationRes}
