MuellerDaniel/SensGlove/SensGlove_noVideo/datasets/results_compare_xl.xlsx

ALL (all evaluated with real handDims)
 | time | d_A11 |  | time | c_A11 |  | time | d_A12 |  | time | c_A12 |  | time | d_A14 |  | time | c_A14
set1 | 0.024 | 0.940 | 0.050 | 0.031 | 0.873 | 0.077 | 0.032 | 0.641 | 0.014 | 0.042 | 0.581 | 0.020 | 0.057 | 0.620 | 0.023 | 0.075 | 0.623 | 0.029
set2 | 0.027 | 0.706 | 0.023 | 0.035 | 0.766 | 0.045 | 0.037 | 0.644 | 0.008 | 0.049 | 0.587 | 0.012 | 0.066 | 0.629 | 0.011 | 0.091 | 0.626 | 0.013
set3 | 0.029 | 0.741 | 0.021 | 0.037 | 0.809 | 0.053 | 0.037 | 0.646 | 0.010 | 0.048 | 0.654 | 0.011 | 0.068 | 0.668 | 0.010 | 0.092 | 0.669 | 0.011
set4 | 0.025 | 0.786 | 0.079 | 0.029 | 0.726 | 0.112 | 0.027 | 0.752 | 0.083 | 0.033 | 0.467 | 0.017 | 0.045 | 0.643 | 0.033 | 0.062 | 0.552 | 0.027
set5 | 0.028 | 0.855 | 0.042 | 0.035 | 0.806 | 0.046 | 0.031 | 0.889 | 0.047 | 0.039 | 0.807 | 0.049 | 0.052 | 0.698 | 0.023 | 0.088 | 0.668 | 0.027
set6 | 0.025 | 0.622 | 0.019 | 0.029 | 0.641 | 0.046 | 0.032 | 0.547 | 0.010 | 0.039 | 0.495 | 0.011 | 0.060 | 0.547 | 0.009 | 0.083 | 0.495 | 0.011
set7 | 0.028 | 0.806 | 0.038 | 0.034 | 0.668 | 0.038 | 0.036 | 0.716 | 0.036 | 0.044 | 0.675 | 0.044 | 0.059 | 0.601 | 0.018 | 0.081 | 0.567 | 0.026
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
