MuellerDaniel/SensGlove/datasets/evalSets/estResults/160226_real/results.csv

 | time | d_A11 |  | d11 |  | time | c_A11 |  | c11 |  | time | d_A12 |  | d12 |  | time | c_A12 |  | c12 |  | time | d_A14 |  | d14 |  | time | c_A14 |  | c14
set5 | 0.028 | 0.8554639201 | 0.0416403045 | 0.8130391659 | 0.0514995285 | 0.035496384 | 0.8063995602 | 0.0459993949 | 0.7600953953 | 0.0548938195 | 0.0313682114 | 0.8887543678 | 0.0465507098 | 0.8357101203 | 0.0613492623 | 0.0389619087 | 0.8074221397 | 0.0492215823 | 0.7467541792 | 0.0614826429 | 0.0515169585 | 0.6975129268 | 0.0230677136 | 0.6427687861 | 0.0291105761 | 0.0884435737 | 0.6682726193 | 0.0271086903 | 0.6185531973 | 0.0315206731
set6 | 0.0252250715 | 0.6216215628 | 0.0189101443 | 0.4788667117 | 0.026801131 | 0.0293758724 | 0.6414928676 | 0.0460358944 | 0.5574239559 | 0.0565966028 | 0.0319058425 | 0.5466550917 | 0.0101441961 | 0.4156596144 | 0.0119673982 | 0.0388202116 | 0.4947714495 | 0.0113211838 | 0.4041269125 | 0.0120753301 | 0.0595635053 | 0.5471628028 | 0.0092853199 | 0.4247223325 | 0.0101273673 | 0.0829393359 | 0.4953698694 | 0.0105305464 | 0.3983257775 | 0.0118057961
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
