MuellerDaniel/SensGlove/datasets/evalSets/results_allH160210.csv

 | time | d_A11 |  | d11 |  | time | c_A11 |  | c11 |  | time | d_A12 |  | d12 |  | time | c_A12 |  | c12 |  | time | d_A14 |  | d14 |  | time | c_A14 |  | c14
set1 | 0.0244101215 | 0.939773406 | 0.0500117781 | 0.8632103519 | 0.070380342 | 0.0310058773 | 0.8728405795 | 0.0766463581 | 0.7915836999 | 0.0971517271 | 0.0315122564 | 0.640913041 | 0.0142401291 | 0.5363527142 | 0.0160768913 | 0.0419694045 | 0.580978231 | 0.0197223826 | 0.4931300213 | 0.0188704942 | 0.0569950144 | 0.6200914276 | 0.0230533971 | 0.5356539129 | 0.0261482561 | 0.0752260853 | 0.6226036978 | 0.0292309937 | 0.5341513817 | 0.0316219707
set2 | 0.0270891359 | 0.7055972682 | 0.0233864203 | 0.6352081243 | 0.0259696106 | 0.0345019826 | 0.7664406598 | 0.0453012417 | 0.6899053634 | 0.0547901576 | 0.0374483375 | 0.6443518204 | 0.0083271468 | 0.5487496673 | 0.008319179 | 0.0492417162 | 0.5865065628 | 0.0116657017 | 0.4975160381 | 0.0107618352 | 0.0659604142 | 0.6288008079 | 0.0113344554 | 0.5411316563 | 0.011301391 | 0.0908579644 | 0.6262448098 | 0.0131437818 | 0.5336286178 | 0.0142628799
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
