MuellerDaniel/SensGlove/python/modelEqMultiCython.py

# -*- coding: utf-8 -*-
"""
Created on Wed Jul 15 09:53:19 2015

@author: daniel
"""

import numpy as np
from scipy.optimize import *
from sympy import *
import time
import fcnCyPy as fcn


def barMagnet(x):
    l_mag = 0.015
    b_mag = l_mag/2
    r_mag = 0.0025
    Br = 1.26e4 
#    b = (Br/2)*((l_mag+x)/np.sqrt(r_mag**2+(l_mag+x)**2) - (x/np.sqrt(r_mag**2+x**2)))
    b = (Br/2) * ((x+b_mag)/sqrt(r_mag**2+(x+b_mag)**2) - (x-b_mag)/sqrt(r_mag**2+(x-b_mag)**2))
    return b
    


"""
estimating the positions
"""

def evalfuncMag(P,S):
    """returns the magnetic field

    Parameters
    ----------
    P : array
        the position
    S : array
        the position of the sensor
    """
    H = 1*(P-S)        # this worked for the example on the flat paper...
    R = 1*(S-P)
#    H = -R+(P-S)
    factor = np.array([1, 1, 1])
#    return [((3*(np.cross(H,R)*R)/(np.linalg.norm(R)**5)) -
#                                        (H/(np.linalg.norm(R)**3)))] * factor
    no = np.sqrt(R[0]**2+R[1]**2+R[2]**2)
#    print "cross product: ",np.cross(H,R)
    return [((3*(np.cross(H,R)*R)/(no**5)) - (H/(no**3)))] * factor

def evalfuncMagDot(P,S):
    """returns the magnetic field

    Parameters
    ----------
    P : array
        the position
    S : array
        the position of the sensor
    """
    H = 1*(P-S)        # this worked for the example on the flat paper...
    R = 1*(S-P)
#    H = -R+(P-S)
    factor = np.array([-1, -1, -1])
#    return [((3*(np.cross(H,R)*R)/(np.linalg.norm(R)**5)) -
#                                        (H/(np.linalg.norm(R)**3)))] * factor
    no = np.sqrt(R[0]**2+R[1]**2+R[2]**2)
    return [((3*(np.dot(H,R)*R)/(no**5)) - (H/(no**3)))] * factor

def evalfuncMagDotH(P,H,S):
    """returns the magnetic field

    Parameters
    ----------
    P : array
        the position
    H : array
        the orientation
    S : array
        the position of the sensor
    """
#    H = 1*(P-S)        # this worked for the example on the flat paper...
    R = 1*(S-P)
#    H = -R+(P-S)
    factor = np.array([1, 1, 1])
#    return [((3*(np.cross(H,R)*R)/(np.linalg.norm(R)**5)) -
#                                        (H/(np.linalg.norm(R)**3)))] * factor
    no = np.sqrt(R[0]**2+R[1]**2+R[2]**2)
    return [((3*(np.dot(H,R)*R)/(no**5)) - (H/(no**3)))] * factor

def evalfuncMagH_dot(P,H,S):
    """returns the magnetic field

    Parameters
    ----------
    P : array
        the position
    S : array
        the position of the sensor
    """
#    H = 1*(P-S)        # this worked for the example on the flat paper...
    R = 1*(S-P)
#    H = -R+(P-S)
    factor = np.array([1, 1, 1])
#    return [((3*(np.cross(H,R)*R)/(np.linalg.norm(R)**5)) -
#                                        (H/(np.linalg.norm(R)**3)))] * factor
    no = np.sqrt(R[0]**2+R[1]**2+R[2]**2)
    return [((3*(np.dot(H,R)*R)/(no**5)) -
                                        (H/(no**3)))] * factor

def funcMagY(P,S,B):
    # straight forward approach,
    # shape (12,)
    val = np.zeros(shape=(B.shape))
    for i in range(len(S)):
        b = 0.
        for j in range(len(P)/3):
            b += evalfuncMagDot(P[j*3:j*3+3],S[i])
        val[i*3:i*3+3] = b
    res = np.linalg.norm(B - val)
    return res

def evalfuncMagMulti(P,S):
    # F matrix has the shape like in the paper
    F = np.zeros((len(S)*3,len(P)/3))     #version 1: F.shape(12,4)  B.shape(12,1)
    for i in range(len(S)):
        for j in range(int(len(P)/3)):
            F[:,j][i*3:i*3+3] = evalfuncMagDot(P[j*3:j*3+3],S[i]).T.reshape((3,))
#    F = np.zeros((len(S),len(P)))     #version 2: F.shape(4,12)    B.shape(4,3)
#    for i in range(len(S)):
#        for j in range(int(len(P)/3)):
#            F[i][j*3:j*3+3] = evalfuncMagDot(P[j*3:j*3+3],S[i])
    return F

def funcMagYmulti(P,S,B):
    # advanced approach with pseudo-inverse...
    val = evalfuncMagMulti(P,S)
#    ident = np.identity(len(S))    # version 1
    ident = np.identity(len(P))    # version 2
#    print "matrix\n", val
    res = np.linalg.norm((ident-np.mat(val)*np.mat(np.linalg.pinv(val)))*np.mat(B).T)    # version 1
#    res = np.linalg.norm((ident-np.mat(val)*np.mat(np.linalg.pinv(val)))*np.mat(B).T)    # version 2
#    valPlus=np.dot(inv(np.dot(val.T,val)),val.T)
#    res = np.linalg.norm(B-(np.dot(val,np.dot(valPlus,B))))
    return res

def estimatePos(P,S,B,cnt,bnds=None,jacobian=None):
    """returns the estimated position (using Cython function)

    Parameters
    ----------
    P : array
        the initial guess of the position
    S : array
        the position of the sensor
    B : array
        the magnetic field
    bnds : tuple
            the lower and upper bounds for the position coordinates
            ((lbx,ubx),(lby,uby),(lbz,ubz))

    Returns
    -------
    res.x : array
        the result of the minimize function, i.e. the estimated position

    """

#    opt = ({'maxiter':100})
    '''   advanced approach (pseudo-inverse thing)  '''
#    val = minimize(funcMagYmulti, P, args=(S,B), method='slsqp',
#                   tol=1e-5, bounds=bnds, jac=jacobian)
    '''    straight forward approach norm(B(estPos)-B(measured))    '''
#    val = minimize(funcMagY, P, args=(S,B), method='slsqp',
#                   tol=1e-4, bounds=bnds, jac=jacobian, options=opt)
    val = minimize(fcn.funcMagY_cy, P, args=(S,B), method='slsqp',
                    bounds=bnds, jac=jacobian)

    if val.success:
        return val        # as result you will get the P vector!
    else:
        print "No solution found! Iteration Nr ",cnt
        print "Error message ",val.message
        return val


def estimatePosPy(P,S,B,cnt,bnds=None,jacobian=None):
    """returns the estimated position (using Python function)

    Parameters
    ----------
    P : array
        the initial guess of the position
    S : array
        the position of the sensor
    B : array
        the magnetic field
    bnds : tuple
            the lower and upper bounds for the position coordinates
            ((lbx,ubx),(lby,uby),(lbz,ubz))

    Returns
    -------
    res.x : array
        the result of the minimize function, i.e. the estimated position

    """
    opt = ({'maxiter':100})
    '''   advanced approach (pseudo-inverse thing)  '''
    val = minimize(funcMagYmulti, P, args=(S,B), method='slsqp',
                   tol=1e-5, bounds=bnds, jac=jacobian)
    '''    straight forward approach norm(B(estPos)-B(measured))    '''
#    val = minimize(funcMagY, P, args=(S,B), method='slsqp',
#                   tol=1e-4, bounds=bnds, jac=jacobian, options=opt)
    if val.success:

        return val        # as result you will get the P vector!
    else:
        print "No solution found! Iteration Nr ",cnt
        print "Error message ",val.message
        return val

"""
estimating the angles
"""

def xPos(angle,phal,off):
    return (phal[0]*np.cos(angle[0])+
            phal[1]*np.cos((angle[0])+(angle[1]))+
            phal[2]*np.cos((angle[0])+(angle[1])+(angle[2]))+off)

# for simplicity neglect it...
def yPos(angle,phal,off):
    return off

def zPos(angle,phal,off):
    return (phal[0]*np.sin((angle[0]))+
            phal[1]*np.sin((angle[0])+(angle[1]))+
            phal[2]*np.sin((angle[0])+(angle[1])+(angle[2])))*-1+off

def calcPosition_s(angle,phal,offSet):
    res = np.array([xPos(angle,phal,offSet[0]),
                    yPos(angle,phal,offSet[1]),
                    zPos(angle,phal,offSet[2])])
    return res

def posFun_s(angle,pos,phal,off):
#    print "angle", angle
#    print "pos", pos
#    print "off", off
    estimated = calcPosition_s(angle,phal,off)
    diff = pos - estimated
#    print "diff: ", diff
    res = np.linalg.norm(diff)
    return res

def estimateAngle_s(pos,guess,off,phal,bnds):
    """estimate the angle(rad) for a position (using Python function)

    Parameters
    ----------
    pos : array
        the position
    guess : array
        initial guess for the angle (in rad)
    off : array
        the offset of the finger joint
    phal : array
        length of the three phalanges (proximal, middle, distal)
    bnds : tuple
            the (static) lower and upper bounds for the angle
            ((lbx,ubx),(lby,uby),(lbz,ubz))

    Returns
    -------
    res.x : array
        the result of the minimize function, i.e. the estimated position

    """
#    print "bla"
    res = minimize(posFun_s,guess,args=(pos,phal,off),method='slsqp',
                   bounds=bnds)
    return res



def calcPosition_m(angle,phal,offSet):
    res = np.zeros((12,))
    for i in range(4):
        res[i*3:i*3+3] = np.array([xPos(angle[i*3:i*3+3],phal[i*3:i*3+3],offSet[i*3]),
                            yPos(angle[i*3:i*3+3],phal[i*3:i*3+3],offSet[i*3+1]),
                            zPos(angle[i*3:i*3+3],phal[i*3:i*3+3],offSet[i*3+2])])
    return res

def posFun_m(angle,pos,phal,off):
#    print "angle", angle
#    print "pos", pos
#    print "off", off
    estimated = calcPosition_m(angle,phal,off)
    diff = estimated - pos
#    print "diff: ", diff
    res = np.linalg.norm(diff)
    print "function ",res
    return res

def estimateAngle_m(pos,guess,off,phal,bnds):
    """estimate the angle(rad) for a position (using Python function)

    Parameters
    ----------
    pos : array
        the position
    guess : array
        initial guess for the angle (in rad)
    off : array
        the offset of the finger joint
    phal : array
        length of the three phalanges (proximal, middle, distal)
    bnds : tuple
            the (static) lower and upper bounds for the angle
            ((lbx,ubx),(lby,uby),(lbz,ubz))

    Returns
    -------
    res.x : array
        the result of the minimize function, i.e. the estimated position

    """
    # normal version
#    res = minimize(posFun_m,guess,args=(pos,phal,off),method='slsqp',
#                   bounds=bnds,tol=1e-12)
    # calling the cython function
    res = minimize(fcn.posFun_cy,guess,args=(pos,phal,off),method='slsqp',
                   bounds=bnds)
#    res = fcn.estimateAngle_mCy(pos,guess,off,phal,bnds)

    return res


"""
describing the whole estimation as angle-estimation
"""

def angToP(theta,finger,off):
    finger_0 = 0.
    theta_k = 0.0
    P = np.array([(1*(finger_0*np.sin(np.pi/2.) + finger[0]*np.sin(np.pi/2-theta[0]) +              # x
                finger[1]*np.sin(np.pi/2.-theta[0]-theta[1]) +
                finger[2]*np.sin(np.pi/2.-theta[0]-theta[1]-theta[2]))+off[0]),
                ((finger[0]*np.cos(np.pi/2.-theta[0]) +                  # y
                finger[1]*np.cos(np.pi/2.-theta[0]-theta[1]) +
                finger[2]*np.cos(np.pi/2.-theta[0]-theta[1]-theta[2]))*np.sin(theta_k)+off[1]),
                (-1*(finger[0]*np.cos(np.pi/2.-theta[0]) +               # z (*-1 because you move in neg. z-direction)
                finger[1]*np.cos(np.pi/2.-theta[0]-theta[1]) +
                finger[2]*np.cos(np.pi/2.-theta[0]-theta[1]-theta[2]))*np.cos(theta_k)+off[2])])
    return P

def angToH(theta):
    # for axial magnetised cylinder magnet
    H = np.array([np.cos(-theta[0]-theta[1]-theta[2]),
                     0,
                     1*np.sin(-theta[0]-theta[1]-theta[2])])

    return H

def angToH_dia(theta):
    # for diametral magnetised cylinder magnet
    H = np.array([-np.cos(-np.pi/2+abs(-theta[0]-theta[1]-theta[2])),
                  0,
                  np.sin(-np.pi/2+abs(-theta[0]-theta[1]-theta[2]))])
    return H

def calcB(r,h):
    Br = 12.6e+03
    mu_0 = 4*np.pi*1e-07
    mu_r = 1.05
    addFact = 1
    lamb = (Br*mu_0*mu_r)/(4*np.pi)*addFact
    factor = np.array([lamb, lamb, lamb])
    no = sqrt(float(r[0]**2+r[1]**2+r[2]**2))
    b = np.array([((3*r*np.dot(h,r))/(no**5)) - (h/(no**3))])*factor
    return b[0]

def estR_simple(r,h,measB):
    dif = measB-calcB(r,h)
    no = sqrt(float(dif[0]**2+dif[1]**2+dif[2]**2))
    return no**2
    
def mini_estR_simple(r0,h,measB,bnds):    
#     res = fmin_l_bfgs_b(estR_simple,r0,args=(h,measB),bounds=bnds,approx_grad=1)
     res = minimize(estR_simple,r0,args=(h,measB),method='slsqp',bounds=bnds)
#     res = minimize(estR_simple,r0,args=(h,measB))
     return res

def estR(r,theta,measB):
    h = angToH(theta)
#    print "h: ",h
#    print "calcB: ", calcB(r,h)
    dif = measB-calcB(r,h)
#    print "dif: ", type(dif[0]**2+dif[1]**2+dif[2]**2)
    no = sqrt(float(dif[0]**2+dif[1]**2+dif[2]**2))
    return no**2

def estimateR(r0,fingerL, theta, measB,bnds=None,method='py'):
    res = fmin_l_bfgs_b(estR,r0,args=(theta,measB),bounds=bnds,approx_grad=1,pgtol=1e-10)
#    res = minimize(estR,r0,args=(theta,measB),method='slsqp',bounds=bnds)
#    res = minimize(estR,r0,args=(theta,measB))
    return res   
   
   
   
def calcB_P(p,s,h):
    Br = 12.6e+03;
    mu_0 = 4*np.pi*1e-07;
    mu_r = 1.05;
    factor = (Br*mu_0*mu_r)/(4*np.pi)
#    factor = 1
    r = s-p
#    no = sqrt(np.dot(r,r.conj()))
    no = np.sqrt(r[0]**2+r[1]**2+r[2]**2)
    b = (((3*r*np.dot(h,r))/(no**5)) - (h/(no**3)))*factor
    return b    
    
def estB(p,s,h,b):
#    dif = b-calcB_P(p,s,h)
    r = s-p
    dif = b-calcB(r,h)
    no = np.sqrt(float(dif[0]**2+dif[1]**2+dif[2]**2))
#    res = res**2
#    print "estB: ",res
    return no**2
    
def mini_estB(p,s,h,b,bnds):
    res = fmin_l_bfgs_b(estB,p,args=(s,h,b),bounds=bnds,approx_grad=1)
#    res = minimize(estB,r,args=(p,h,b),method='slsqp',bounds=bnds)
#    res = minimize(estB,r,args=(p,h,b),method='bfgs')
    return res    

def angToB(theta,finger,S,off):
    """returns the magnetic field

    Parameters
    ----------
    theta : array
            the angles of the finger
            [MCP,PIP,DIP]
    finger : array
            the length of the phalanges
            [proximal-, middle-, distal-phalange]
    off : float
        the shift of the joint in y-direction
    S : array
        the position of the sensor
    """
#    print "arguments: ", theta, " ", finger, " ", S, " ", off 
    P = angToP(theta,finger,off)
    R = S-P
    H = angToH(theta)
    res = calcB(R,H)
    return res

def funcMagY_angle(theta,finger,off,S,B):
    """The function to minimize

    Parameters
    ----------
    theta : array (concatenated)
            the angles of the finger
    finger : list (of arrays)
            the length of the phalanges
    off : list (of arrays)
        the absolute positions of the MCP
    S : list (of arrays)
        the positions of the sensors
    B : array (concatenated)
        the measured B-field
    """
    cal = np.zeros((len(S)*3,))
    for i in range(len(S)):
        for j in range(len(theta)/3):
#            th = np.array([theta[j*3], theta[j*3+1], theta[j*3+1]*(2/3)])
            tmp = angToB(theta[j*3:j*3+3],finger[j],S[i],off[j]).reshape((3,))
#            tmp = angToB(th,finger[j],S[i],off[j]).reshape((3,))
            cal[i*3:i*3+3] += tmp
    dif = B-cal
    return sqrt(np.dot(dif,dif.conj()))**2     #take the square of it!

def cobyla_cons(x):
    return np.array([x[0]-np.pi/2, x[1]-np.pi/(110/180),
                     x[2]-np.pi/2, x[3]-np.pi/(110/180),
                     x[4]-np.pi/2, x[5]-np.pi/(110/180),
                     x[6]-np.pi/2, x[7]-np.pi/(110/180)])
    

def estimate_BtoAng(theta_0, fingerL, offL, sL, measB,bnds=None,method='py'):
    """Estimates the angles for a certain (measured) B-field

    Parameters
    ----------
    theta_0 : array (concatenated)
            the angles of the finger
    fingerL : list (of arrays)
            the length of the phalanges
    offL : list (of arrays)
        the absolute positions of the MCP
    sL : list (of arrays)
        the positions of the sensors
    measB : array (concatenated)
        the measured B-field
    bnds : tuple
        the static (inequality) bounds for the angles
    """
    # python version

    # multiple sensors per finger
    if method == 'py':
        if bnds != None:
            res = minimize(funcMagY_angle_m2, theta_0,
                            args=(fingerL, sL, offL, measB),
                            method='slsqp', bounds=bnds)
        else:
            res = minimize(funcMagY_angle_m2, theta_0,
                            args=(fingerL, sL, offL, measB))


   # cython version
    if method == 'cy':
    #    res = minimize(fcn.funcMagY_angle_m2_cy, theta_0,
    #                    args=(np.reshape(fingerL,((len(fingerL)*3,))),
    #                    np.reshape(sL,((len(sL)*3,))),
    #                    np.reshape(offL,((len(offL)*3,))), measB),
    #                    method='slsqp', bounds=bnds,tol=1e-7)

#        res = fmin(fcn.funcMagY_angle_m2_cy, theta_0,
#                        args=(np.reshape(fingerL,((len(fingerL)*3,))),
#                        np.reshape(sL,((len(sL)*3,))),
#                        np.reshape(offL,((len(offL)*3,))), measB),
#                        ftol=1e-10,full_output=True, maxiter=10000, maxfun=10000)

        # res = fmin_powell(fcn.funcMagY_angle_m2_cy, theta_0,
        #                         args=(np.reshape(fingerL,((len(fingerL)*3,))),
        #                         np.reshape(sL,((len(sL)*3,))),
        #                         np.reshape(offL,((len(offL)*3,))), measB),
        #                         ftol=1e-10,full_output=True, maxiter=10000, maxfun=10000)

        #    res = minimize(fcn.funcMagY_angle_m2_cy, theta_0,
        #                    args=(np.reshape(fingerL,((len(fingerL)*3,))),
        #                    np.reshape(sL,((len(sL)*3,))),
        #                    np.reshape(offL,((len(offL)*3,))), measB),
        #                    method='bfgs',tol=1e-7)

        #    res = minimize(fcn.funcMagY_angle_m2_cy, theta_0,
        #                    args=(np.reshape(fingerL,((len(fingerL)*3,))),
        #                    np.reshape(sL,((len(sL)*3,))),
        #                    np.reshape(offL,((len(offL)*3,))),measB),
        #                     method='COBYLA',bounds=bnds)

        res = fmin_l_bfgs_b(fcn.funcMagY_angle_m2_cy, theta_0,
                           args=(np.reshape(fingerL,((len(fingerL)*3,))),
                           np.reshape(sL,((len(sL)*3,))),
                           np.reshape(offL,((len(offL)*3,))),measB),
                           bounds=bnds, approx_grad=1)

#     returning only the angles
#    return np.array([res[0:3], res[3:6], res[6:9], res[9:12]])
    return res


def angToB_m(theta,finger,S,off):
    """returns the magnetic field

    Parameters
    ----------
    theta : array
            the angles of the finger
            [MCP,PIP,DIP]
    finger : array
            the length of the phalanges
            [proximal-, middle-, distal-phalange]
    off : float
        the shift of the joint in y-direction
    S : array
        the position of the sensor
    """
#    theta = np.array([th[0],th[1],th[1]*(2/3)])

    P = angToP(theta,finger,off)
    H = angToH(theta)
    cnt = 0
    res = np.zeros((len(S)*3,))
    for i in S:
        r = i-P
        tmp = calcB(r,H)
        res[cnt:cnt+3] = tmp
        cnt += 3
    return res

def funcMagY_angle_m(theta,finger,S,off,B):
    """The function to minimize

    Parameters
    ----------
    theta : array (concatenated)
            the angles of the finger
    finger : list (of arrays)
            the length of the phalanges
    off : list (of arrays)
        the y-shift of the joint
    S : list (of arrays)
        the positions of the sensors
    B : array (concatenated)
        the measured B-field
    """
    if len(S)*3 != len(B):
        print "wrong number of sensors, to corresponding B-fields!"
        return 0
    elif len(finger) != len(off):
        print "wrong number of fingerlength, to finger offsets!"
        return 0
    else:
        cal = np.zeros((len(S)*3,))
        for j in range(len(finger)):
            #th = np.array([theta[j*3], theta[j*3+1], theta[j*3+1]*(2/3)])
            tmp = angToB_m(th,finger[j],S,off[j])
#            tmp = angToB_m(theta[j*3:j*3+3],finger[j],S,off[j])
            cal += tmp
        dif = B-cal
        return sqrt(np.dot(dif,dif.conj()))**2     #take the square of it!

def angToP_2(theta,finger,off):
    finger_0 = 0.
    theta_k = 0.0
    if len(theta) == 2:
        P = np.array([(1*(finger_0*np.sin(np.pi/2) + finger[0]*np.sin(np.pi/2-theta[0]) +              # x
                    finger[1]*np.sin(np.pi/2-theta[0]-theta[1]) +
                    finger[2]*np.sin(np.pi/2-theta[0]-theta[1]-theta[1]*(2/3)))+off[0]),
                    (-1*(finger[0]*np.cos(np.pi/2-theta[0]) +               # z (*-1 because you move in neg. z-direction)
                    finger[1]*np.cos(np.pi/2-theta[0]-theta[1]) +
                    finger[2]*np.cos(np.pi/2-theta[0]-theta[1]-theta[1]*(2/3)))*np.cos(theta_k)+off[1])])
        return P
    else:
        P = np.array([(1*(finger_0*np.sin(np.pi/2) + finger[0]*np.sin(np.pi/2-theta[0]) +              # x
                finger[1]*np.sin(np.pi/2-theta[0]-theta[1]) +
                finger[2]*np.sin(np.pi/2-theta[0]-theta[1]-theta[2]))+off[0]),
                ((finger[0]*np.cos(np.pi/2-theta[0]) +                  # y
                finger[1]*np.cos(np.pi/2-theta[0]-theta[1]) +
                finger[2]*np.cos(np.pi/2-theta[0]-theta[1]-theta[2]))*np.sin(theta_k)+off[1]),
                (-1*(finger[0]*np.cos(np.pi/2-theta[0]) +               # z (*-1 because you move in neg. z-direction)
                finger[1]*np.cos(np.pi/2-theta[0]-theta[1]) +
                finger[2]*np.cos(np.pi/2-theta[0]-theta[1]-theta[2]))*np.cos(theta_k)+off[2])])
    return P

def angToH_2(theta):
    if len(theta) == 2:
        H = np.array([np.cos(-theta[0]-theta[1]-theta[1]*(2/3)),
                      1*np.sin(-theta[0]-theta[1]-theta[1]*(2/3))])
        return H
    else:
          H = np.array([np.cos(-theta[0]-theta[1]-theta[1]*(2/3)),
                        0,
                        1*np.sin(-theta[0]-theta[1]-theta[1]*(2/3))])
          return H

def calcB_2(r,h):
    factor = np.array([1/(4*np.pi),0. , 1/(4*np.pi)])
#    factor = 1/(4*np.pi)
    no = sqrt(np.dot(r,r.conj()))
    b = np.array([((3*r*np.dot(h,r))/(no**5)) - (h/(no**3))])*factor
    return b

def angToB_m2(theta,finger,S,off):
    """returns the magnetic field

    Parameters
    ----------
    theta : array
            the angles of the finger
            [MCP,PIP,DIP]
    finger : array
            the length of the phalanges
            [proximal-, middle-, distal-phalange]
    off : float
        the shift of the joint in y-direction
    S : array
        the position of the sensor
    """
#    if len(theta) == 2:
    theta = np.array([theta[0], theta[1], theta[1]*(2./3.)])
    P = angToP(theta,finger,off)
    H = angToH(theta)
    size = len(S[0])
    cnt = 0
    res = np.zeros((len(S)*size,))
    for i in S:
        r = i-P
#        print "R for theta: ",theta," : ", r
#        a = calcB_2(r,H)
        a = calcB(r,H)
        res[cnt*size:cnt*size+size] = a
        cnt += 1

    return res

def funcMagY_angle_m2(theta,finger,S,off,B):
    """The function to minimize

    Parameters
    ----------
    theta : array (concatenated)
            the angles of the finger
    finger : list (of arrays)
            the length of the phalanges
    off : list (of arrays)
        the y-shift of the joint
    S : list (of arrays)
        the positions of the sensors
    B : array (concatenated)
        the measured B-field
    """
    if len(S)*3 != len(B):
        print "wrong number of sensors, to corresponding B-fields!"
        return 0
    elif len(finger) != len(off):
        print "wrong number of fingerlength, to finger offsets!"
        return 0
    else:
        cal = np.zeros((len(S)*3,))
        for j in range(len(finger)):
            th = np.array([theta[j*2], theta[j*2+1], theta[j*2+1]*2/3])
            tmp = angToB_m(th,finger[j],S,off[j])
#            tmp = angToB_m(theta[j*3:j*3+3],finger[j],S,off[j])
            cal += tmp
        dif = B-cal
        return sqrt(np.dot(dif,dif.conj()))**2     #take the square of it!





"""
calculating the jacobi
"""

def calcJacobi():
    x,y,z = symbols('x y z')
    s0,s1,s2 = symbols('s0 s1 s2')
    bx,by,bz = symbols('bx by bz')

    #H0,H1,H2 = symbols('H0 H1 H2')
    #R0,R1,R2 = symbols('R0 R1 R2')

    P = np.array([x,y,z])
    #H = np.array([H1,H2,H3])
    #R = np.array([R1,R2,R3])
    s0 = np.array([s0,s1,s2])
    H = P-s0
    R = s0-P


    fun = np.array([(3*(np.cross(H,R)*R)/(sqrt(R[0]**2+R[1]**2+R[2]**2)**5)) -
                    (H/(sqrt(R[0]**2+R[1]**2+R[2]**2))**3)])

    global symJac,norPrime
    symJac = Matrix([[fun[0][0].diff(x), fun[0][0].diff(y), fun[0][0].diff(z)],
                     [fun[0][1].diff(x), fun[0][1].diff(y), fun[0][1].diff(z)],
                     [fun[0][2].diff(x), fun[0][2].diff(y), fun[0][2].diff(z)]])

    nor =  sqrt((bx-np.sum(symJac[0:3]))**2+
                (by-np.sum(symJac[3:6]))**2+
                (bz-np.sum(symJac[6:9]))**2)

#    norPrime = np.zeros((3,1))

    norPrime = Matrix([[nor.diff(x)],
                         [nor.diff(y)],
                         [nor.diff(z)]])

    return norPrime

def jaco(P,S,B):
#    print "P ", P.shape
#    print "S ", S[0][0]
#    print "B ", B
#    print "symJac\n", symJac
    s0,s1,s2,x,y,z=symbols('s0 s1 s2 x y z')
    bx,by,bz = symbols('bx by bz')
    funSubst = np.zeros((12,1))
    res = np.zeros((12,1))
    for i in range(len(S)):
        tmp = np.zeros((3,1))
        for j in range(len(P)/3):
#                if funSubst.any()!=0:
            tmp += np.array(norPrime.subs({s0:S[i][0],s1:S[i][1],s2:S[i][2],
                                         x:P[j*3],y:P[j*3+1],z:P[j*3+2],
                                         bx:B[i*3],by:B[i*3+1],bz:B[i*3+2]}))
#                else:
#                    funSubst = np.array(symJac.subs({s0:S[i][0],s1:S[i][1],s2:S[i][2],
#                                                      x:P[j*3],y:P[j*3+1],z:P[j*3+2]}))
        funSubst[i*3] += tmp[0]
        funSubst[i*3+1] += tmp[1]
        funSubst[i*3+2] += tmp[2]

#        print funSubst

# diverentiate the norm now...
#    root=0
#    for i in range(12):
#        root += (B[i]-funSubst[i])**2
#    for i in range(12):
#        res[i] = (funSubst[i]-B[i])/sqrt(root)


#    res = funSubst.tolist()
#    funSubst = np.append(funSubst,[0.,0.,0.])
    print "res ", res
    return funSubst
