MuellerDaniel/SensGlove/python/EKF.py

from __future__ import division
import numpy as np
import modelDip as modD


def jacoCalcB(rx,ry,rz):
    ''' First derivative of dipole model for H = [1,0,0]
        imported from Matlab... '''
    J = np.array([
        [(18303781807138305.*rx)/(2305843009213693952.*(abs(rx)**2 + abs(ry)**2 + abs(rz)**2)**(5./2)) + (18303781807138305.*abs(rx)*np.sign(rx))/(4611686018427387904.*(abs(rx)**2 + abs(ry)**2 + abs(rz)**2)**(5./2)) - (91518909035691525.*rx**2*abs(rx)*np.sign(rx))/(4611686018427387904.*(abs(rx)**2 + abs(ry)**2 + abs(rz)**2)**(7./2)),
         (18303781807138305.*abs(ry)*np.sign(ry))/(4611686018427387904.*(abs(rx)**2 + abs(ry)**2 + abs(rz)**2)**(5./2)) - (91518909035691525.*rx**2*abs(ry)*np.sign(ry))/(4611686018427387904.*(abs(rx)**2 + abs(ry)**2 + abs(rz)**2)**(7./2)),
         (18303781807138305.*abs(rz)*np.sign(rz))/(4611686018427387904.*(abs(rx)**2 + abs(ry)**2 + abs(rz)**2)**(5./2)) - (91518909035691525.*rx**2*abs(rz)*np.sign(rz))/(4611686018427387904.*(abs(rx)**2 + abs(ry)**2 + abs(rz)**2)**(7./2))],

        [ (18303781807138305.*ry)/(4611686018427387904.*(abs(rx)**2 + abs(ry)**2 + abs(rz)**2)**(5./2)) - (91518909035691525.*rx*ry*abs(rx)*np.sign(rx))/(4611686018427387904.*(abs(rx)**2 + abs(ry)**2 + abs(rz)**2)**(7./2)),
         (18303781807138305.*rx)/(4611686018427387904.*(abs(rx)**2 + abs(ry)**2 + abs(rz)**2)**(5./2)) - (91518909035691525.*rx*ry*abs(ry)*np.sign(ry))/(4611686018427387904.*(abs(rx)**2 + abs(ry)**2 + abs(rz)**2)**(7./2)),
        -(91518909035691525.*rx*ry*abs(rz)*np.sign(rz))/(4611686018427387904.*(abs(rx)**2 + abs(ry)**2 + abs(rz)**2)**(7./2))],

        [(18303781807138305.*rz)/(4611686018427387904.*(abs(rx)**2 + abs(ry)**2 + abs(rz)**2)**(5./2)) - (91518909035691525.*rx*rz*abs(rx)*np.sign(rx))/(4611686018427387904.*(abs(rx)**2 + abs(ry)**2 + abs(rz)**2)**(7./2)),
         -(91518909035691525.*rx*rz*abs(ry)*np.sign(ry))/(4611686018427387904.*(abs(rx)**2 + abs(ry)**2 + abs(rz)**2)**(7./2)),
         (18303781807138305.*rx)/(4611686018427387904.*(abs(rx)**2 + abs(ry)**2 + abs(rz)**2)**(5./2)) - (91518909035691525.*rx*rz*abs(rz)*np.sign(rz))/(4611686018427387904.*(abs(rx)**2 + abs(ry)**2 + abs(rz)**2)**(7./2))]])

    return J


def jacoAngToB(mcp, dip):
    ''' First derivative of model equation for
        - ONE finger and ONE sensor (using the dipole model)
        - using fixed finger, joint and sensor position values, described in handDim.py
        - handDim.phalInd, handDim.jointInd_car, handDim.sInd_car '''

#    J = np.array([
#        [(6101260602379435*np.sin((5*dip)/3 + mcp))/(4611686018427387904*(abs((2581*np.cos(dip - np.pi/2 + mcp))/100000 + (839*np.cos((5*dip)/3 - np.pi/2 + mcp))/50000 + (77*np.cos(mcp - np.pi/2))/2500 + 1/250)**2 + abs((2581*np.sin(dip - np.pi/2 + mcp))/100000 + (839*np.sin((5*dip)/3 - np.pi/2 + m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
#        (30506303011897175*np.sin((5*dip)/3 + mcp))/(13835058055282163712*(abs((2581*np.cos(dip - np.pi/2 + mcp))/100000 + (839*np.cos((5*dip)/3 - np.pi/2 + mcp))/50000 + (77*np.cos(mcp - np.pi/2))/2500 + 1/250)**2 + abs((2581*np.sin(dip - np.pi/2 + mcp))/100000 + (839*np.sin((5*dip)/3 - np.pi/2 + 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
#        [0.,
#         0.],
#        [(6101260602379435*np.cos((5*dip)/3 + mcp))/(4611686018427387904*(abs((2581*np.cos(dip - np.pi/2 + mcp))/100000 + (839*np.cos((5*dip)/3 - np.pi/2 + mcp))/50000 + (77*np.cos(mcp - np.pi/2))/2500 + 1/250)**2 + abs((2581*np.sin(dip - np.pi/2 + mcp))/100000 + (839*np.sin((5*dip)/3 - np.pi/2 + m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
#         (30506303011897175*np.cos((5*dip)/3 + mcp))/(13835058055282163712*(abs((2581*np.cos(dip - np.pi/2 + mcp))/100000 + (839*np.cos((5*dip)/3 - np.pi/2 + mcp))/50000 + (77*np.cos(mcp - np.pi/2))/2500 + 1/250)**2 + abs((2581*np.sin(dip - np.pi/2 + mcp))/100000 + (839*np.sin((5*dip)/3 - np.pi/2 +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

    J = np.array([[(6101260602379435*np.sin((5*dip)/3 + mcp))/(4611686018427387904*(abs((77*np.cos(mcp - np.pi/2))/2500 + (2581*np.cos(dip + mcp - np.pi/2))/100000 + (839*np.cos((5*dip)/3 + mcp - np.pi/2))/50000 + 1/250)**2 + abs((77*np.sin(mcp - np.pi/2))/2500 + (2581*np.sin(dip + mcp - np.pi/2))/1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
          (30506303011897175*np.sin((5*dip)/3 + mcp))/(13835058055282163712*(abs((77*np.cos(mcp - np.pi/2))/2500 + (2581*np.cos(dip + mcp - np.pi/2))/100000 + (839*np.cos((5*dip)/3 + mcp - np.pi/2))/50000 + 1/250)**2 + abs((77*np.sin(mcp - np.pi/2))/2500 + (2581*np.sin(dip + mcp - np.pi/2))/100000 +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
          [0,
          0],
          [(6101260602379435*np.cos((5*dip)/3 + mcp))/(4611686018427387904*(abs((77*np.cos(mcp - np.pi/2))/2500 + (2581*np.cos(dip + mcp - np.pi/2))/100000 + (839*np.cos((5*dip)/3 + mcp - np.pi/2))/50000 + 1/250)**2 + abs((77*np.sin(mcp - np.pi/2))/2500 + (2581*np.sin(dip + mcp - np.pi/2))/100000 + 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
          (30506303011897175*np.cos((5*dip)/3 + mcp))/(13835058055282163712*(abs((77*np.cos(mcp - np.pi/2))/2500 + (2581*np.cos(dip + mcp - np.pi/2))/100000 + (839*np.cos((5*dip)/3 + mcp - np.pi/2))/50000 + 1/250)**2 + abs((77*np.sin(mcp - np.pi/2))/2500 + (2581*np.sin(dip + mcp - np.pi/2))/100000 +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


    return J


def EKF_predict_dip(x, P_old, Q):

    x_pred = x
    P_pred = P_old + Q

    return (x_pred, P_pred)



def EKF_update_dip(jaco, meas, x_pred, P_pred, R):

    c = jaco(x_pred[0], x_pred[1], x_pred[2])

    g = np.dot(np.dot(P_pred, c.T), np.linalg.inv(np.dot(np.dot(c, P_pred), c.T) + R))

    x_now = x_pred + np.dot(g, (meas - modD.calcB(x_pred,np.array([1., 0., 0]))))
#    dif = meas - calcB_dip(x_pred(1:3)',[1 0 0])'

    P_now = np.dot((np.eye(3) - np.dot(g, c)), P_pred)

    return (x_now, P_now)
