MuellerDaniel/SensGlove/SensGlove_noVideo/arduino/MagAHRS_MUX_LSM303_Ser/AHRSupdate.ino

void AHRSupdate(float *dt) {
  static float gx;
  static float gy;
  static float gz;
  static float ax;
  static float ay;
  static float az;
  static float mx;
  static float my;
  static float mz;


  static float recipNorm;
  static float s0, s1, s2, s3;
  static float qDot1, qDot2, qDot3, qDot4;
  static float hx, hy;
  static float _2q0mx, _2q0my, _2q0mz, _2q1mx, _2bx, _2bz, _4bx, _4bz, _2q0, _2q1, _2q2, _2q3, _2q0q2, _2q2q3, q0q0, q0q1, q0q2, q0q3, q1q1, q1q2, q1q3, q2q2, q2q3, q3q3;

  gx = ToRad((gyro.g.x - offSetX) * GYRO_SCALE);
  gy = ToRad((gyro.g.y - offSetY) * GYRO_SCALE);
  gz = ToRad((gyro.g.z - offSetZ) * GYRO_SCALE);

  ax = -1.0 * compass.a.x;
  ay = -1.0 * compass.a.y;
  az = -1.0 * compass.a.z;

  mx = floatMagX;
  my = floatMagY;
  mz = floatMagZ;
  // Rate of change of quaternion from gyroscope
  qDot1 = 0.5f * (-q1 * gx - q2 * gy - q3 * gz);
  qDot2 = 0.5f * (q0 * gx + q2 * gz - q3 * gy);
  qDot3 = 0.5f * (q0 * gy - q1 * gz + q3 * gx);
  qDot4 = 0.5f * (q0 * gz + q1 * gy - q2 * gx);

  magnitude = sqrt(ax * ax + ay * ay + az * az);

  if ((magnitude > 384) || (magnitude < 128)){
    ax = 0;
    ay = 0;
    az = 0;
  }

  // Compute feedback only if accelerometer measurement valid (avoids NaN in accelerometer normalisation)
  if(!((ax == 0.0f) && (ay == 0.0f) && (az == 0.0f))) {


    // Normalise accelerometer measurement
    recipNorm = invSqrt(ax * ax + ay * ay + az * az);
    ax *= recipNorm;
    ay *= recipNorm;
    az *= recipNorm;
    // Normalise magnetometer measurement
    recipNorm = invSqrt(mx * mx + my * my + mz * mz);
    mx *= recipNorm;
    my *= recipNorm;
    mz *= recipNorm;
    // Auxiliary variables to avoid repeated arithmetic
    _2q0mx = 2.0f * q0 * mx;
    _2q0my = 2.0f * q0 * my;
    _2q0mz = 2.0f * q0 * mz;
    _2q1mx = 2.0f * q1 * mx;
    _2q0 = 2.0f * q0;
    _2q1 = 2.0f * q1;
    _2q2 = 2.0f * q2;
    _2q3 = 2.0f * q3;
    _2q0q2 = 2.0f * q0 * q2;
    _2q2q3 = 2.0f * q2 * q3;
    q0q0 = q0 * q0;
    q0q1 = q0 * q1;
    q0q2 = q0 * q2;
    q0q3 = q0 * q3;
    q1q1 = q1 * q1;
    q1q2 = q1 * q2;
    q1q3 = q1 * q3;
    q2q2 = q2 * q2;
    q2q3 = q2 * q3;
    q3q3 = q3 * q3;

    // Reference direction of Earth's magnetic field
    hx = mx * q0q0 - _2q0my * q3 + _2q0mz * q2 + mx * q1q1 + _2q1 * my * q2 + _2q1 * mz * q3 - mx * q2q2 - mx * q3q3;
    hy = _2q0mx * q3 + my * q0q0 - _2q0mz * q1 + _2q1mx * q2 - my * q1q1 + my * q2q2 + _2q2 * mz * q3 - my * q3q3;
    _2bx = sqrt(hx * hx + hy * hy);
    _2bz = -_2q0mx * q2 + _2q0my * q1 + mz * q0q0 + _2q1mx * q3 - mz * q1q1 + _2q2 * my * q3 - mz * q2q2 + mz * q3q3;
    _4bx = 2.0f * _2bx;
    _4bz = 2.0f * _2bz;

    // Gradient decent algorithm corrective step
    s0 = -_2q2 * (2.0f * q1q3 - _2q0q2 - ax) + _2q1 * (2.0f * q0q1 + _2q2q3 - ay) - _2bz * q2 * (_2bx * (0.5f - q2q2 - q3q3) + _2bz * (q1q3 - q0q2) - mx) + (-_2bx * q3 + _2bz * q1) * (_2bx * (q1q2 - q0q3) + _2bz * (q0q1 + q2q3) - my) + _2bx * q2 * (_2bx * (q0q2 + q1q3) + _2bz * (0.5f - q1q1 - q2q2) - mz);
    s1 = _2q3 * (2.0f * q1q3 - _2q0q2 - ax) + _2q0 * (2.0f * q0q1 + _2q2q3 - ay) - 4.0f * q1 * (1 - 2.0f * q1q1 - 2.0f * q2q2 - az) + _2bz * q3 * (_2bx * (0.5f - q2q2 - q3q3) + _2bz * (q1q3 - q0q2) - mx) + (_2bx * q2 + _2bz * q0) * (_2bx * (q1q2 - q0q3) + _2bz * (q0q1 + q2q3) - my) + (_2bx * q3 - _4bz * q1) * (_2bx * (q0q2 + q1q3) + _2bz * (0.5f - q1q1 - q2q2) - mz);
    s2 = -_2q0 * (2.0f * q1q3 - _2q0q2 - ax) + _2q3 * (2.0f * q0q1 + _2q2q3 - ay) - 4.0f * q2 * (1 - 2.0f * q1q1 - 2.0f * q2q2 - az) + (-_4bx * q2 - _2bz * q0) * (_2bx * (0.5f - q2q2 - q3q3) + _2bz * (q1q3 - q0q2) - mx) + (_2bx * q1 + _2bz * q3) * (_2bx * (q1q2 - q0q3) + _2bz * (q0q1 + q2q3) - my) + (_2bx * q0 - _4bz * q2) * (_2bx * (q0q2 + q1q3) + _2bz * (0.5f - q1q1 - q2q2) - mz);
    s3 = _2q1 * (2.0f * q1q3 - _2q0q2 - ax) + _2q2 * (2.0f * q0q1 + _2q2q3 - ay) + (-_4bx * q3 + _2bz * q1) * (_2bx * (0.5f - q2q2 - q3q3) + _2bz * (q1q3 - q0q2) - mx) + (-_2bx * q0 + _2bz * q2) * (_2bx * (q1q2 - q0q3) + _2bz * (q0q1 + q2q3) - my) + _2bx * q1 * (_2bx * (q0q2 + q1q3) + _2bz * (0.5f - q1q1 - q2q2) - mz);
    recipNorm = invSqrt(s0 * s0 + s1 * s1 + s2 * s2 + s3 * s3); // normalise step magnitude
    s0 *= recipNorm;
    s1 *= recipNorm;
    s2 *= recipNorm;
    s3 *= recipNorm;

    // Apply feedback step
    qDot1 -= beta * s0;
    qDot2 -= beta * s1;
    qDot3 -= beta * s2;
    qDot4 -= beta * s3;
  }

  // Integrate rate of change of quaternion to yield quaternion
  q0 += qDot1 * *dt;
  q1 += qDot2 * *dt;
  q2 += qDot3 * *dt;
  q3 += qDot4 * *dt;

  // Normalise quaternion
  recipNorm = invSqrt(q0 * q0 + q1 * q1 + q2 * q2 + q3 * q3);
  q0 *= recipNorm;
  q1 *= recipNorm;
  q2 *= recipNorm;
  q3 *= recipNorm;
}


void relQuat(){

  // delta quat q_delta = q*(q_I**-1)
  // because q_I is a unit quaternion: q_I**-1 = conj(q_I) = q0_I; -q1_I; -q2_I; -q3_I
  /*float a = q0*q0_I - q1*q1_I - q2*q2_I - q3*q3_I;    
  float b = q0*q1_I + q1*q0_I + q2*q3_I - q3*q2_I;
  float c = q0*q2_I - q1*q3_I + q2*q0_I + q3*q1_I;
  float d = q0*q3_I + q1*q2_I - q2*q1_I + q3*q0_I;*/
  float a = q0*q0_I + q1*q1_I + q2*q2_I + q3*q3_I;    
  float b = q0*q1_I - q1*q0_I - q2*q3_I + q3*q2_I;
  float c = q0*q2_I + q1*q3_I - q2*q0_I - q3*q1_I;
  float d = q0*q3_I - q1*q2_I + q2*q1_I - q3*q0_I;
  a = 1.0*a;    // is this necessary???
  b = -1.0*b;
  c = -1.0*c;
  d = -1.0*d;

  float rot11 = a*a+b*b-c*c-d*d;
  float rot12 = 2*(b*c+a*d);
  float rot13 = 2*(b*d-a*c);
  float rot21 = 2*(b*c-a*d);
  float rot22 = a*a-b*b+c*c-d*d;
  float rot23 = 2*(c*d+a*b);
  float rot31 = 2*(b*d+a*c);
  float rot32 = 2*(c*d-a*b);
  float rot33 = a*a-b*b-c*c+d*d;
  
  //float rotB[3];
  for(int i=0; i<sensCnt; i++){
    rotB[i][0] = rot11*mag_I[i][0] + rot12*mag_I[i][1] + rot13*mag_I[i][2];
    rotB[i][1] = rot21*mag_I[i][0] + rot22*mag_I[i][1] + rot23*mag_I[i][2];
    rotB[i][2] = rot31*mag_I[i][0] + rot32*mag_I[i][1] + rot33*mag_I[i][2];
  }
}
