MuellerDaniel/SensGlove/python/txtWrite.py

import subprocess, time

def doEstimation(counter):
    toSend = ("0.0000 0.0000 0.0000 " +
                "0.0000 0.0000 0.0000 "+
                "0.0000 "+"{0:.4f} ".format(counter)+"0.0000 "+
                "0.0000 0.0000 0.0000 "+
                "0.0000 0.0000 0.0000")
    time.sleep(0.3)
    return toSend

fileName = "estAngles.txt"
f = open(fileName, 'w')

#cmd = "python txtRead.py " + fileName
cmd = "./../visualization/riggedAni/HandGame.blend " + fileName
subPro = subprocess.Popen(cmd.split())#, stdout=subprocess.PIPE, stdin=subprocess.PIPE)

cnt = 0.0000
while cnt < 100:
    toSend = doEstimation(cnt)
    f = open(fileName, 'w')
    f.write(toSend+'\n')
    cnt += 0.011
    print "written ", toSend
    f.close()

#f.close()
