MuellerDaniel/SensGlove/(commit log)

2015-08-11 updated arduino sketches for rfDuino
2015-08-11 representing the orientation of magnetic field as arrow
2015-09-02 rewritten moving average filter
2015-09-02 arduino code for LSM sensor
2015-09-02 estimating the position for multiple magnets and sensors
2015-09-02 for multiple magnets and sensors
    code for estimating/acquiring/VERIFIYING the datasets
2015-09-02 verify data on a wooden board
2015-09-02 estimating sensor Mid and magnet Mid
2015-09-16 added matlab stuff
    evalfuncMag_sim.m: function calculating b-field for the simulation
    objFun.m: function for the objective function
    mmain.m: script for calculating the simulation data
    smain.m: script for estimating the position of index magnet with index
    sensor
2015-09-21 3 versions for solving the problem implemented
    [150827_multMag.py, modelEqMultiTWO.py]
2015-10-06 changed axes, to match the sensorBoard
2015-10-07 played with the y-axis movement
2015-10-07 estimating angles for single finger
2015-10-23 inserted time measurements
2015-10-27 calibration of multiple sensors with MUX
2015-10-28 code for checking the calibrated output
2015-11-03 calculation of the perfect B-field, using joint-angles
2015-11-11 blender files for visualization
    [Rigged Hand.blend]
2015-11-11 remove the big files...
    [Rigged Hand.blend]
2015-11-26 for estimating a single magnet
2015-11-26 implementations for arbitrary sensors and magnets
2015-12-01 implemented multi sensor angle estimation
2015-12-03 estimation of sev. magnets, calling cython code
2015-12-03 openscad files for sensor rig and magnetring
    [first.scad, ring.scad, ring2.scad]
2015-12-04 implemented RT filtering
2015-12-13 added code for simple flat estimation
    [ring2.scad]
2016-01-19 scripts for calculating and comparing the calibration methods
2016-01-23 sketch for erasing the earth magnetic field
2016-01-23 added a calibration method for verification
2016-01-30 for a fixed sensor-finger combination
2016-01-30 for arbitrary sensor-finger combination
2016-02-01 sketch for determining the model scale factor for multiple sensors
2016-02-01 trying to derive the jacobian with casadi and sympy. Failed!
    [casadTry.py, sympyTry.py]
2016-02-01 fitting all four sensor values to the hand model
2016-02-06 finally adjusted the magnetic models
2016-02-27 evaluated leap comparison
    [results.csv, results_allH160210.csv]
2016-03-05 tex update
    [tableSets.csv]
2016-03-22 structured repository with datasets; no videos
    [Rigged Hand.blend, results_compare_xl.xlsx, ring2.scad, sensBoardv2.scad]
